akier900/Capstone_Rohde-Schwarz_Team13/Progress Reports/Feb_14_Progress.pdf

# Team 13 Progress Report (Rohde and Schwarz)

Feb 7th to Feb 14th, 2020

# Collective Team Progress

We met w ith you, our advisor about possible routes for protoyping the NLTL technology and started getting materials and components.

We arrived on Wednesday for our meeting w ith Rohde and Schw arz but unfortunately they forgot to make a standing appointment for

the proposal and w e failed to properly confirm the appointment before going dow n. We learned to alw ays put things in w riting and to

send reminders in order to avoid this in the future. We have rescheduled our proposal for Wednesday, Feb 26th at 2:00pm. If you

are able to make this meeting, that w ould be great, but understand if this doesn't w ork w ith your schedule. We have also supplied

them w ith digital copies of both the presentation w e approved on monday as w ell as the slides for our presentation for them to markup

and supply w ith feedback during our next meeting.

# Individual Member Tasks (To complete before next meeting with Industry Sponsors)

## Eric Aki

Search for Varactor SPICE models (In Progress)

Help Juan w ith modeling of varactor CV curves (In Progress)

Applied for and Recieved Free-Sample of recommended Inductors to be used for 144MHz Protoype. (Qty 10.)

## Juan Rivera

Begin Modeling of varactors CV curves as specified by industry sponsors (Matlab or ADS) (In progress)

Complete informal project proposal presentation for industry sponsors

Inquire w ith Dr. Branomir about TeraHertz Lab access

Found resources w hich present a straightforw ard w ay to go about characterizing/measuring our chosen varactor.

## Jianyu Hao

Begin Bill of Materials for project including modeling/simulation softw are and prototyping materials

Help Eric Research Varactors on Digikey

Complete informal project proposal presentation for industry sponsors

Help Eric w ith Gantt Chart.

Compile BOM and add finishing touches to Slideshow presentation

Help w ith ADS/Matlab Simulation (In Progress)

# Blocked

-[] Inquire about signing Intellectual Property forms at next Industry Sponsor Meeting
