akier900/Capstone_Rohde-Schwarz_Team13/Team Schedule/ProjectSchedule.pdf

ID | Assignment Owner | Task Mode | Task Name | Duration | Start | Finish | Predecessors | Resource Names | S
1 | | | Start | 0 days | Wed 1/8/20Wed 1/8/20 | | | Eric,Juan,Oscar
2 | | | Introductory meeting with faculty advisor | 0 days | Sun 1/12/20Sun 1/12/201 | | | Eric,Juan,Oscar
3 | | | Research | 20 days | Wed 1/15/20Tue 2/11/202
4 | | | Read and take notes on article 1 | 2 days | Wed 1/15/20Thu 1/16/202 | | | Eric
5 | | | Read and take notes on article 2 | 2 days | Wed 1/15/20Thu 1/16/202 | | | Juan
6 | | | Read and take notes on article 3 | 2 days | Wed 1/15/20Thu 1/16/202 | | | Oscar
7 | | | Hold team meeting(s) to discuss | 3 days | Mon 1/20/20Wed 1/22/204,5,6 | | | Eric,Juan,Oscar
8 | | | Compile Research Documentation | 6 days | Wed 1/22/20Wed 1/29/207 | | | Eric,Juan,Oscar
9 | | | Introductory Meeting with industry sponsors | 0 days | Wed 1/29/20Wed 1/29/208
10 | | | Refine PDS/Requirements Documentation | 3 days | Wed 2/5/20Fri 2/7/20 | | 7 | Juan
11 | | | Revise Schedule | 3 days | Thu 1/23/20Mon 1/27/207 | | | Eric
12 | | | Prepare Faculty Advisors Progress Update | 1 day | Thu 1/23/20Thu 1/23/207 | | | Oscar
13 Prepare proposal presentation for industry | | | sponsors | 10 days | Wed 1/29/20 | Tue 2/11/20 | 9 Eric,Juan,Oscar
14 | | | End of Prelim Research phase | 0 days | Tue 2/11/20Tue 2/11/2013
15 | | | Model/Simulate | 14 days | Wed 2/12/20Mon 3/2/2014
16 | | | Find Varactor options in digikey | 3 days | Wed 2/12/20Fri 2/14/20 | | 14 | Eric
17 | | | Find/create Varactor spice model or ADS model | 2 days | Wed 2/12/20Thu 2/13/2014 | | | Juan,Eric
18 | | | Simulate using ADS | 7 days | Fri 2/14/20 | Mon 2/24/2017 | | Juan
19 | | | Simulate using MATLAB | 7 days | Fri 2/14/20 | Mon 2/24/2017 | | Eric
20 | | | Compile Simulation documentation | 5 days | Tue 2/25/20Mon 3/2/2016,17,18,19 | | | Eric,Juan,Oscar
21 | | | Create/Update BOM rough draft | 3 days | Tue 2/25/20Thu 2/27/2018 | | | Eric
22 | | | Refine PDS/Requirements Documentation | 3 days | Tue 2/25/20Thu 2/27/2018 | | | Juan
23 | | | Revise Schedule | 3 days | Tue 2/25/20Thu 2/27/2018 | | | Eric
24 | | | Prepare Faculty Advisors Progress Update | 3 days | Wed 2/12/20Fri 2/14/20 | | | Eric
Project: msproj11 Date: Wed 4/22/20 | External Tasks | Manual Summary Rollup

Mar 1, '20

Task

Split

Milestone

Summary

Project Summary

External Milestone

Inactive Task

Inactive Milestone

Inactive Summary

Manual Task

Duration-only

Manual Summary

Start-only

Finish-only

Deadline

Progress

Manual Progress

Page 1

ID | Assignment Owner | Task Mode | Task Name | Duration | Start | Finish | Predecessors | Resource Names | S
25 Prepare Progress Update Presentation for | | | Industry Sponsors | 10 days | Wed 2/12/20 | Tue 2/25/20 | | Eric,Juan,Oscar
26 | | | End of Prelim Model and Simulation phase | 0 days | Thu 2/27/20Thu 2/27/2023
27 Research Board design for other Varactor loaded | | | TX Lines | 12 days | Fri 2/28/20 | Mon 3/16/20 | 26
28 Read and take notes on article (S-parameter | | | De-embedding) | 2 days | Fri 2/28/20 | Mon 3/2/20 | 26 Oscar
29 Read and take notes on article (Measuring Board | | | Characteristics) | 2 days | Fri 2/28/20 | Mon 3/2/20 | 26 Juan
30 Read and take notes on article (High Frequency | | | PCB Design) | 2 days | Fri 2/28/20 | Mon 3/2/20 | 26 Eric
31 | | | Hold team meeting to discuss | 7 days | Tue 3/3/20 | Wed 3/11/2028,29,30 | | Oscar,Juan,Eric
32 | | | Refine PDS/Requirements Documentation | 3 days | Thu 3/12/20Mon 3/16/2031 | | | Eric
33 | | | Revise Schedule | 3 days | Thu 3/12/20Mon 3/16/2031 | | | Juan
34 Prepare Progress Update Presentation for | | | Industry Sponsors | 10 days | Fri 2/28/20 | Thu 3/12/20 | | Eric,Juan,Oscar
35 | | | Prepare Faculty Advisors Progress Update | 3 days | Fri 2/28/20 | Tue 3/3/20 | | Eric
36 | | | End of Low Frequency Research | 0 days | Mon 3/16/20Mon 3/16/2033
37 | | | Initial Prototype (144Mhz) | 57 days? | Tue 3/17/20Tue 6/2/20 | | 36
38 | | | Design 144MHZ PCB in Altium | 5 days | Tue 3/17/20Mon 3/23/20 | | | Eric
39 Final board check before submission to Board | | | House | 1 day | Tue 3/24/20 | Tue 3/24/20 | | Eric,Oscar,Juan
40 | | | Place OSHPark Order | 0 days | Wed 3/25/20Wed 3/25/20 | | | Eric
41 | | | Receive boards from OSHPark | 0 days | Sat 4/4/20 | Sat 4/4/20
42 | | | Assemble Board | 1 day | Mon 4/6/20Mon 4/6/2040 | | | Eric

Mar 1, '20

Task

Split

Milestone

Summary

Project Summary

External Tasks

External Milestone

Inactive Task

Inactive Milestone

Inactive Summary

Manual Task

Duration-only

Manual Summary Rollup

Manual Summary

Start-only

Finish-only

Deadline

Progress

Manual Progress

Page 2

Project: msproj11
Date: Wed 4/22/20

ID | Assignment Owner | Task Mode | Task Name | Duration | Start | Finish | Predecessors | Resource Names | S
43 | | | Refine PDS/Requirements Documentation | 2 days | Thu 4/9/20 | Fri 4/10/20 | | Eric
44 | | | Board Continuity/Assembly Check | 0 days | Sat 4/11/20 Sat 4/11/20 | | | Eric
45 | | | Transient Simulations | 26.75 days Tue 3/17/20Tue 4/21/20
46 | | | Find values for modeling component parasitics | 5 days | Tue 3/17/20Mon 3/30/2040 | | | Eric
47 | | | Simulate Rise Time Vs. Tx Line Length | 17 days | Tue 3/17/20Tue 4/21/2046 | | | Eric
48 | | | Simulate Rise Time Vs. DC Bias | 17 days | Tue 3/17/20Tue 4/21/2046 | | | Eric
49 | | | Frequency Domain Simulations | 7 days | Tue 4/21/20Thu 4/30/2048 | | | Eric
50 | | | Measurements | 34 days | Tue 3/17/20Thu 4/30/20
51 Time Domain Rise time Measurements vs DC | | | Bias | 7 days | Tue 3/17/20 | Wed 3/25/20 | | Eric
52 | | | Frequency Domain Measurements (NanoVNA) | 11 days | Tue 4/7/20 | Tue 4/21/2042 | | Eric
53 | | | Compile/Analyze 144Mhz Measurement Results7 days | | Wed 4/22/20Thu 4/30/2052
54 | | | End of Initial Prototype phase | 0 days | Sat 4/11/20 Sat 4/11/20 44
55 | | | 6Ghz Model Research/Design | 42 days? | Mon 4/6/20Tue 6/2/20
56 | | | Transient Simulations | 12 days | Mon 4/6/20Fri 5/15/20 | | 53
57 | | | S-Param Simulations | 12 days | Fri 5/1/20 | Mon 5/18/2053
58 | | | EM Simulations | 12 days | Fri 5/1/20 | Mon 5/18/2053
59 | | | Drafting of White Paper | 11 days? | Tue 5/19/20Tue 6/2/20
60 | | | First Draft Creation | 1 day? | Tue 5/19/20Tue 5/19/2058
61 | | | First Draft Submitted to Sponsors | 0 days | Tue 5/19/20Tue 5/19/20
62 | | | Review Revisions | 5 days | Wed 5/20/20Tue 5/26/2061
63 | | | Second Draft Creation | 5 days | Wed 5/27/20Tue 6/2/20 | | 62
64 | | | Second Draft Submittal | 0 days | Tue 6/2/20 | Tue 6/2/20 | 63
65 | | | Presentation/Project Wrap up | 33 days? | Wed 4/22/20Sun 6/7/20 | | 52
66 | | | Compile all documentation | 14 days | Wed 4/22/20Mon 5/11/2026
Project: msproj11 Date: Wed 4/22/20 | External Tasks | Manual Summary Rollup

Mar 1, '20

Task

Split

Milestone

Summary

Project Summary

External Milestone

Inactive Task

Inactive Milestone

Inactive Summary

Manual Task

Duration-only

Manual Summary

Start-only

Finish-only

Deadline

Progress

Manual Progress

Page 3

ID | Assignment Owner | Task Mode | Task Name | Duration | Start | Finish | Predecessors | Resource Names | S
67 | | | Present Results to Industry Sponsors | 7 days | Tue 5/12/20Wed 5/20/2066
68 | | | Technical Work Stops (Official) | 0 days | Mon 6/1/20Mon 6/1/20
69 | | | Prepare for presentation speaking roles | 2 days? | Mon 6/1/20Tue 6/2/20
70 | | | Poster Board Creation | 5 days | Mon 6/1/20Fri 6/5/20
71 | | | Poster due for Poster Session | 0 days | Sun 6/7/20 | Sun 6/7/20

Mar 1, '20

Task

Split

Milestone

Summary

Project Summary

External Tasks

External Milestone

Inactive Task

Inactive Milestone

Inactive Summary

Manual Task

Duration-only

Manual Summary Rollup

Manual Summary

Start-only

Finish-only

Deadline

Progress

Manual Progress

Page 4

Project: msproj11
Date: Wed 4/22/20

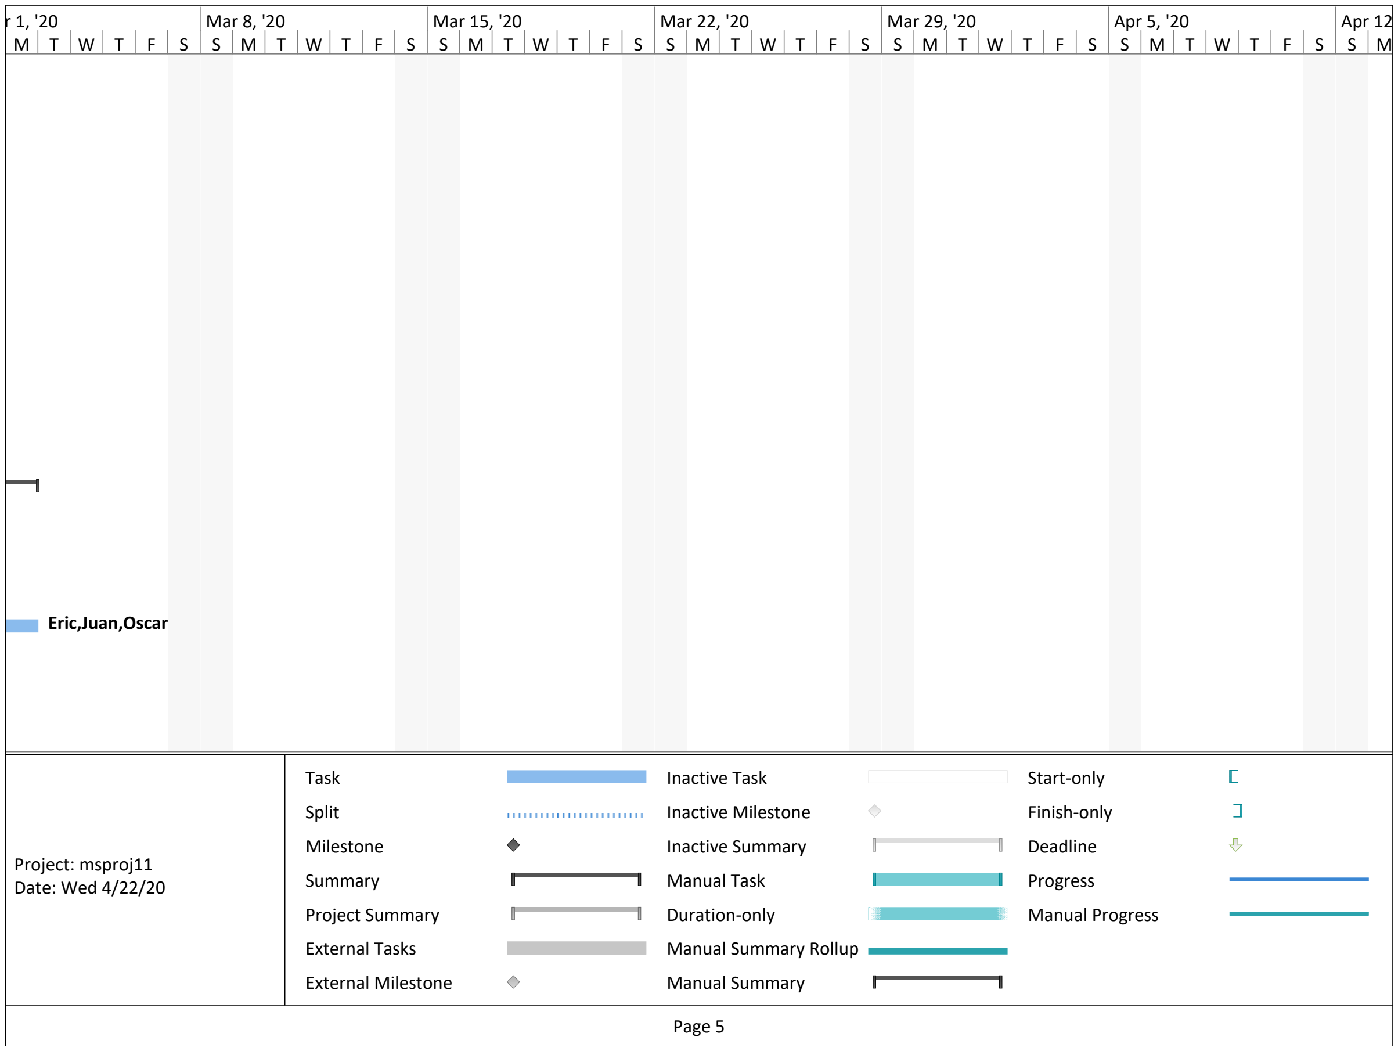
[picture p36: figure]
Eric,Juan,Oscar; Mar 8, '20; Mar 15, '20; Mar 22, '20; Mar 29, '20; Apr 5, '20; Apr 12, '20; Task; Split; Milestone; Summary; Project Summary; External Tasks; External Milestone; Inactive Task; Inactive Milestone; Inactive Summary; Manual Task; Duration-only; Manual Summary Rollup; Manual Summary; Start-only; Finish-only; Deadline; Progress; Manual Progress; Page 5; Project: msproj11 Date: Wed 4/22/20
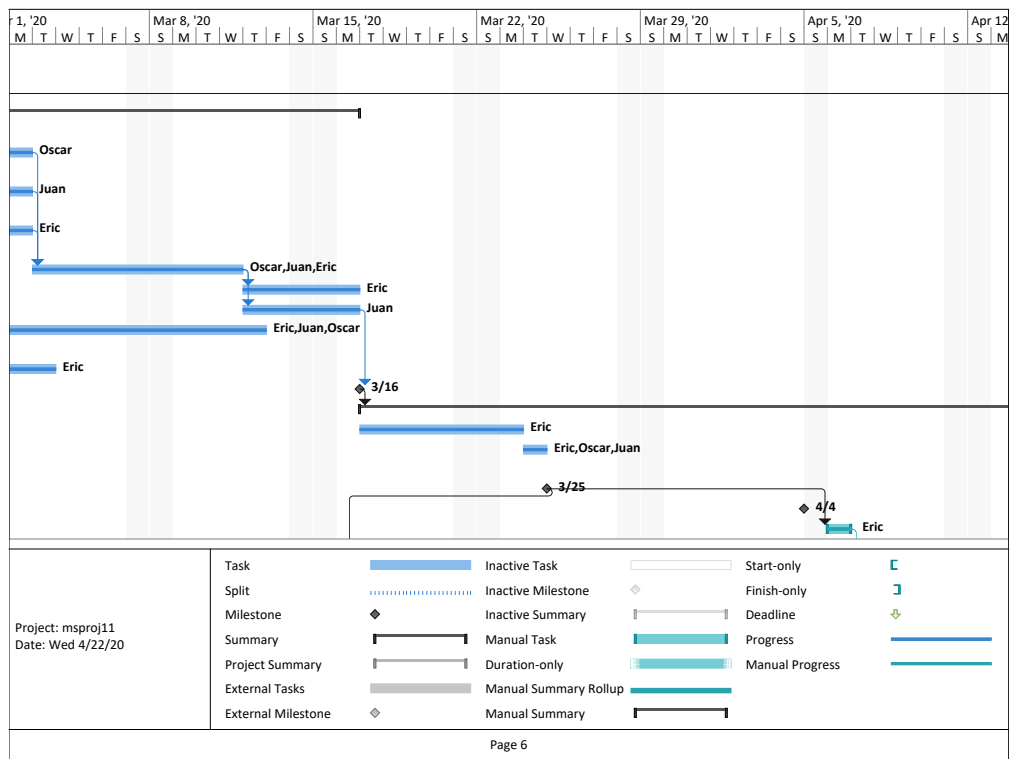
[picture p37: page 6]
Oscar; Juan; Eric; Mar 8, '20; Mar 15, '20; Mar 22, '20; Mar 29, '20; Apr 5, '20; Apr 12, '20; Task; Split; Milestone; Summary; Project Summary; External Tasks; External Milestone; Inactive Task; Inactive Milestone; Inactive Summary; Manual Task; Duration-only; Manual Summary; Start-only; Finish-only; Deadline; Progress; Manual Progress; Page 6; Project: msproj11 Date: Wed 4/22/20

Oscar,Juan,Eric

Eric,Juan,Oscar

Eric
Eric,Oscar,Juan

Manual Summary Rollup

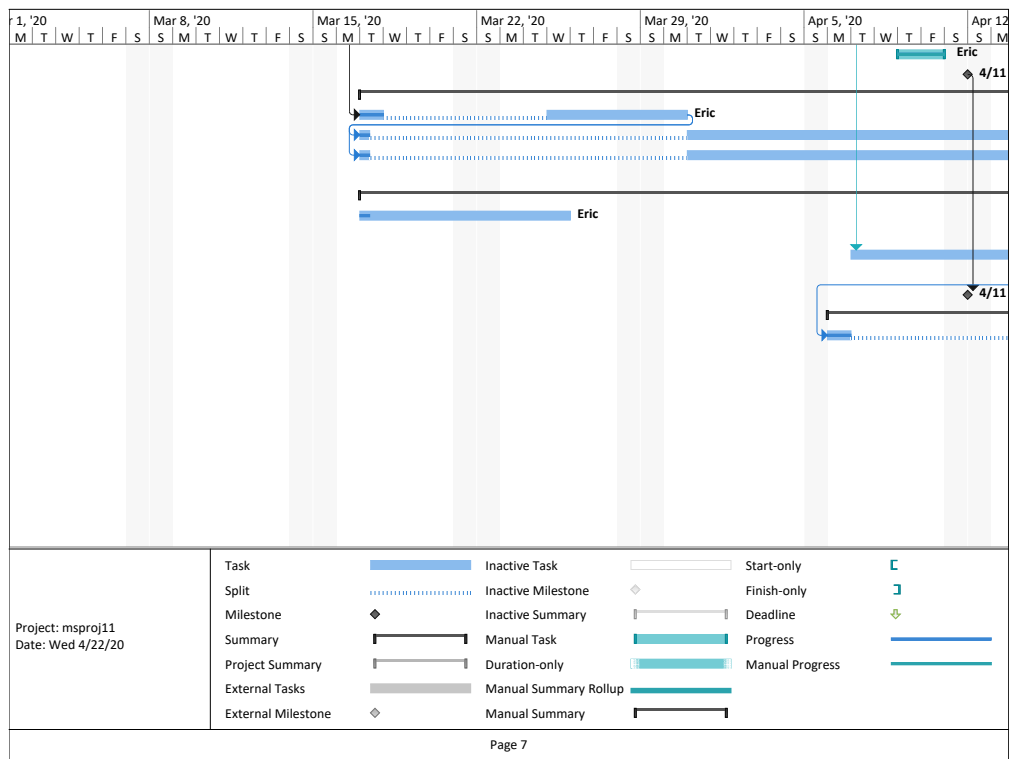
[picture p38: page 7]
Eric; Mar 8, '20; Mar 15, '20; Mar 22, '20; Mar 29, '20; Apr 5, '20; Apr 12, '20; Task; Split; Milestone; Summary; Project Summary; External Tasks; External Milestone; Inactive Task; Inactive Milestone; Inactive Summary; Manual Task; Duration-only; Manual Summary; Start-only; Finish-only; Deadline; Progress; Manual Progress; Page 7; Project: msproj11 Date: Wed 4/22/20

Manual Summary Rollup

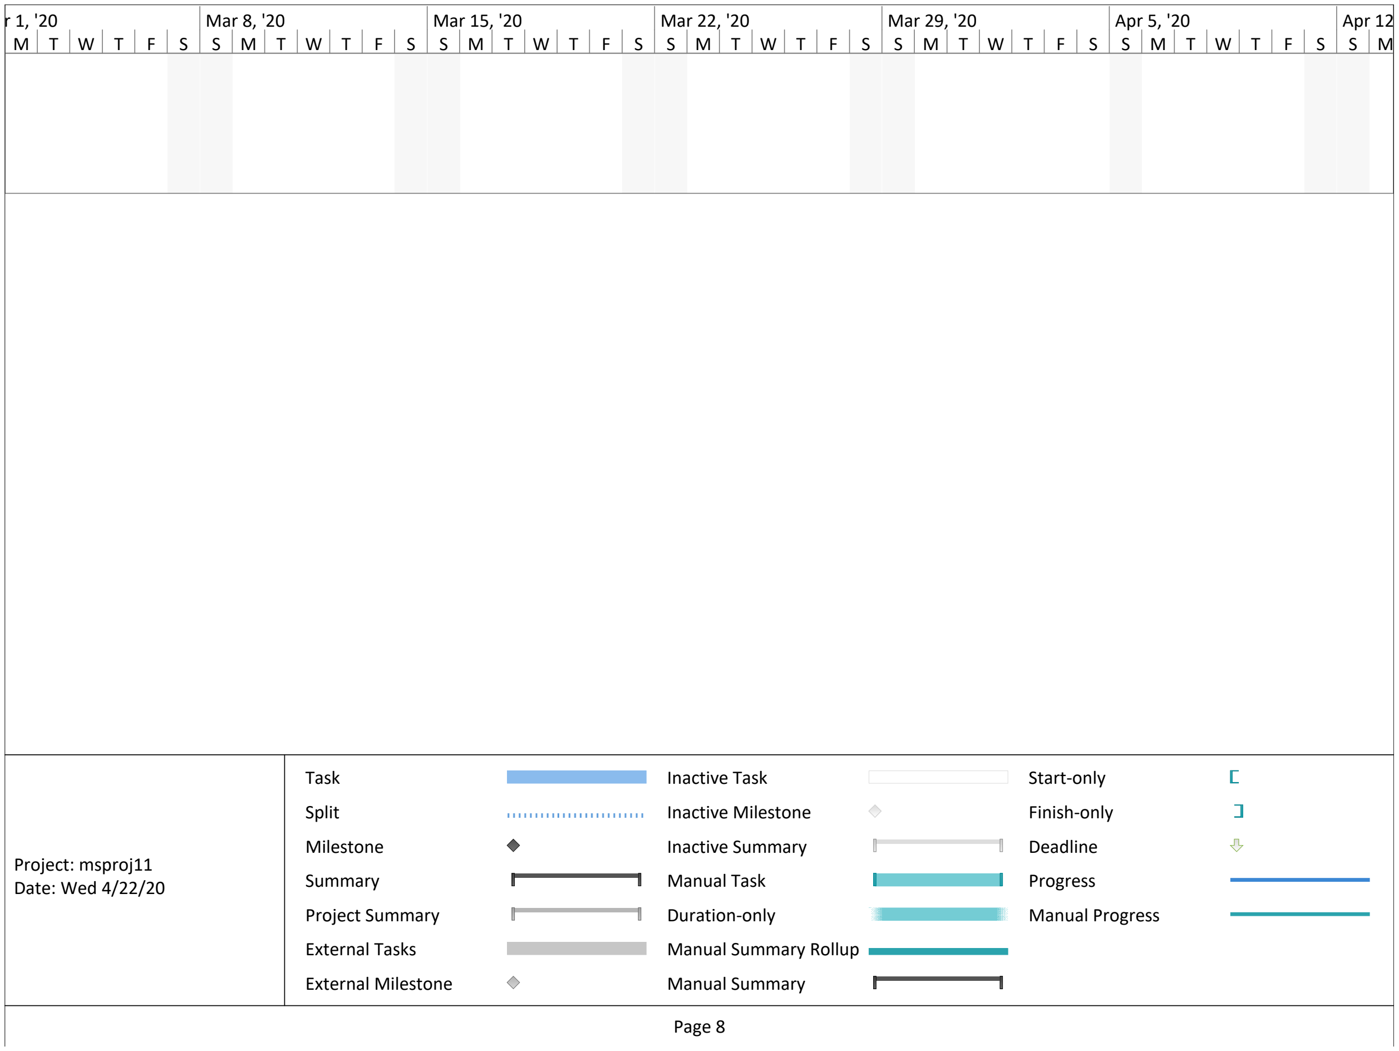
[picture p39: figure]
Mar 8, '20; Mar 15, '20; Mar 22, '20; Mar 29, '20; Apr 5, '20; Apr 12, '20; Task; Split; Milestone; Summary; Project Summary; External Tasks; External Milestone; Inactive Task; Inactive Milestone; Inactive Summary; Manual Task; Duration-only; Manual Summary Rollup; Manual Summary; Start-only; Finish-only; Deadline; Progress; Manual Progress; Page 8; Project: msproj11 Date: Wed 4/22/20

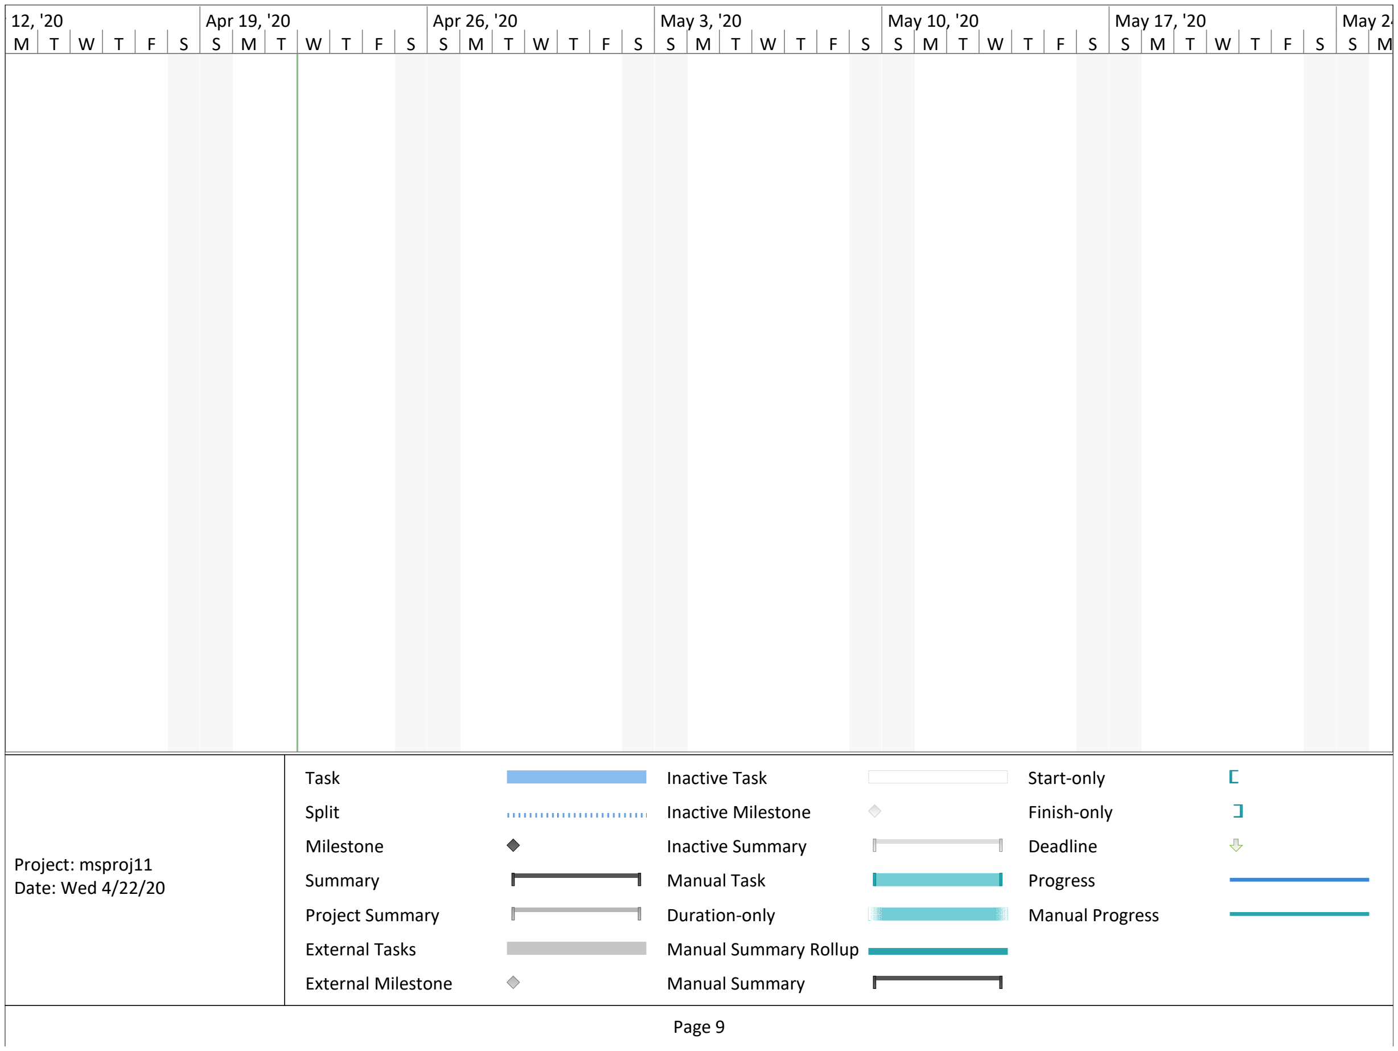
[picture p40: figure]
Apr 12, '20; Apr 19, '20; Apr 26, '20; May 3, '20; May 10, '20; May 17, '20; May 24, '20; Task; Split; Milestone; Summary; Project Summary; External Tasks; External Milestone; Inactive Task; Inactive Milestone; Inactive Summary; Manual Task; Duration-only; Manual Summary Rollup; Manual Summary; Start-only; Finish-only; Deadline; Progress; Manual Progress; Page 9; Project: msproj11 Date: Wed 4/22/20

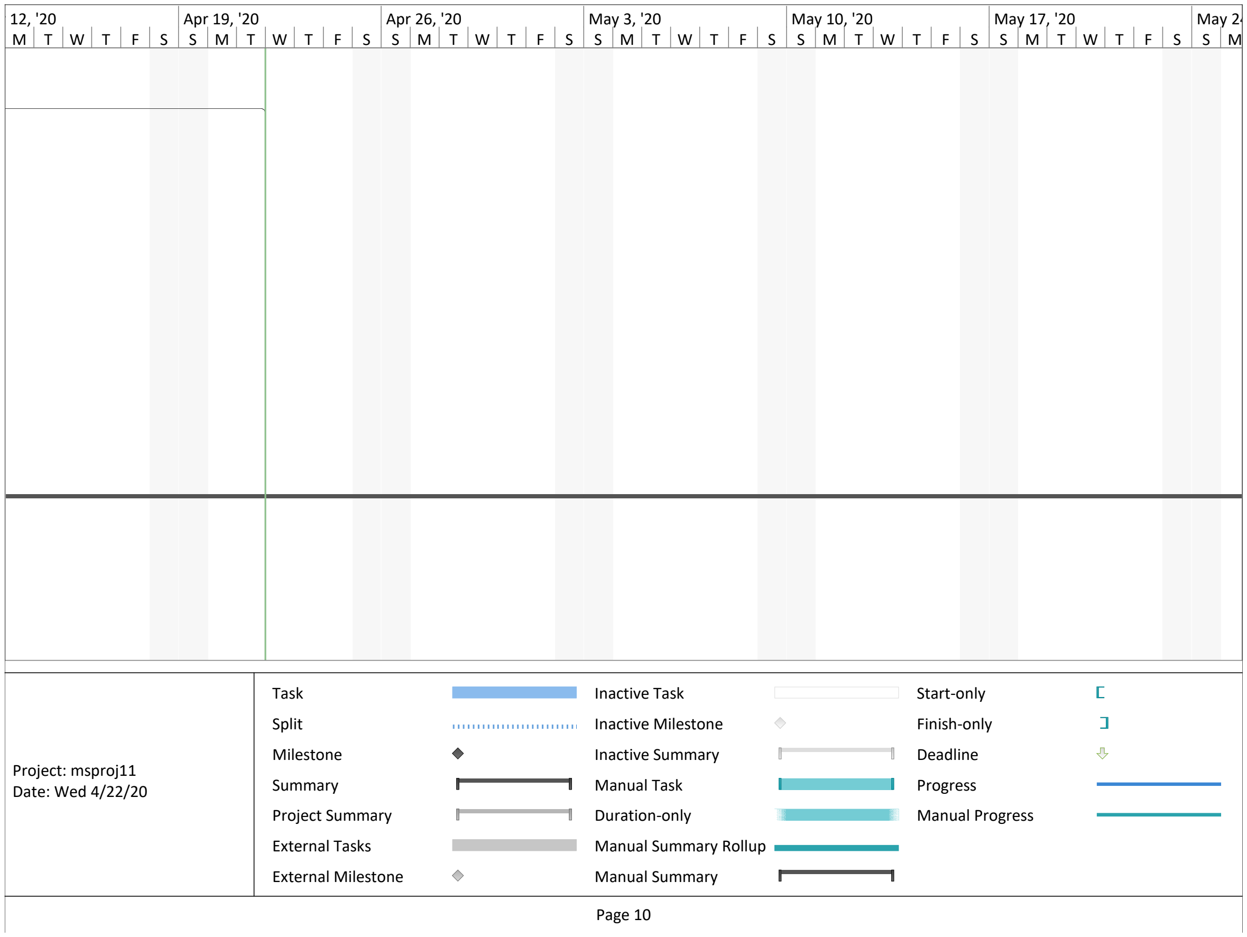
[picture p41: figure]
Apr 12, '20; Apr 19, '20; Apr 26, '20; May 3, '20; May 10, '20; May 17, '20; May 24, '20; Task; Split; Milestone; Summary; Project Summary; External Tasks; External Milestone; Inactive Task; Inactive Milestone; Inactive Summary; Manual Task; Duration-only; Manual Summary Rollup; Manual Summary; Start-only; Finish-only; Deadline; Progress; Manual Progress; Page 10; Project: msproj11 Date: Wed 4/22/20
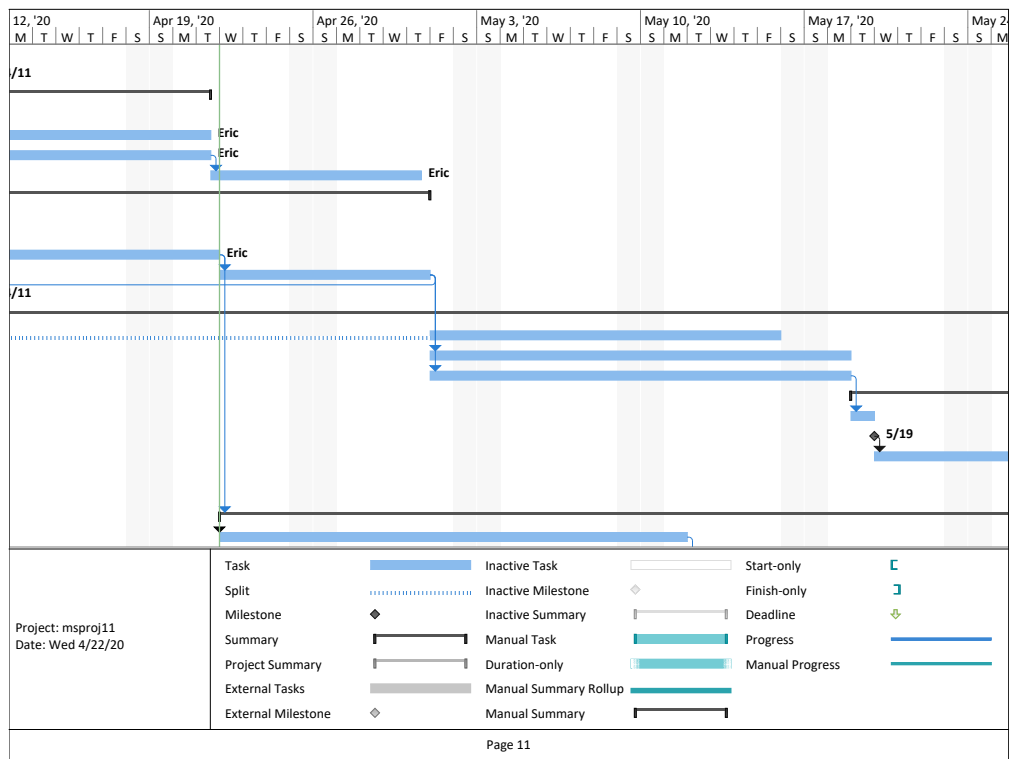
[picture p42: page 11]
Eric; Apr 12, '20; Apr 19, '20; Apr 26, '20; May 3, '20; May 10, '20; May 17, '20; May 24, '20; Task; Split; Milestone; Summary; Project Summary; External Tasks; External Milestone; Inactive Task; Inactive Milestone; Inactive Summary; Manual Task; Duration-only; Manual Summary; Start-only; Finish-only; Deadline; Progress; Manual Progress; Page 11; Project: msproj11 Date: Wed 4/22/20

Manual Summary Rollup

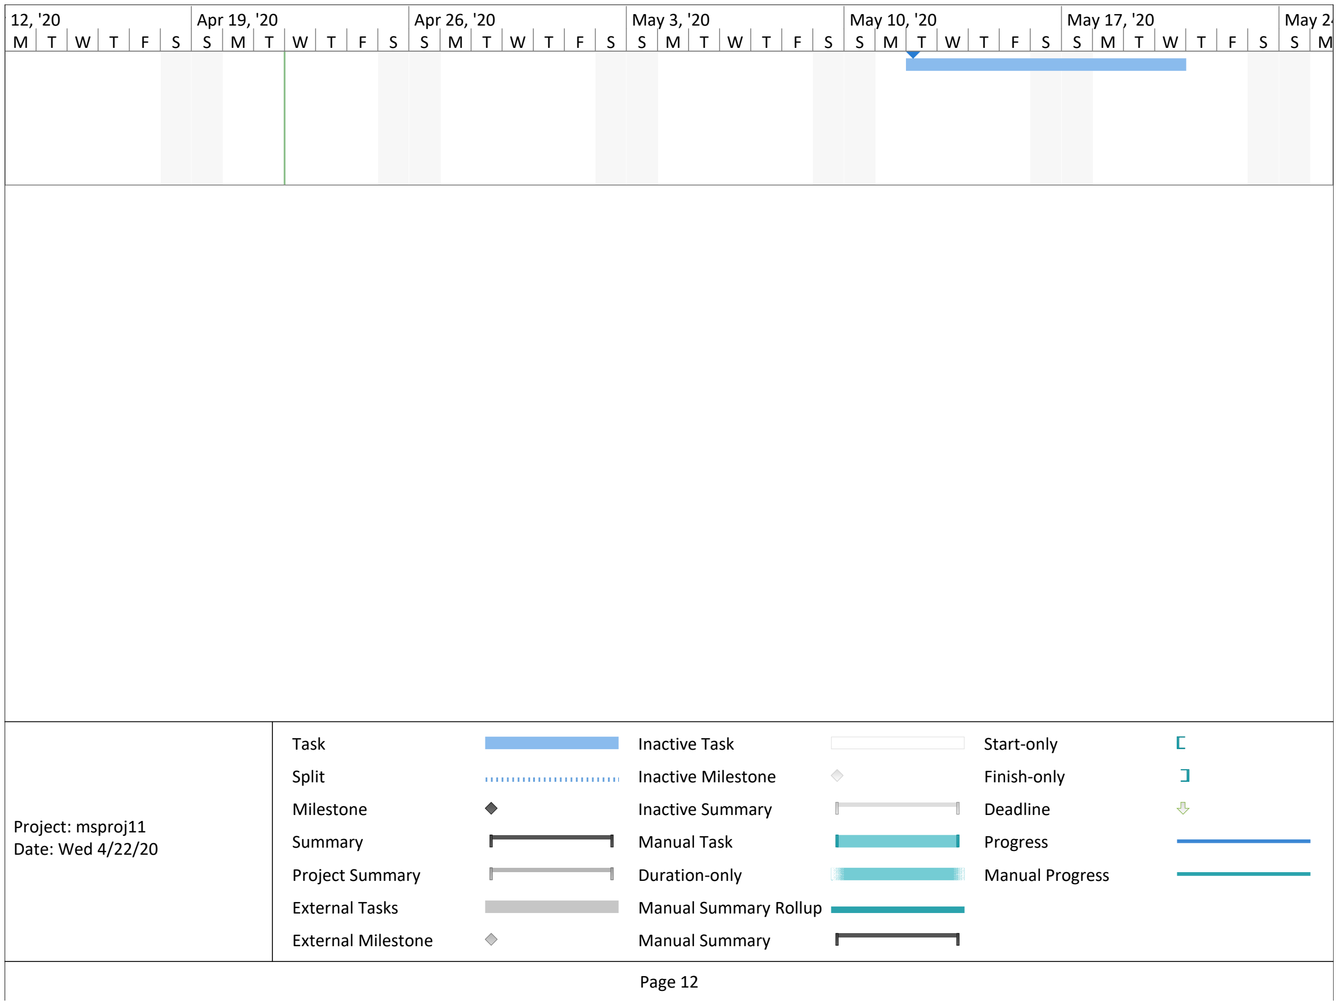
[picture p43: figure]
Apr 12, '20; Apr 19, '20; Apr 26, '20; May 3, '20; May 10, '20; May 17, '20; May 24, '20; Task; Split; Milestone; Summary; Project Summary; External Tasks; External Milestone; Inactive Task; Inactive Milestone; Inactive Summary; Manual Task; Duration-only; Manual Summary Rollup; Manual Summary; Start-only; Finish-only; Deadline; Progress; Manual Progress; Page 12; Project: msproj11 Date: Wed 4/22/20
