akier900/Capstone_Rohde-Schwarz_Team13/Simulations/S-param/greekletterpractice.pdf

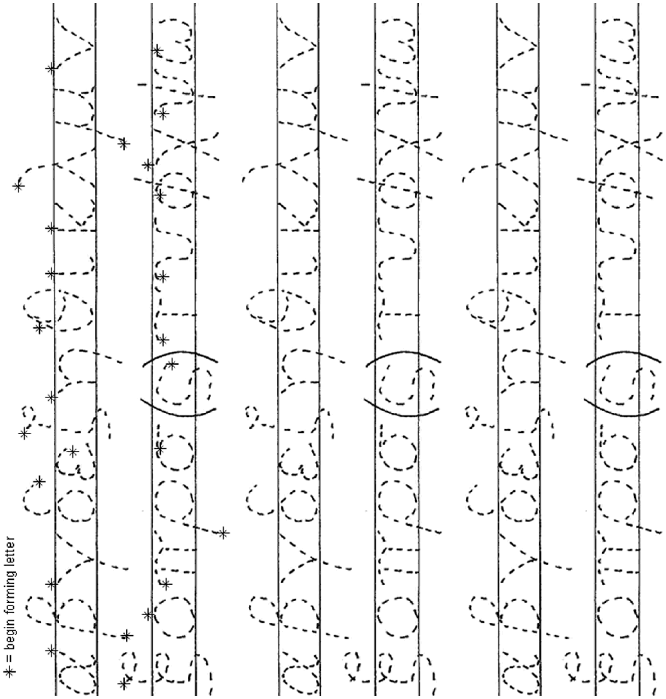
[picture p44: page 1]
