akier900/Capstone_Rohde-Schwarz_Team13/MeetingFiles/FilesForMeeting_5_13_2020/risetimeGuess.pdf

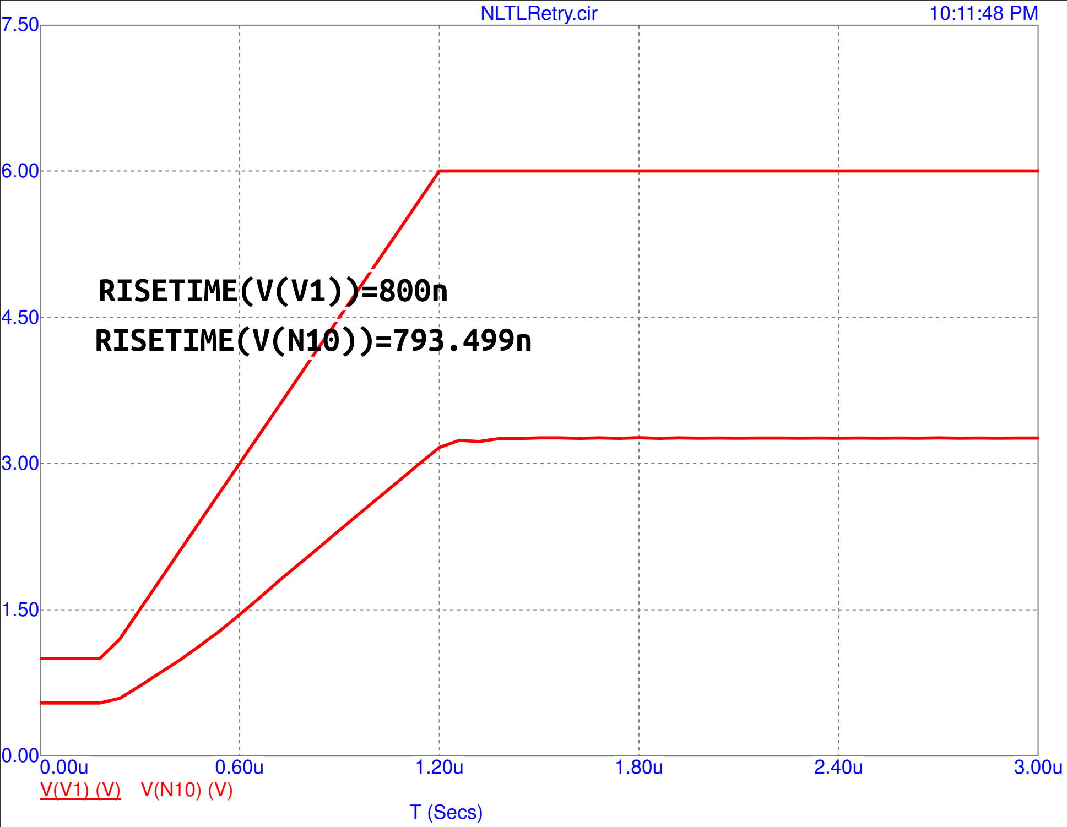
[picture p45: figure]
T (Secs); NLTLRetry.cir; RISETIME(V(N10))=793.499n; RISETIME(V(V1))=800n
