akier900/Capstone_Rohde-Schwarz_Team13/RohdeAndSchwarzWhitePaper/images/risetimeGuessNOLoss.pdf

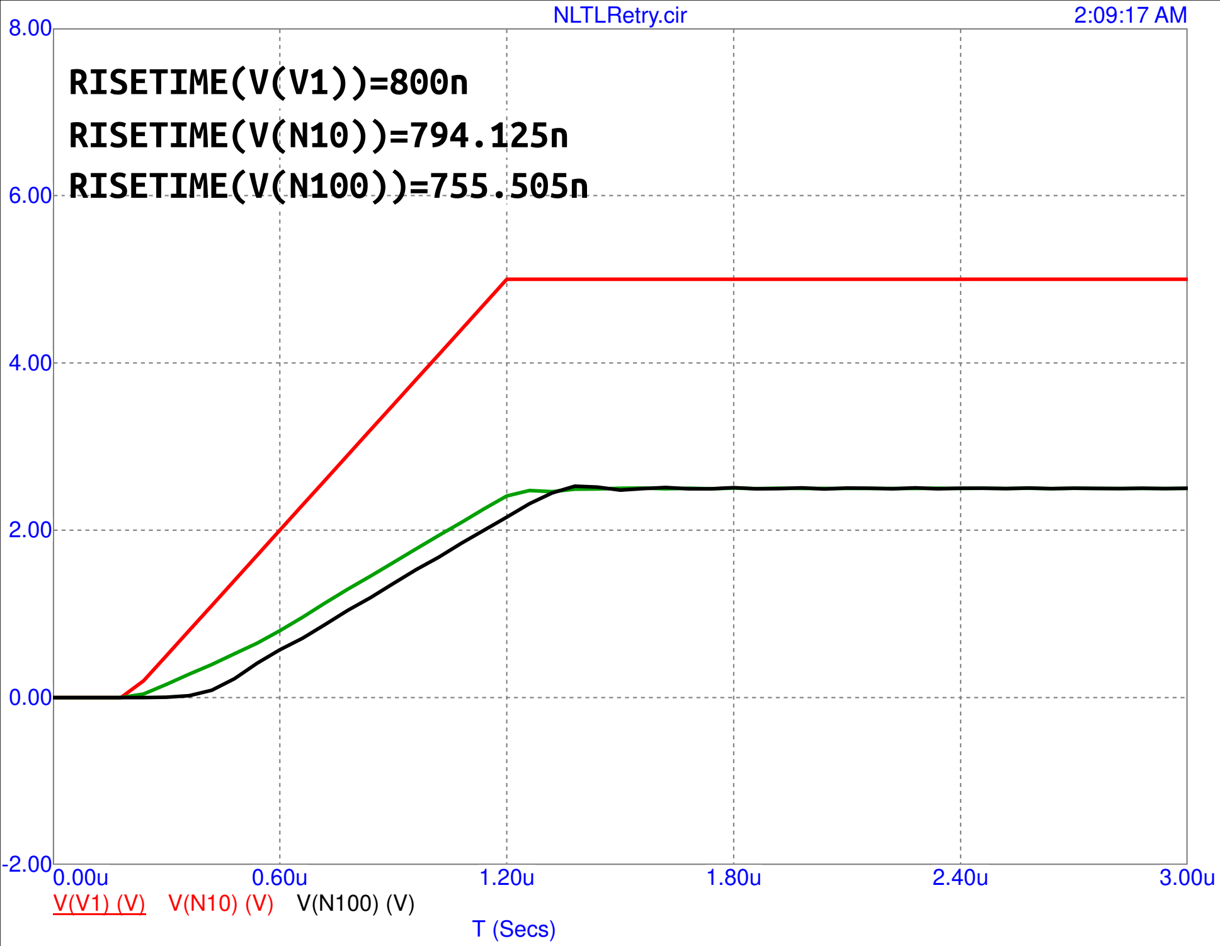
[picture p46: figure]
T (Secs); NLTLRetry.cir; RISETIME(V(N100))=755.505n; RISETIME(V(N10))=794.125n; RISETIME(V(V1))=800n
