akier900/Capstone_Rohde-Schwarz_Team13/RohdeAndSchwarzWhitePaper/images/risetimeGuessWLoss.pdf

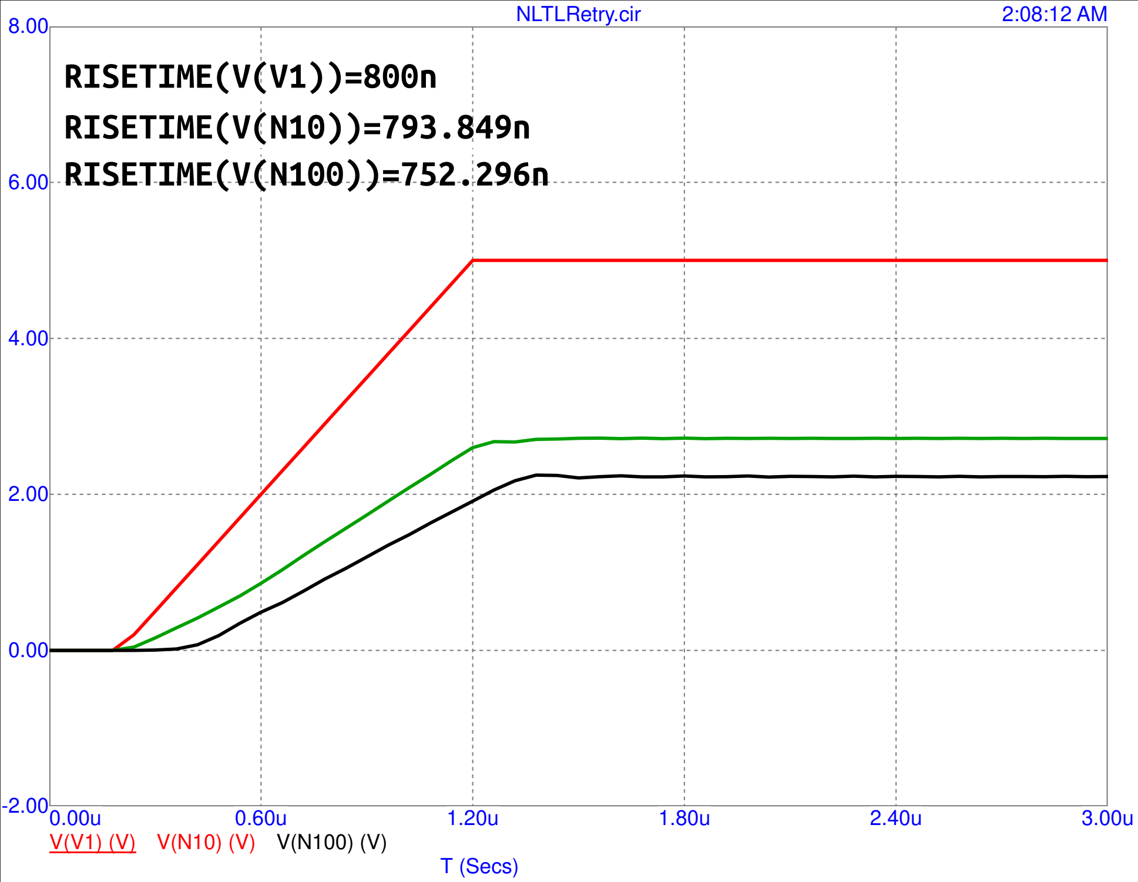
[picture p47: figure]
T (Secs); NLTLRetry.cir; RISETIME(V(N100))=752.296n; RISETIME(V(N10))=793.849n; RISETIME(V(V1))=800n
