akier900/Capstone_Rohde-Schwarz_Team13/RohdeAndSchwarzWhitePaper/images/RiseTimeVsDCBIASVsLength.pdf

Rs

50

D1
BBY40
V1

DC 400m AC 1 0 Pulse 1 6 200n 400n 0 10

L1
56n

R7
0.122

D2
BBY40

L2
56n

R8
0.122

D3
BBY40

L3
56n

R9
0.122

D4
BBY40

L4
56n

R10
0.122

D5
BBY40

L5
56n

R11
0.122

R12
10Meg

R40
0.122

D6
BBY40

L6
56n

R41
0.122

D7
BBY40

L7
56n

R42
0.122

D8
BBY40

L8
56n

R43
0.122

D9
BBY40

L9
56n

R44
0.122

D10
BBY40

L10
56n

D11
BBY40

L11
56n

R45
0.122

D12
BBY40

L12
56n

R46
0.122

D13
BBY40

L13
56n

R47
0.122

D14
BBY40

L14
56n

R48
0.122

D15
BBY40

L15
56n

R49
0.122

R50
10Meg

R51
0.122

D16
BBY40

L16
56n

R52
0.122

D17
BBY40

L17
56n

R53
0.122

D18
BBY40

L18
56n

R54
0.122

D19
BBY40

L19
56n

R55
0.122

D20
BBY40

L20
56n

D21
BBY40

L21
56n

R56
0.122

D22
BBY40

L22
56n

R57
0.122

D23
BBY40

L23
56n

R58
0.122

D24
BBY40

L24
56n

R59
0.122

D25
BBY40

L25
56n

R60
0.122

R61
10Meg

R62
0.122

D26
BBY40

L26
56n

R63
0.122

D27
BBY40

L27
56n

R64
0.122

D28
BBY40

L28
56n

R65
0.122

D29
BBY40

L29
56n

R66
0.122

D30
BBY40

L30
56n

D31
BBY40

L31
56n

R67
0.122

D32
BBY40

L32
56n

R68
0.122

D33
BBY40

L33
56n

R69
0.122

D34
BBY40

L34
56n

R70
0.122

D35
BBY40

L35
56n

R71
0.122

R72
10Meg

R73
0.122

D36
BBY40

L36
56n

R74
0.122

D37
BBY40

L37
56n

R75
0.122

D38
BBY40

L38
56n

R76
0.122

D39
BBY40

L39
56n

R77
0.122

D40
BBY40

L40
56n

D41
BBY40

L41
56n

R78
0.122

D42
BBY40

L42
56n

R79
0.122

D43
BBY40

L43
56n

R80
0.122

D44
BBY40

L44
56n

R81
0.122

D45
BBY40

L45
56n

R82
0.122

Rload_prev
10Meg

R84
0.122

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
4.829 | 4.816 | 4.803 | 4.79 | 4.778 | 4.765 | 4.752 | 4.741 | 4.732 | 4.723
4.713 | 4.704 | 4.694 | 4.684 | 4.674 | 4.664 | 4.654 | 4.644 | 4.634 | 4.623

5.069

4.963

4.841

4.723

4.623 | 4.613 | 4.602 | 4.592 | 4.581 | 4.571 | 4.56 | 4.549 | 4.539 | 4.528 | 4.517

12.00

16.00

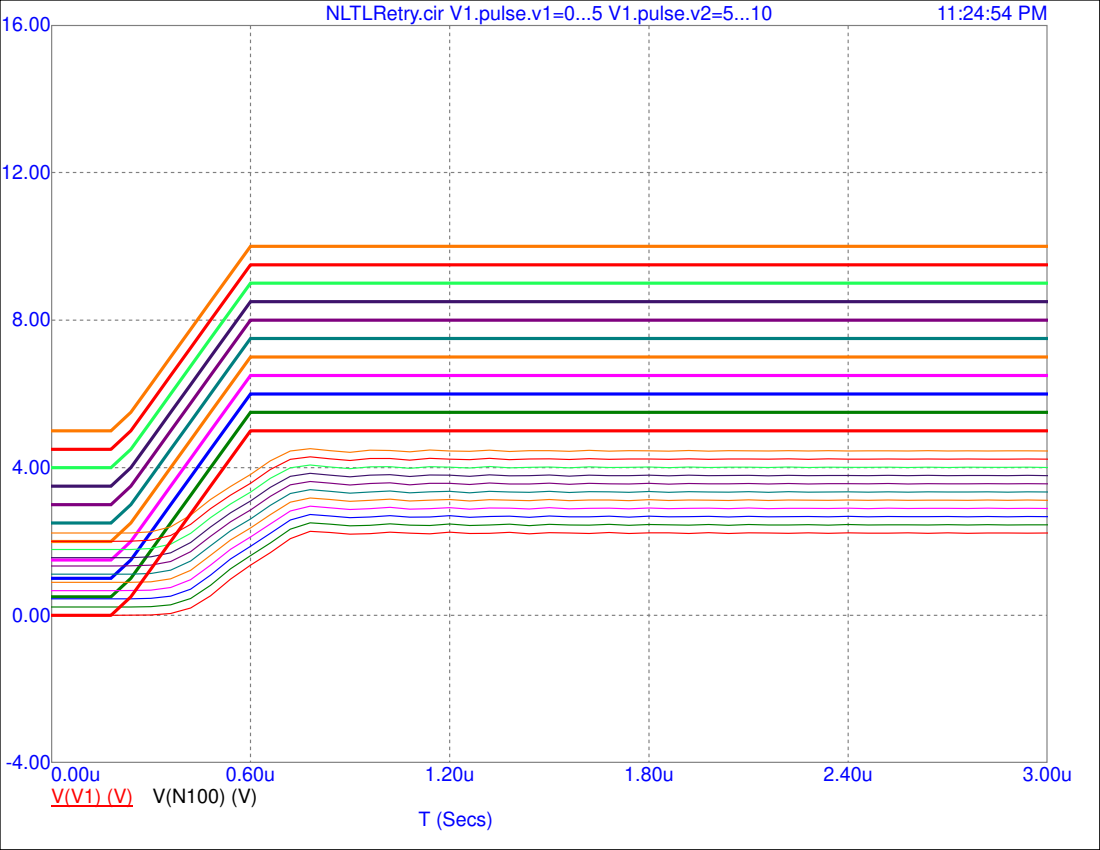
[picture p48: page 2]
T (Secs); NLTLRetry.cir V1.pulse.v1=0...5 V1.pulse.v2=5...10

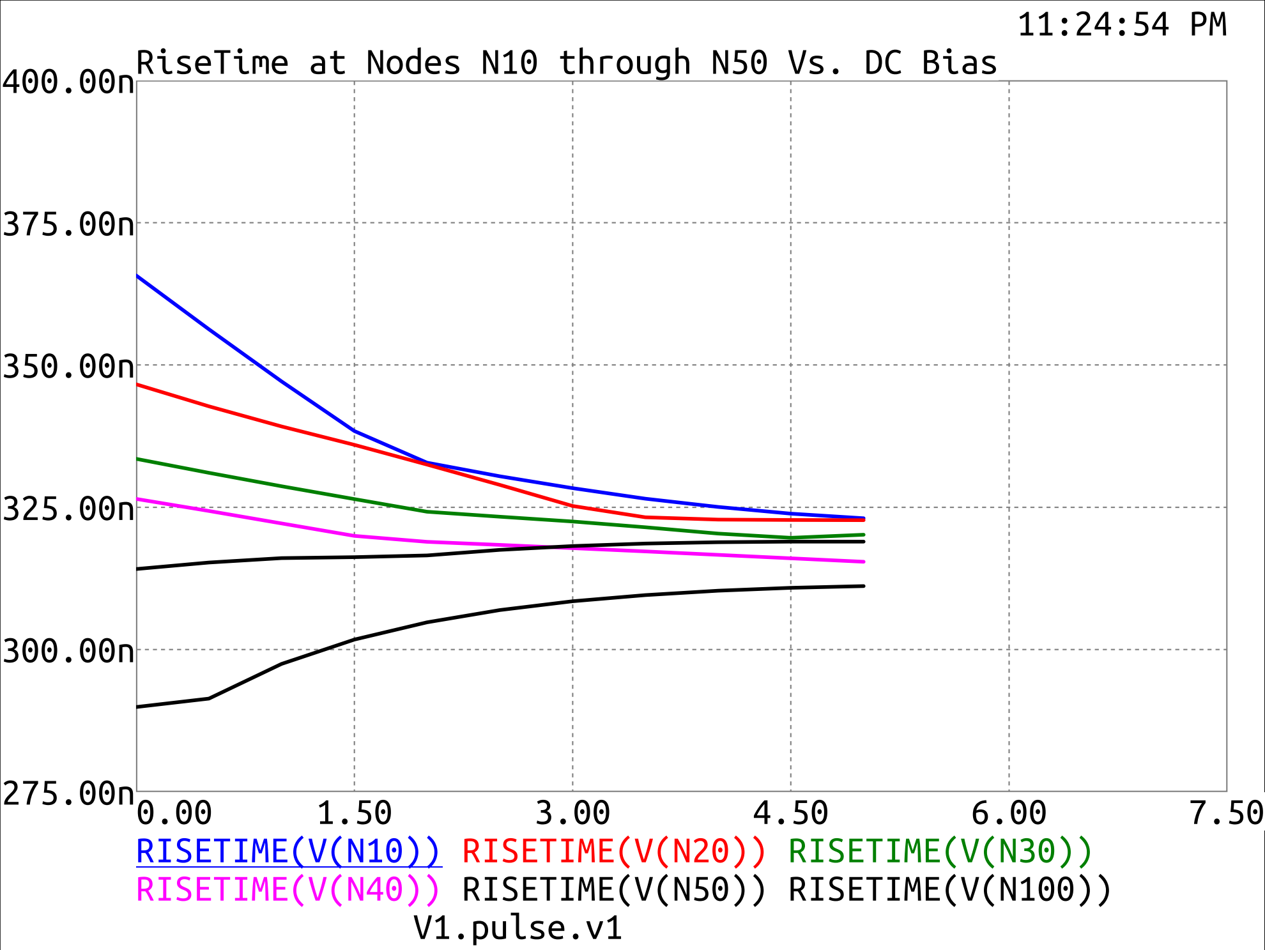
[picture p49: figure]
RISETIME(V(N10)); V1.pulse.v1; RISETIME(V(N20)); RISETIME(V(N30))

RISETIME(V(N40)) | RISETIME(V(N50)) | RISETIME(V(N100))

# RiseTime at Nodes N10 through N50 Vs. DC Bias
