akier900/Capstone_Rohde-Schwarz_Team13/RohdeAndSchwarzWhitePaper/images/B1_Page_08.png

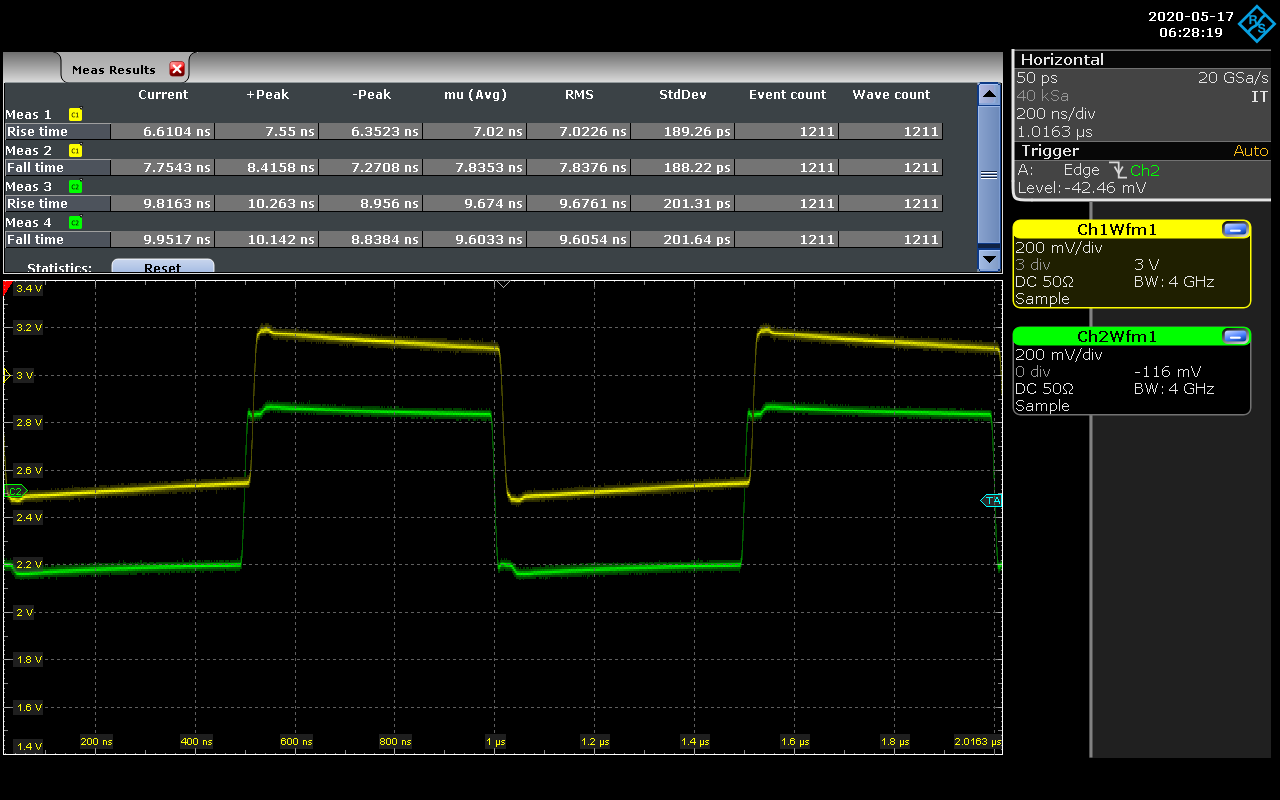
RohdeAndSchwarzWhitePaper/images/B1_Page_08.png
