akier900/Capstone_Rohde-Schwarz_Team13/RohdeAndSchwarzWhitePaper/images/B1_Page_11.png

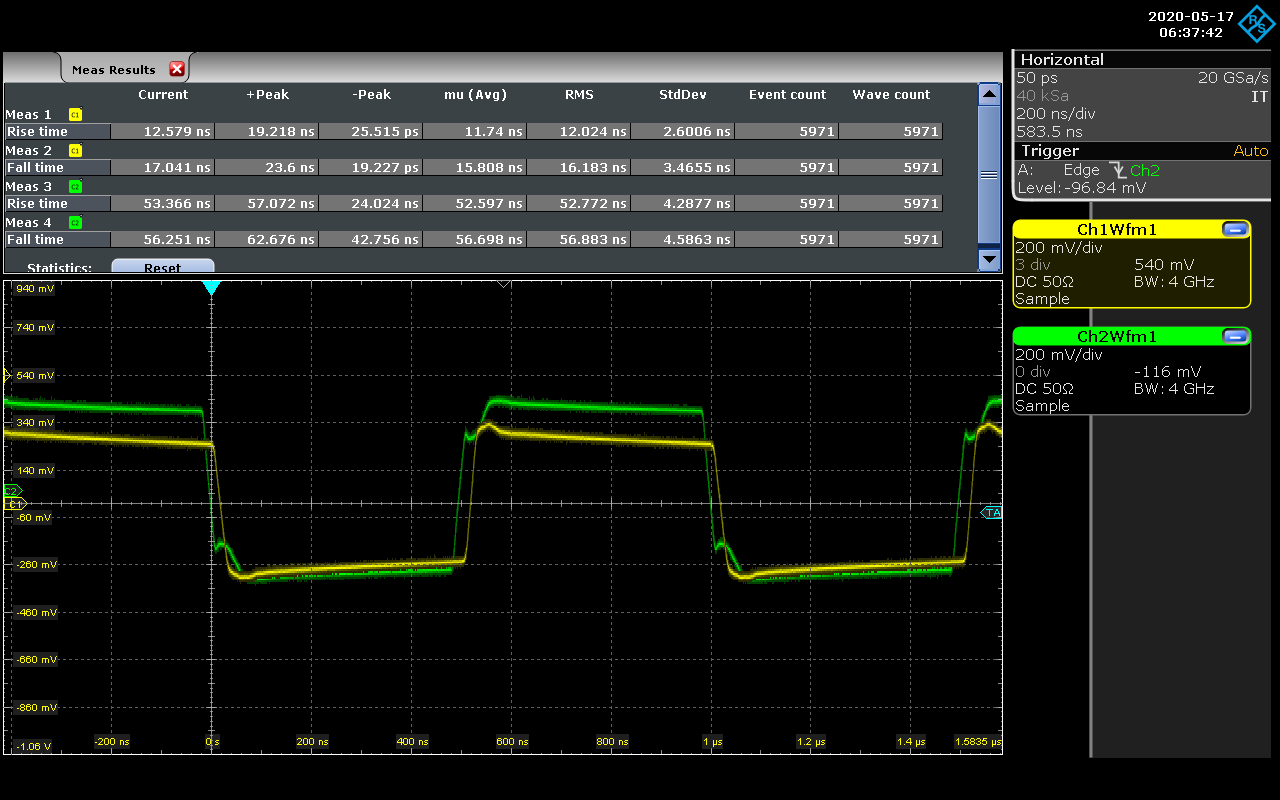
RohdeAndSchwarzWhitePaper/images/B1_Page_11.png
