akier900/Capstone_Rohde-Schwarz_Team13/RohdeAndSchwarzWhitePaper/images/Fixed_ZeroBias_Sparam_Sims_Page_2.png

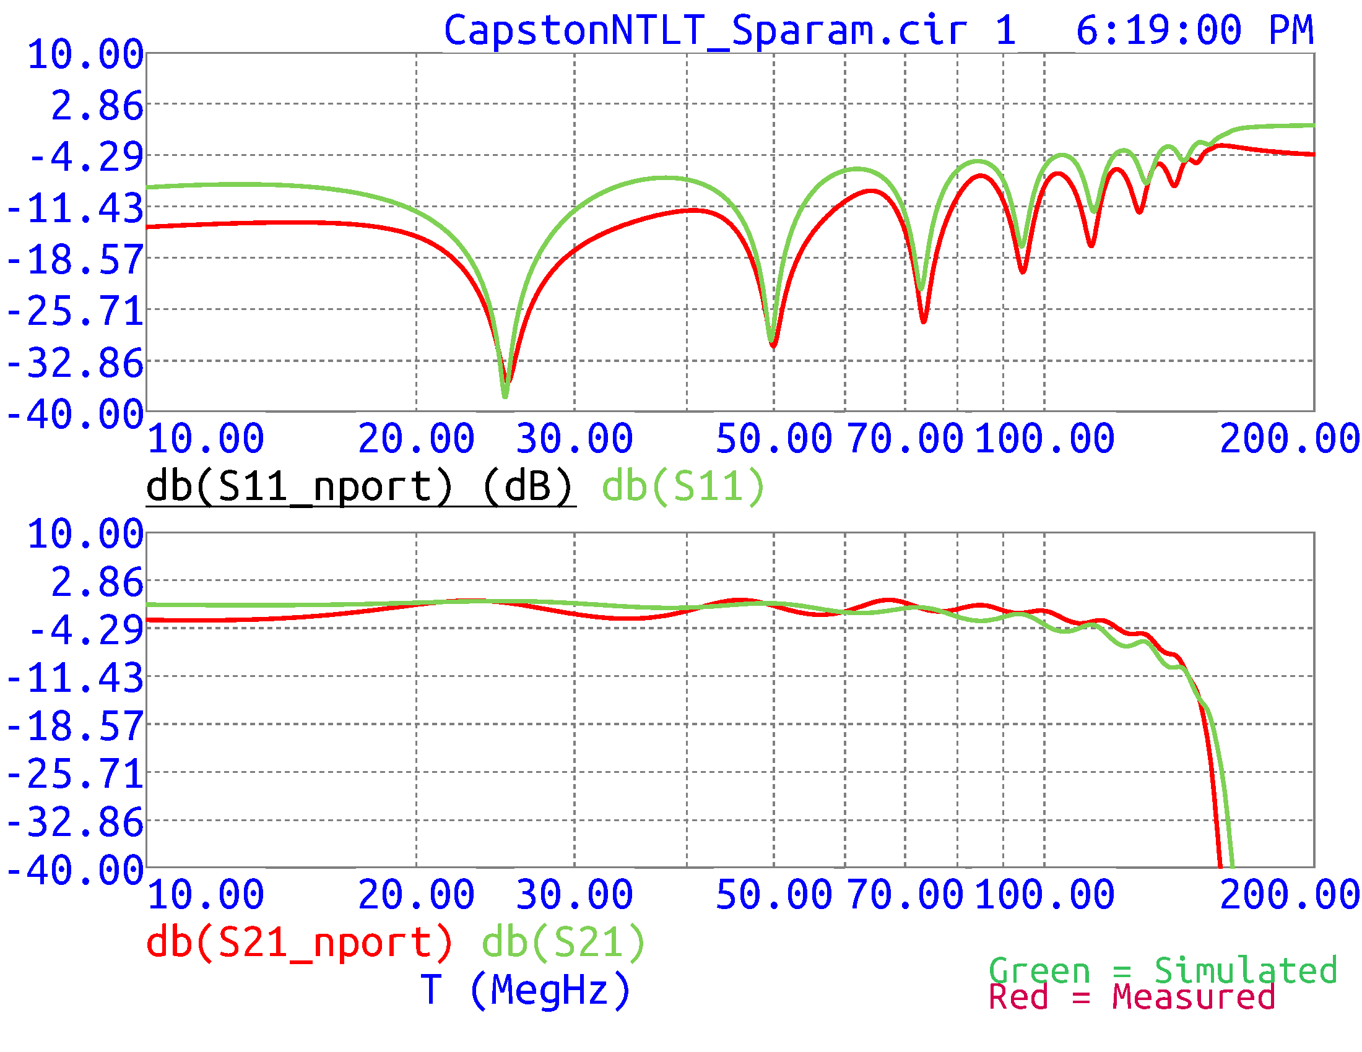
RohdeAndSchwarzWhitePaper/images/Fixed_ZeroBias_Sparam_Sims_Page_2.png
