akier900/Capstone_Rohde-Schwarz_Team13/RohdeAndSchwarzWhitePaper/images/IMG_0136.JPG

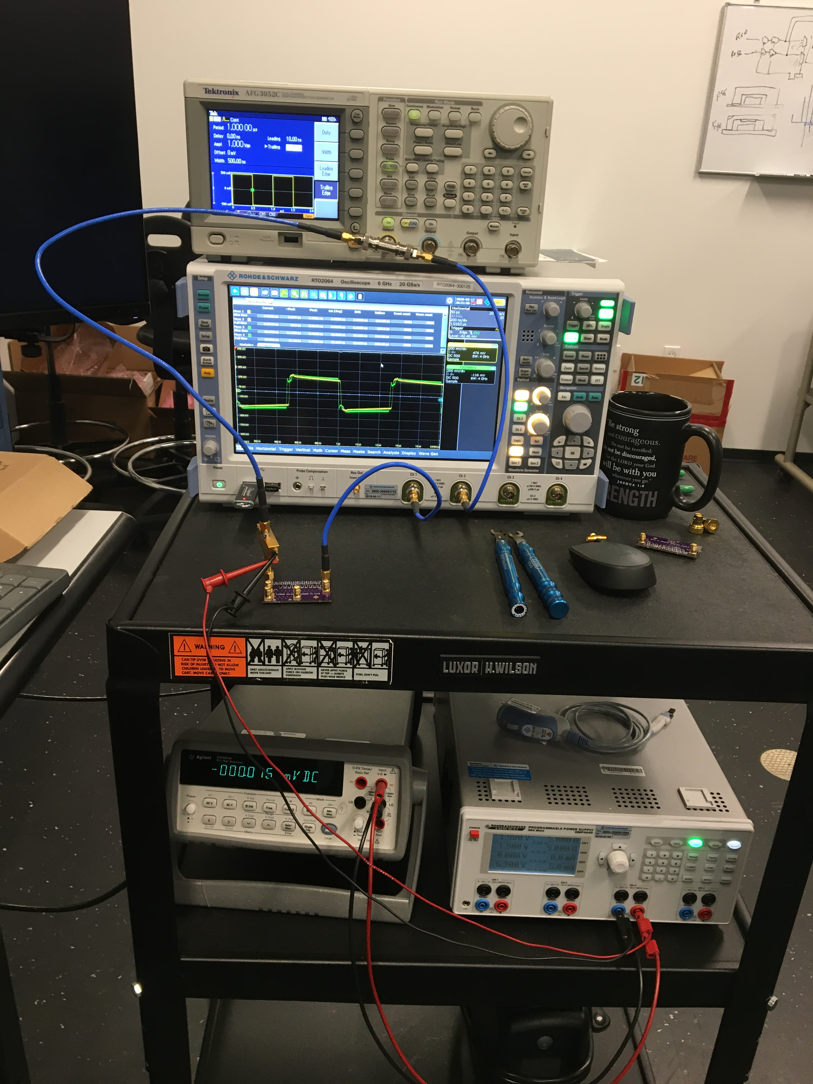
RohdeAndSchwarzWhitePaper/images/IMG_0136.JPG
