akier900/Capstone_Rohde-Schwarz_Team13/RohdeAndSchwarzWhitePaper/images/InitialZeroBias_Sparam_Sims.png

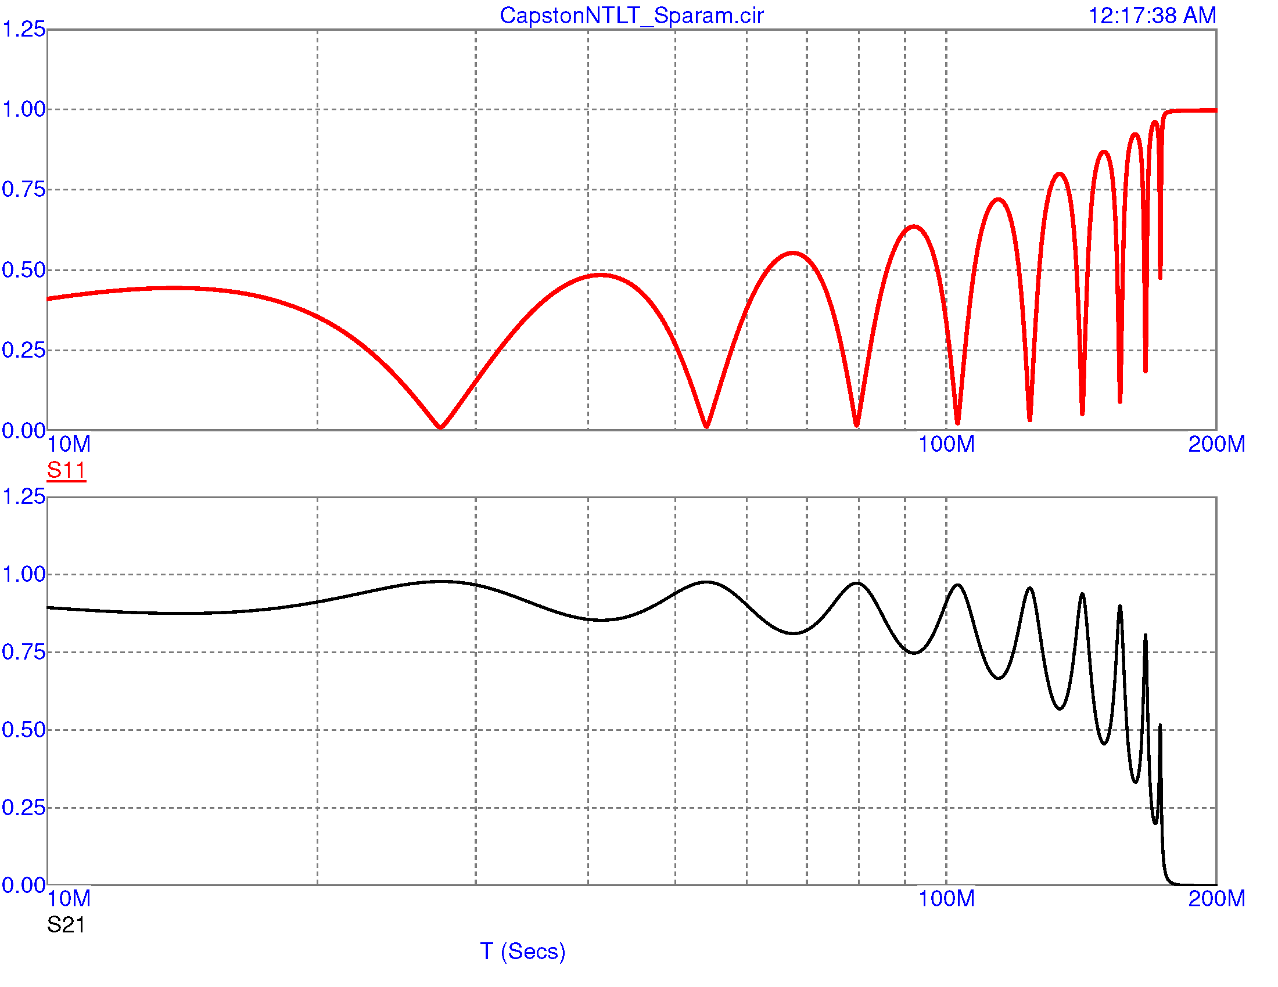
RohdeAndSchwarzWhitePaper/images/InitialZeroBias_Sparam_Sims.png
