akier900/Capstone_Rohde-Schwarz_Team13/RohdeAndSchwarzWhitePaper/images/MicroSchemPicMacro.png

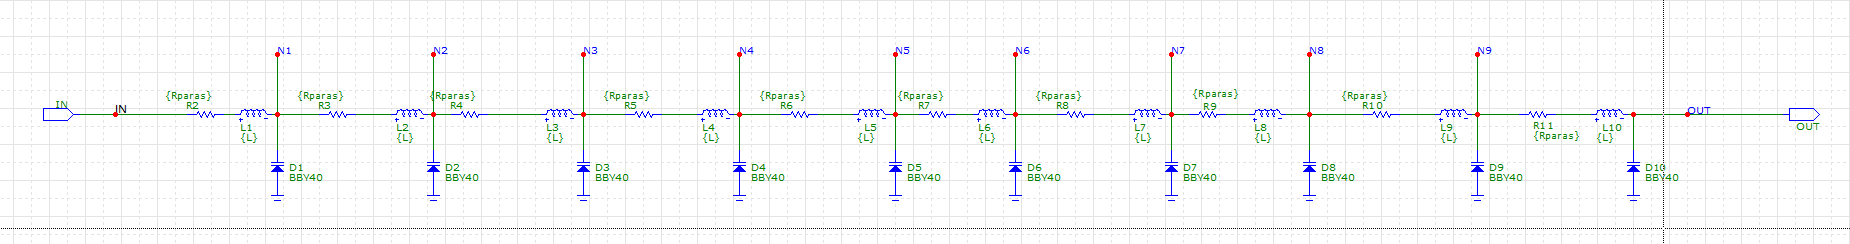
RohdeAndSchwarzWhitePaper/images/MicroSchemPicMacro.png
