akier900/Capstone_Rohde-Schwarz_Team13/RohdeAndSchwarzWhitePaper/images/Optimization_example.png

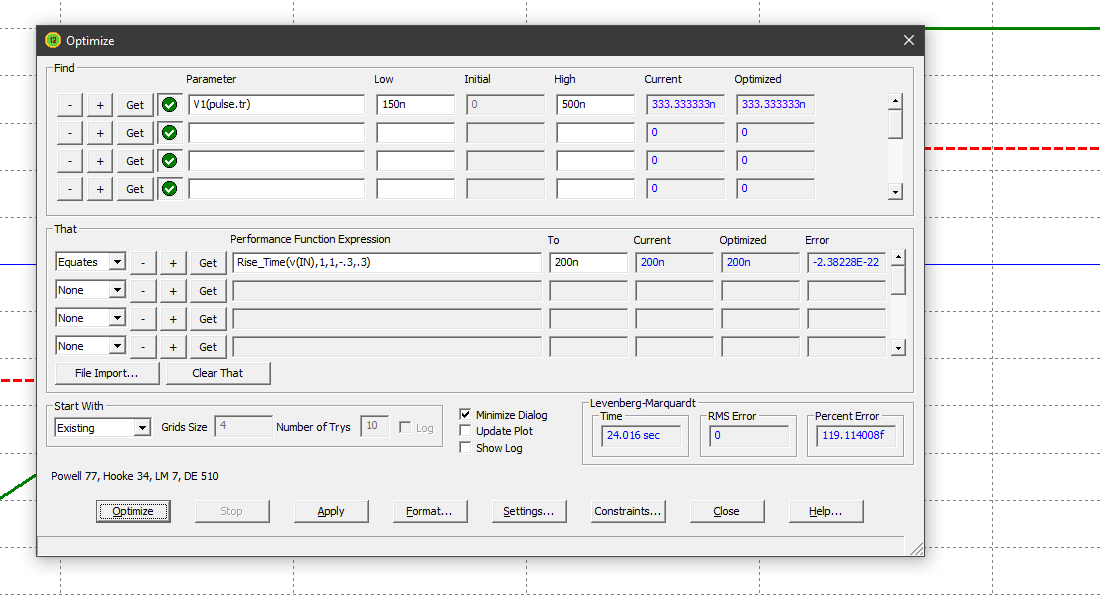
RohdeAndSchwarzWhitePaper/images/Optimization_example.png
