akier900/Capstone_Rohde-Schwarz_Team13/RohdeAndSchwarzWhitePaper/images/Probed_Input_N10_N120.png

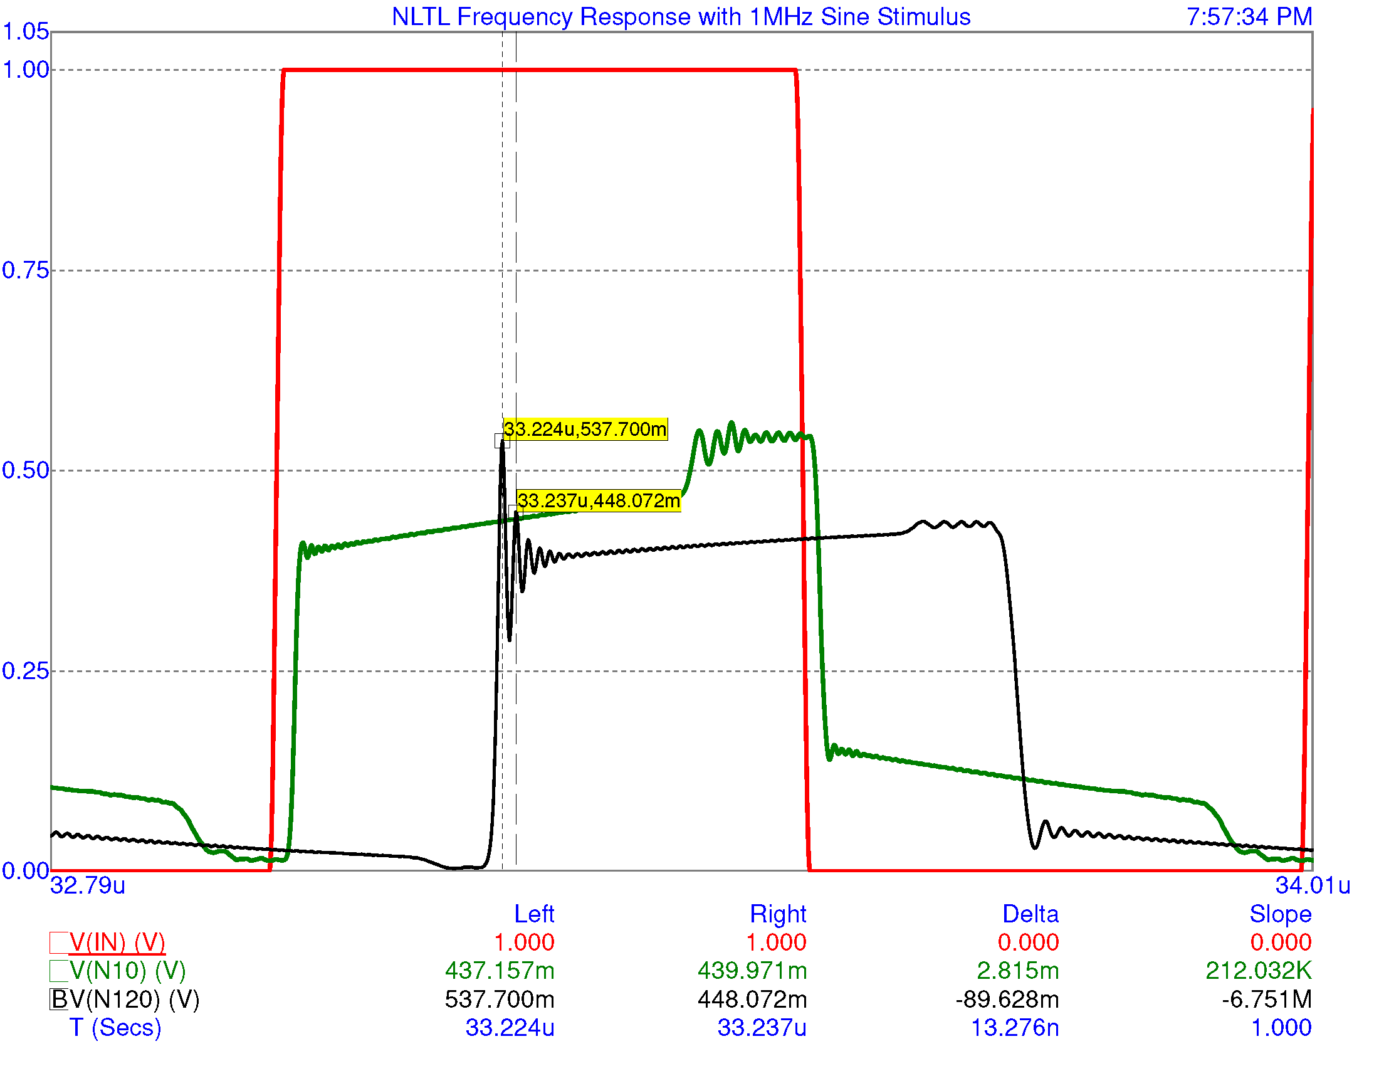
RohdeAndSchwarzWhitePaper/images/Probed_Input_N10_N120.png
