akier900/Capstone_Rohde-Schwarz_Team13/RohdeAndSchwarzWhitePaper/images/Risetime_N10.png

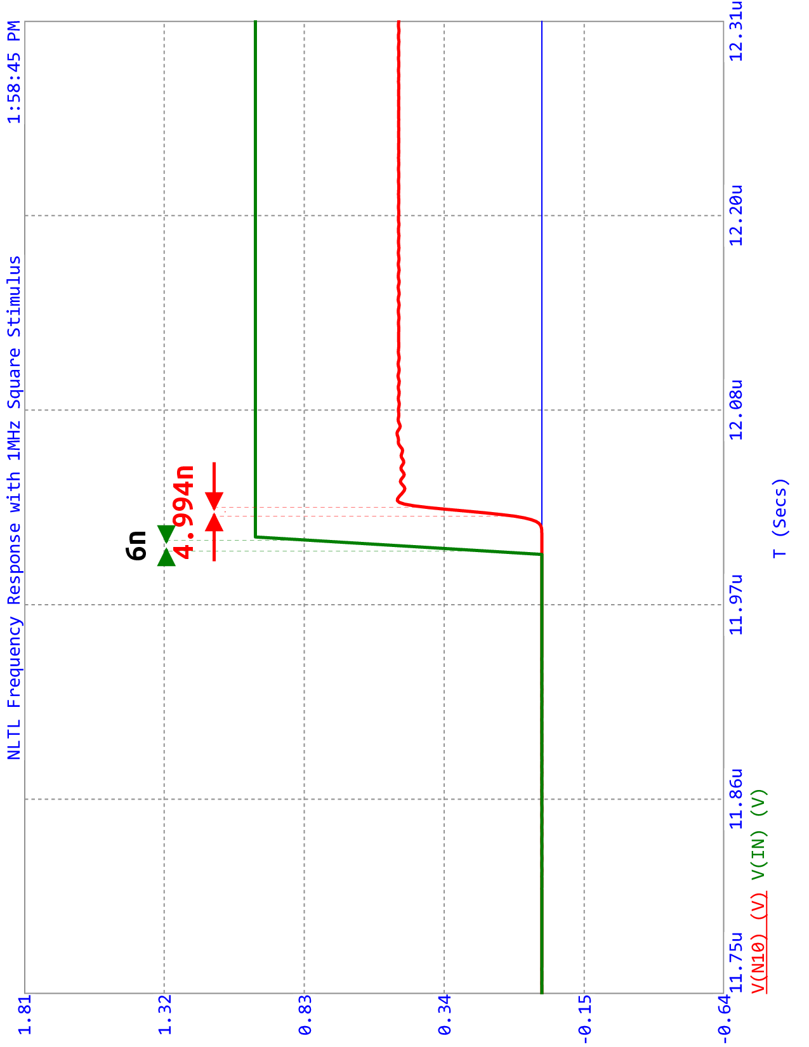
RohdeAndSchwarzWhitePaper/images/Risetime_N10.png
