akier900/Capstone_Rohde-Schwarz_Team13/RohdeAndSchwarzWhitePaper/images/Risetime_RandS.jpeg

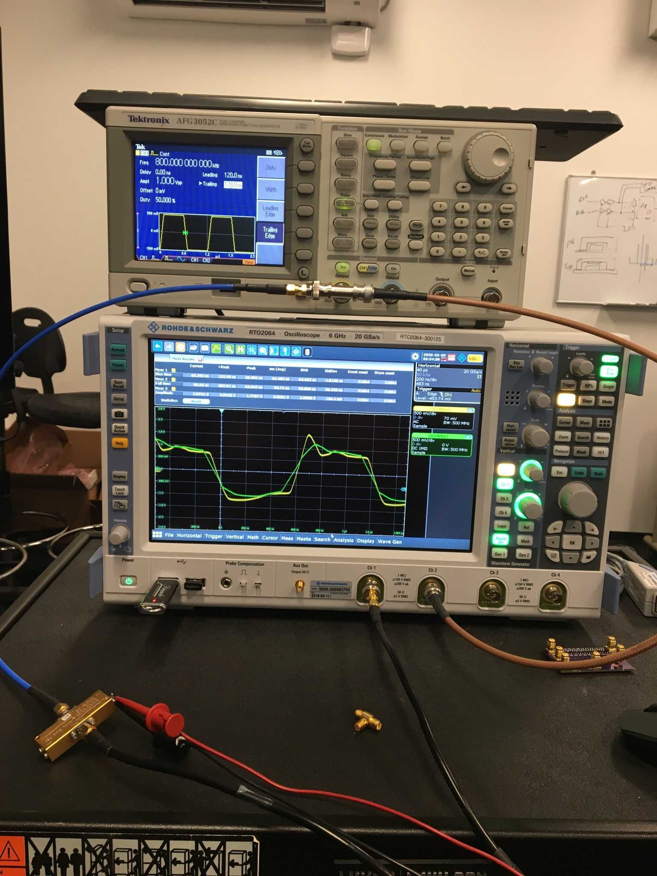
RohdeAndSchwarzWhitePaper/images/Risetime_RandS.jpeg
