akier900/Capstone_Rohde-Schwarz_Team13/RohdeAndSchwarzWhitePaper/images/RisetimeCapture_example.png

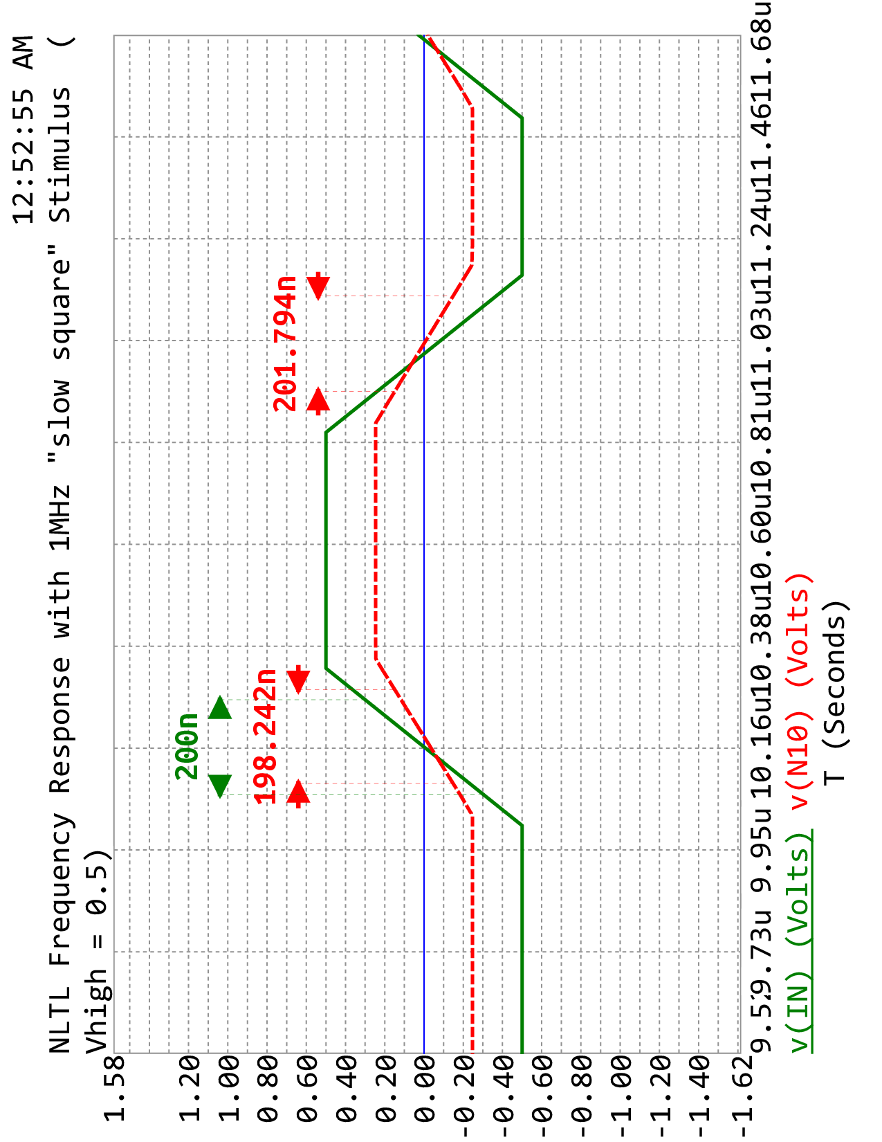
RohdeAndSchwarzWhitePaper/images/RisetimeCapture_example.png
