akier900/Capstone_Rohde-Schwarz_Team13/RohdeAndSchwarzWhitePaper/images/samplingPicture.png

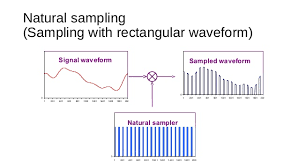
RohdeAndSchwarzWhitePaper/images/samplingPicture.png
