akier900/Capstone_Rohde-Schwarz_Team13/RohdeAndSchwarzWhitePaper/images/Screenshot_2020-05-17_23_054003.png

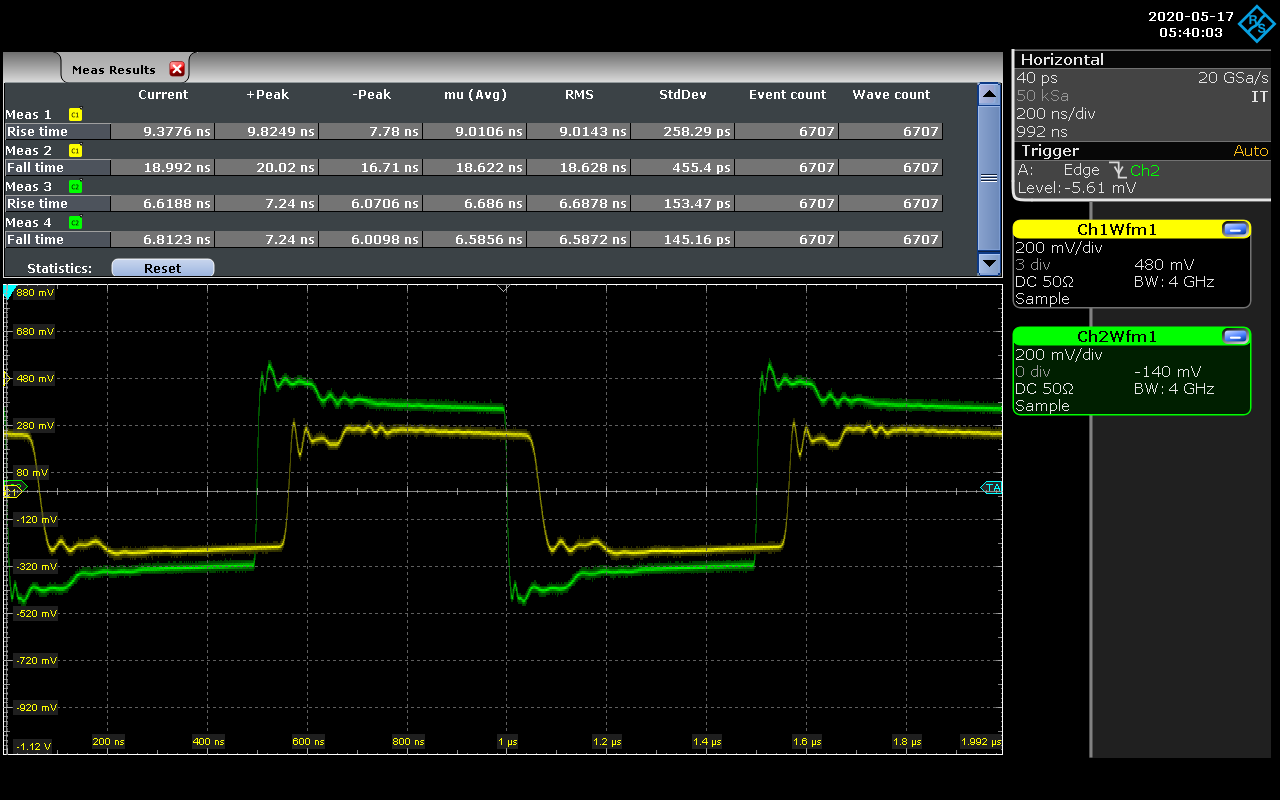
RohdeAndSchwarzWhitePaper/images/Screenshot_2020-05-17_23_054003.png
