akier900/Capstone_Rohde-Schwarz_Team13/RohdeAndSchwarzWhitePaper/images/SpectrumHanning.png

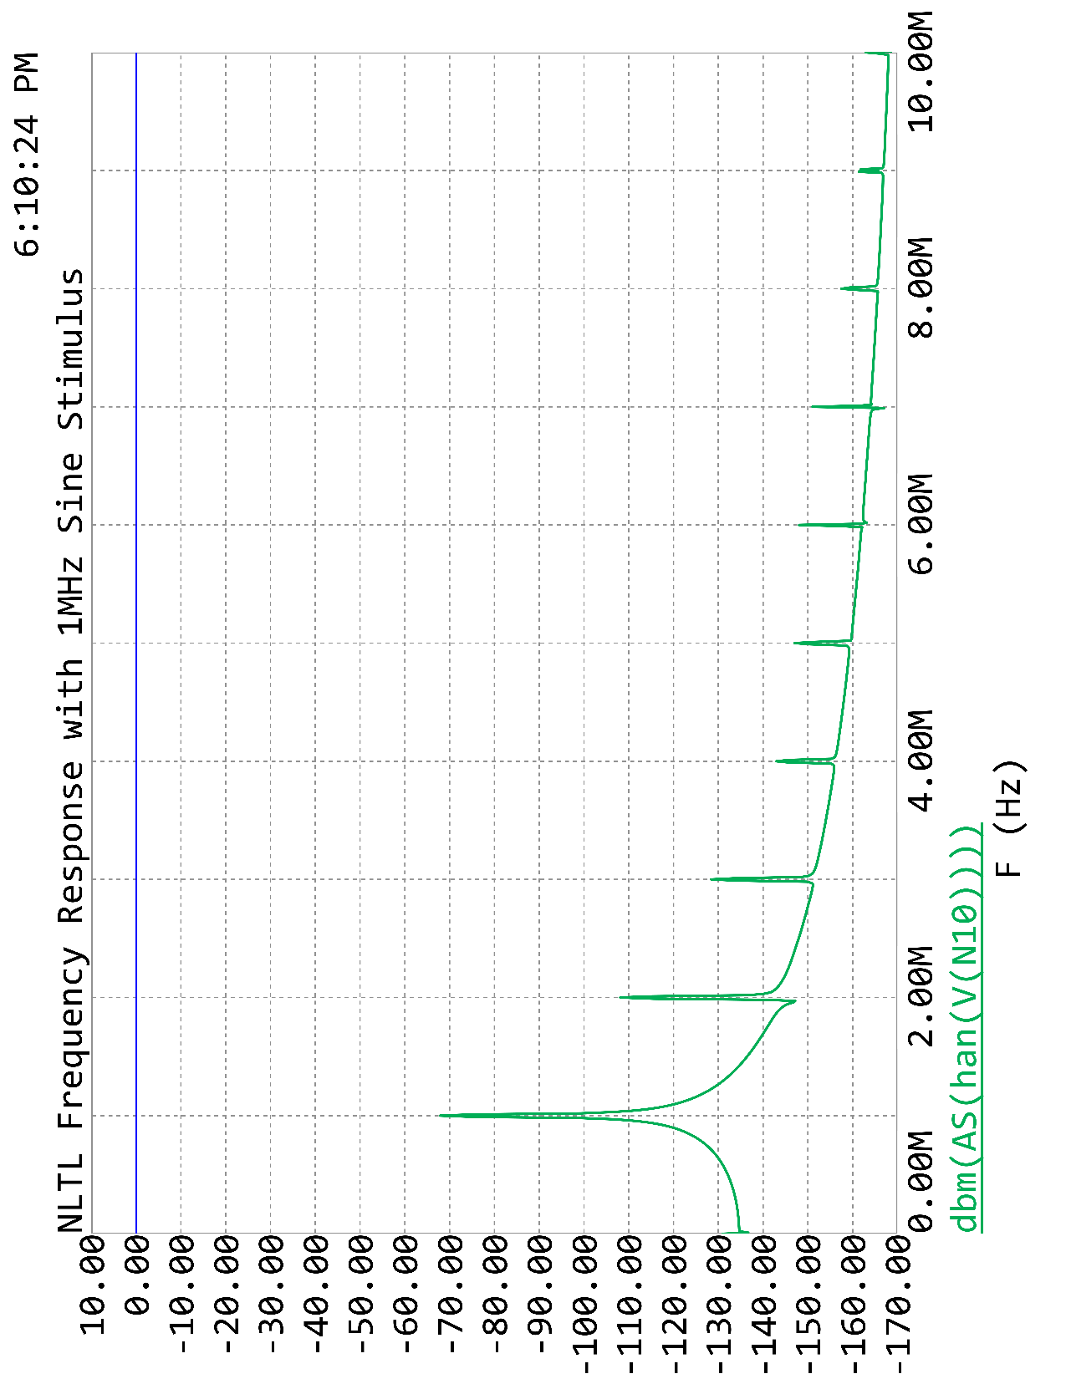
RohdeAndSchwarzWhitePaper/images/SpectrumHanning.png
