akier900/Capstone_Rohde-Schwarz_Team13/RohdeAndSchwarzWhitePaper/PowerpointImages/VaractorTline144Mhz_Page_04.png

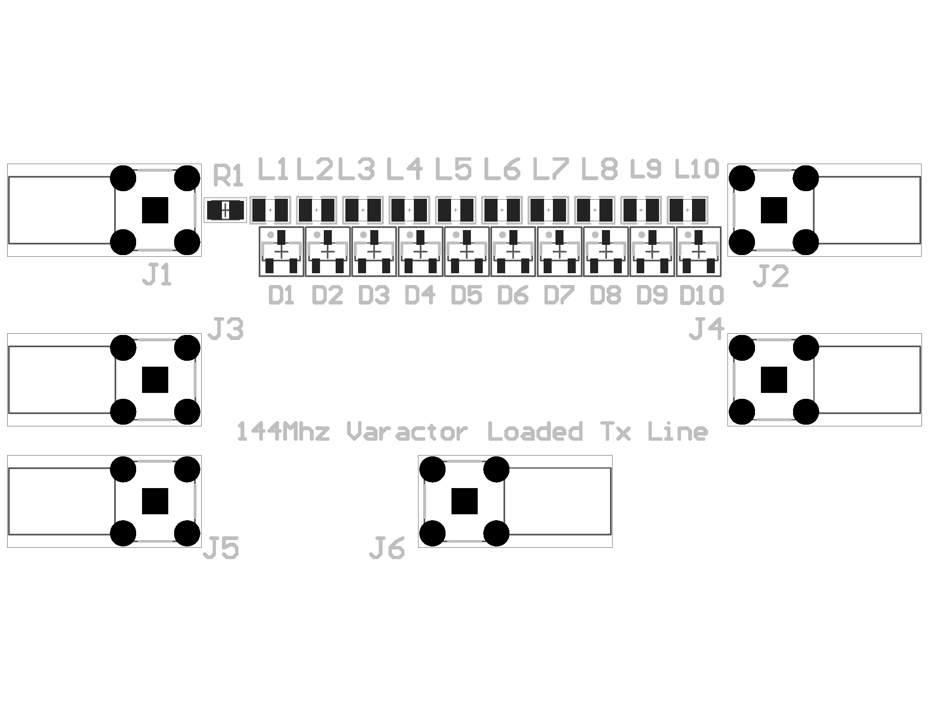
RohdeAndSchwarzWhitePaper/PowerpointImages/VaractorTline144Mhz_Page_04.png
