akier900/Capstone_Rohde-Schwarz_Team13/RohdeAndSchwarzWhitePaper/PowerpointImages/VaractorTline144Mhz_Page_05.png

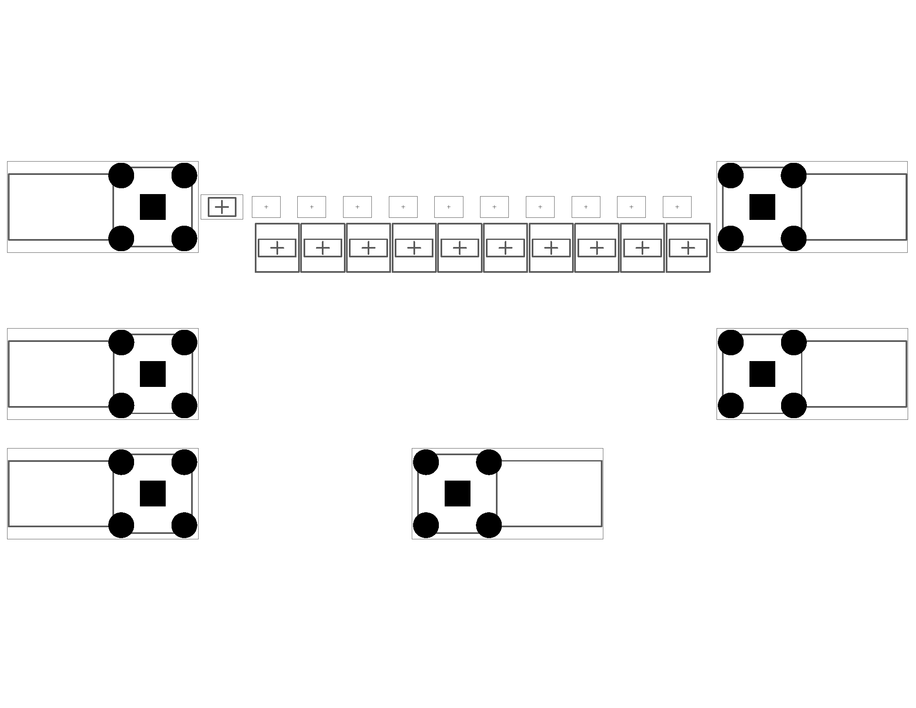
RohdeAndSchwarzWhitePaper/PowerpointImages/VaractorTline144Mhz_Page_05.png
