akier900/Capstone_Rohde-Schwarz_Team13/RohdeAndSchwarzWhitePaper/images/CapstoneBOM.pdf

Name | Description | Manufacturer | Manufacturer Part Number | Column3 | Supplier 1 | Supplier Part Number | Supplier Unit Price | Quantity | Supplier Subtotal
PCB FAB | Board FAB costs | OSHPARK | B1 | $ | 5.32 | 1 $ | 5.32
Diode BBY40 | SOT23 Silicon Planar Variable Capacitance Diode | NXP | BBY40,235 | Digi-Key, [NoParam], Mouser | 568-13615-1-ND, [NoParam] | $ | 0.42 | 10 $ | 4.20
731000114 | SMA Right-Angle PCB Jack Receptacle, Brass Body, Gold Plated, 50 Ohm, 5-Pin Molex | 73100-0114 | Digi-Key | WM5525-ND | $ | 4.27 | 5 $ | 21.35
0805HP-56NXJRC | 0805HP-56NXJRC Coilcraft Variable Inductor | Coilcraft | 0805HP-56NX_R_ | [NoParam], Mouser | [NoParam], 994-0805HP-56NXJRB | $ | 0.82 | 10 $ | 8.20
ERJ-6GEY0R00V | Chip Resistor, 0 Ohm, +/- 1%, 0.125 W, -55 to 155 degC, 0805 (2012 Metric), Ro Panasonic | ERJ-6GEY0R00V | Allied Electronics | 70266106 $ | 0.02 | 1 $ | 0.02
TOTAL COST PER BOARD | $ | 39.09
TOTAL COST | $ | 117.26

Board Quantity:
3
