akier900/Capstone_Rohde-Schwarz_Team13/RohdeAndSchwarzWhitePaper/images/CapstoneBOM.png

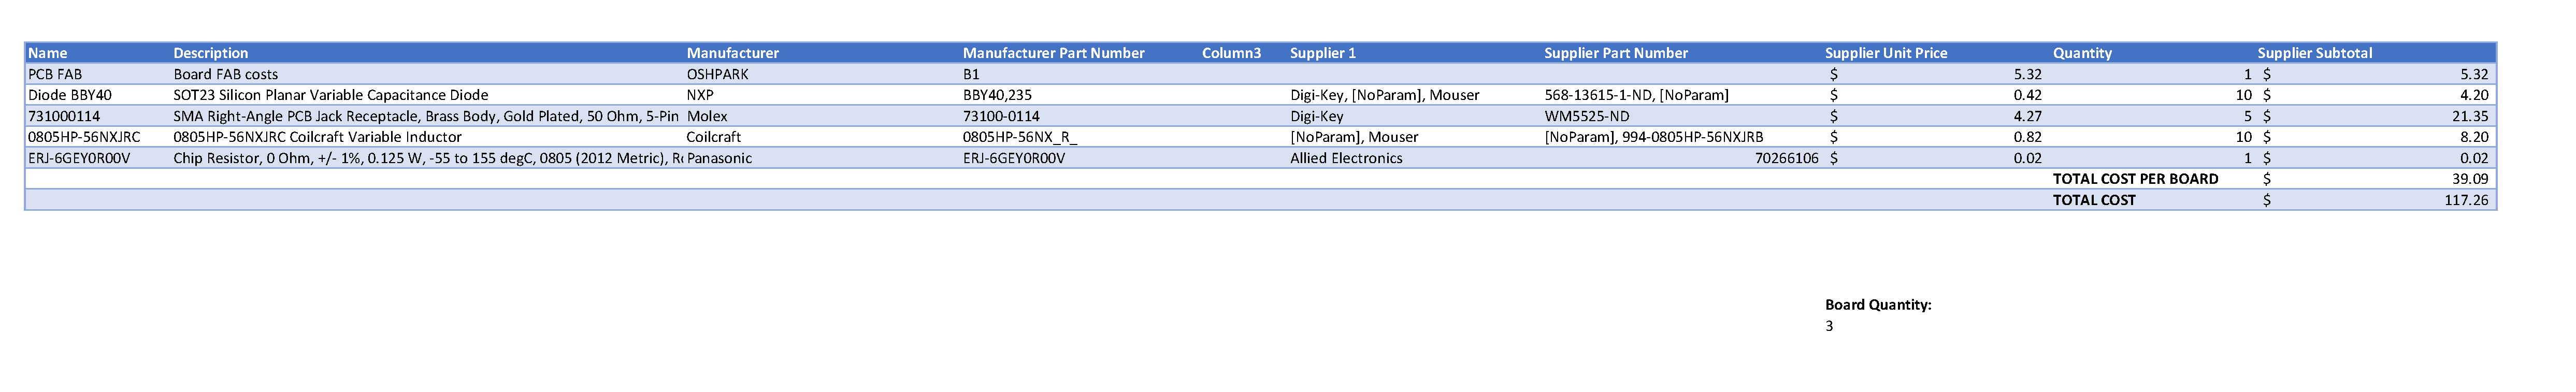
RohdeAndSchwarzWhitePaper/images/CapstoneBOM.png
