akier900/Capstone_Rohde-Schwarz_Team13/MeetingFiles/FilesForMeeting_5_6_2020/Measurement/Construction photos/UnpopulatedBoard.jpg

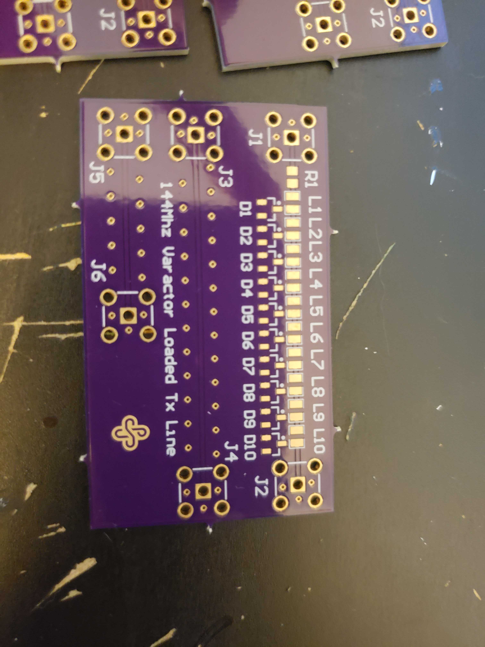
MeetingFiles/FilesForMeeting_5_6_2020/Measurement/Construction photos/UnpopulatedBoard.jpg
