akier900/Capstone_Rohde-Schwarz_Team13/RohdeAndSchwarzWhitePaper/images/TrapInputSetup.JPG

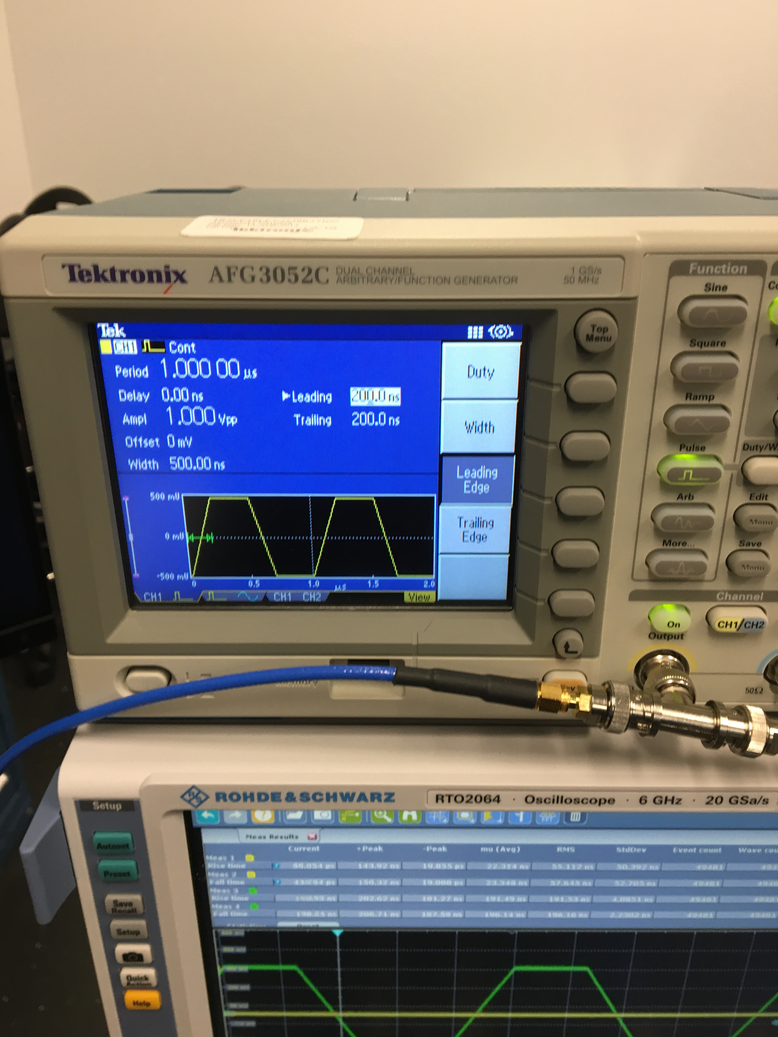
RohdeAndSchwarzWhitePaper/images/TrapInputSetup.JPG
