akier900/Capstone_Rohde-Schwarz_Team13/Measurements/Capacitance/bby40Measurement.xlsx

Vr | Capacitance | BBY40 Capacitance Vs. Reverse Voltage Measurements
0 | 6.738e-11
0.572 | 5.374e-11
1.131 | 4.41e-11
1.595 | 3.901e-11
2.05 | 3.51e-11
2.59 | 3.156e-11
3.04 | 2.924e-11
3.58 | 2.674e-11
4.08 | 2.473e-11
4.59 | 2.289e-11
5.01 | 2.156e-11
