akier900/Capstone_Rohde-Schwarz_Team13/MeetingFiles/FilesForMeeting_5_6_2020/Measurement/CV- curves/bby40Measurement.xlsx

Vr | Capacitance | BBY40 Capacitance Vs. Reverse Voltage Measurements
0 | 67.38
0.572 | 53.74
1.131 | 44.1
1.595 | 39.01
2.05 | 35.1
2.59 | 31.56
3.04 | 29.24
3.58 | 26.74
4.08 | 24.73
4.59 | 22.89
5.01 | 21.56
