akier900/Capstone_Rohde-Schwarz_Team13/MeetingFiles/FilesForMeeting_5_6_2020/Measurement/CV- curves/SMV1249_CapVsReverseVoltage.xlsx

Vr | Capacitance | SMV1249 Capacitance vs Reverse Voltage Measurements
0 | 32.26
0.508 | 26.26
1.01 | 17.57
1.508 | 11.27
2.03 | 6.71
2.5 | 4.03
3 | 2.47
3.52 | 1.66
4.04 | 1.38
4.5 | 1.19
5.03 | 0.95
