akier900/Capstone_Rohde-Schwarz_Team13/Measurements/Images/SparamPlot_NoDCBias.png

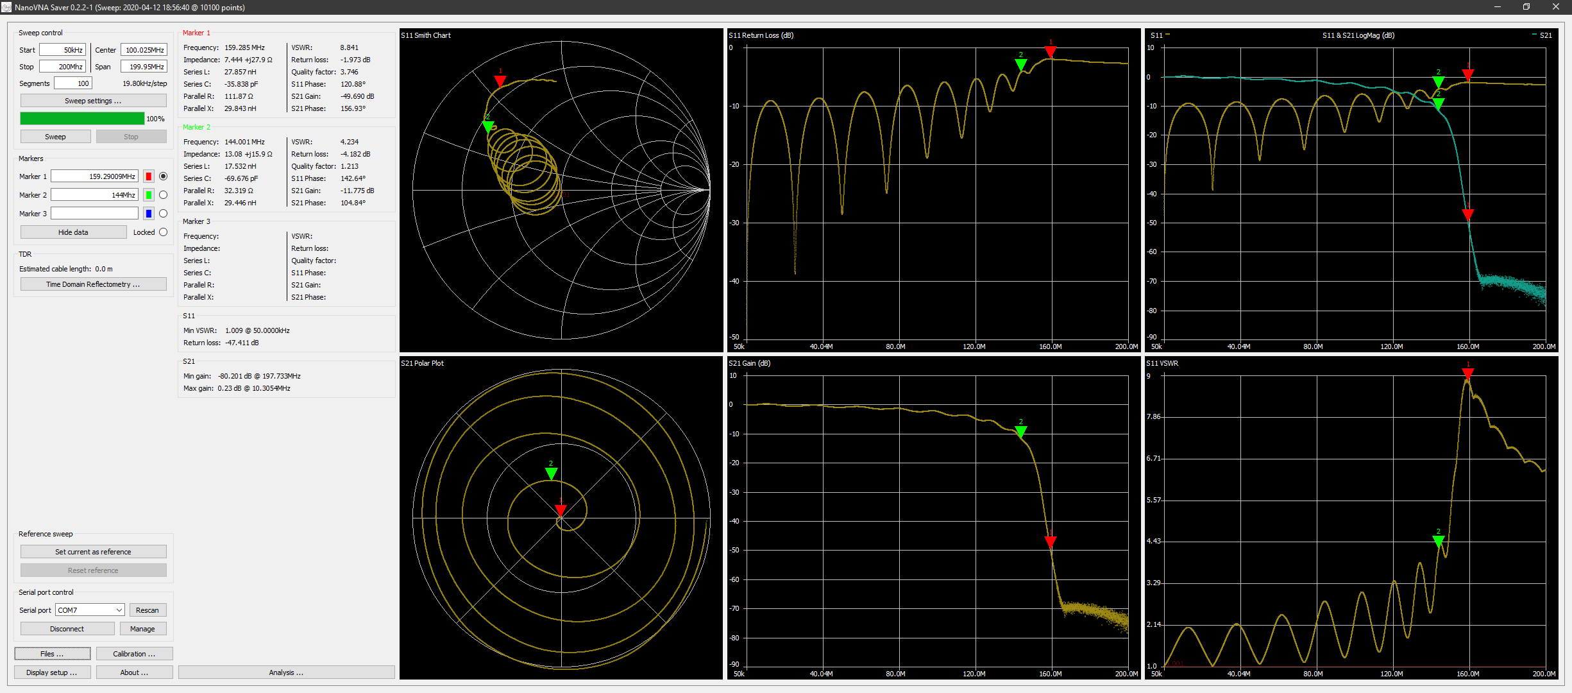
Measurements/Images/SparamPlot_NoDCBias.png
