akier900/Capstone_Rohde-Schwarz_Team13/Measurements/Oscope/RiseTimeVsBias_Rev2.0/SDS00005.png

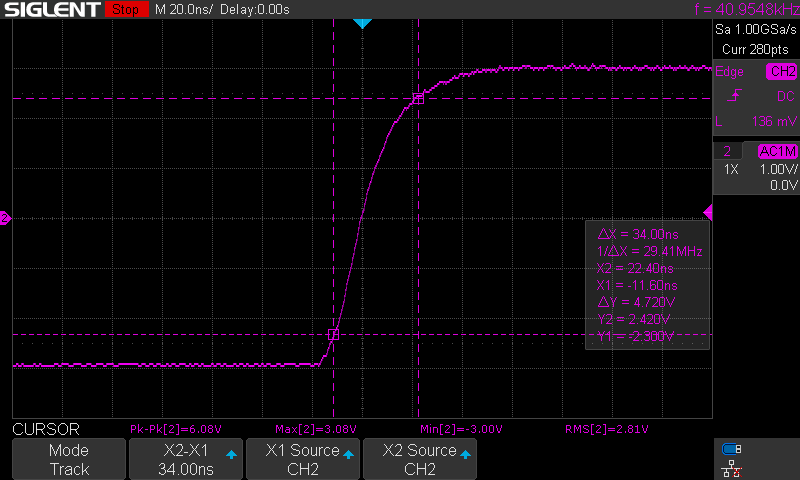
Measurements/Oscope/RiseTimeVsBias_Rev2.0/SDS00005.png
