akier900/Capstone_Rohde-Schwarz_Team13/RohdeAndSchwarzWhitePaper/images/InkscapeGraphics/w2aew_testfixture_schem.png

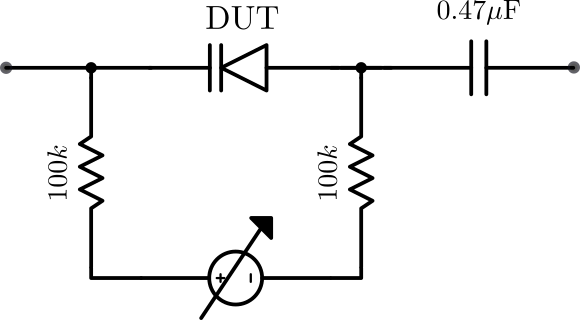
RohdeAndSchwarzWhitePaper/images/InkscapeGraphics/w2aew_testfixture_schem.png
