akier900/Capstone_Rohde-Schwarz_Team13/RohdeAndSchwarzWhitePaper/images/MeasuredACResponseB2.bmp

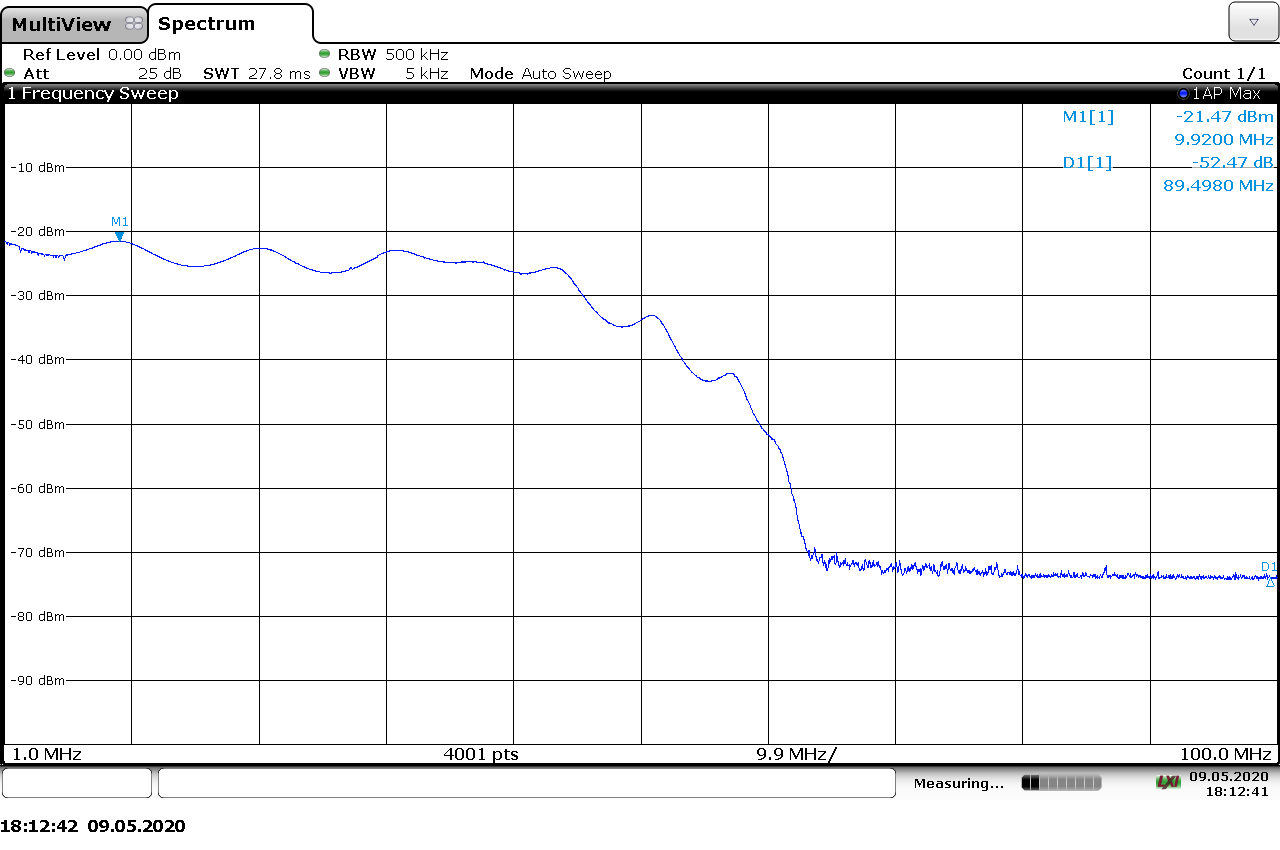
RohdeAndSchwarzWhitePaper/images/MeasuredACResponseB2.bmp
