akier900/Capstone_Rohde-Schwarz_Team13/AltiumFiles/Varactor_TxCap_new/VaractorTline144Mhz.pdf

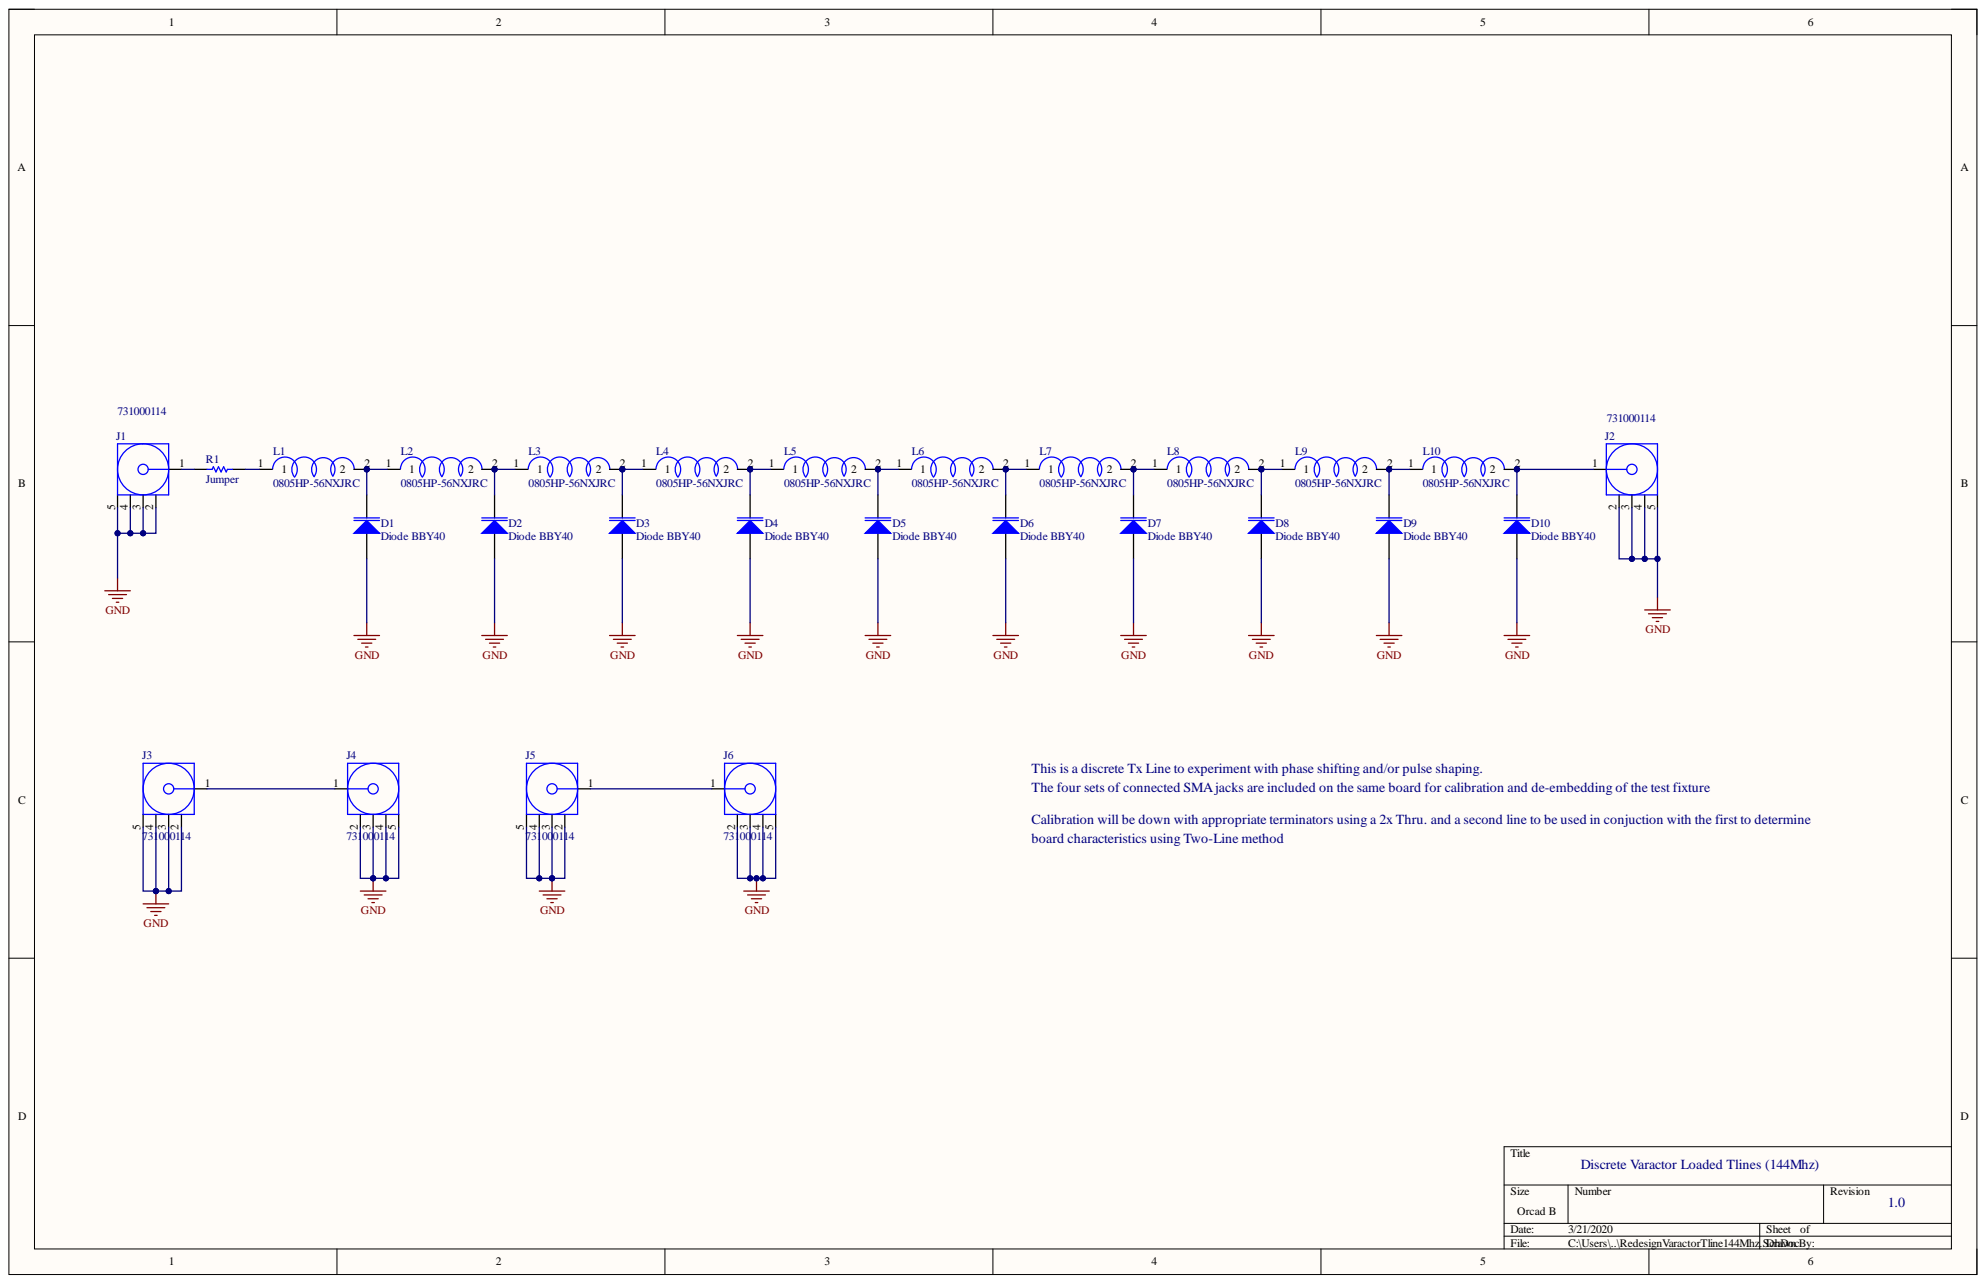
[picture p101: page 1]

This is a discrete Tx Line to experiment with phase shifting and/or pulse shaping.
The four sets of connected SMA jacks are included on the same board for calibration and de-embedding of the test fixture

Calibration will be down with appropriate terminators using a 2x Thru. and a second line to be used in conjuction with the first to determine
board characteristics using Two-Line method

Discrete Varactor Loaded Tlines (144Mhz)

Size Orcad B | Number | Revision 1.0

Date: 3/21/2020 | Sheet of
File: C:\Users\..\RedesignVaractorTline144Mhz.SDcrhaDwoncBy:

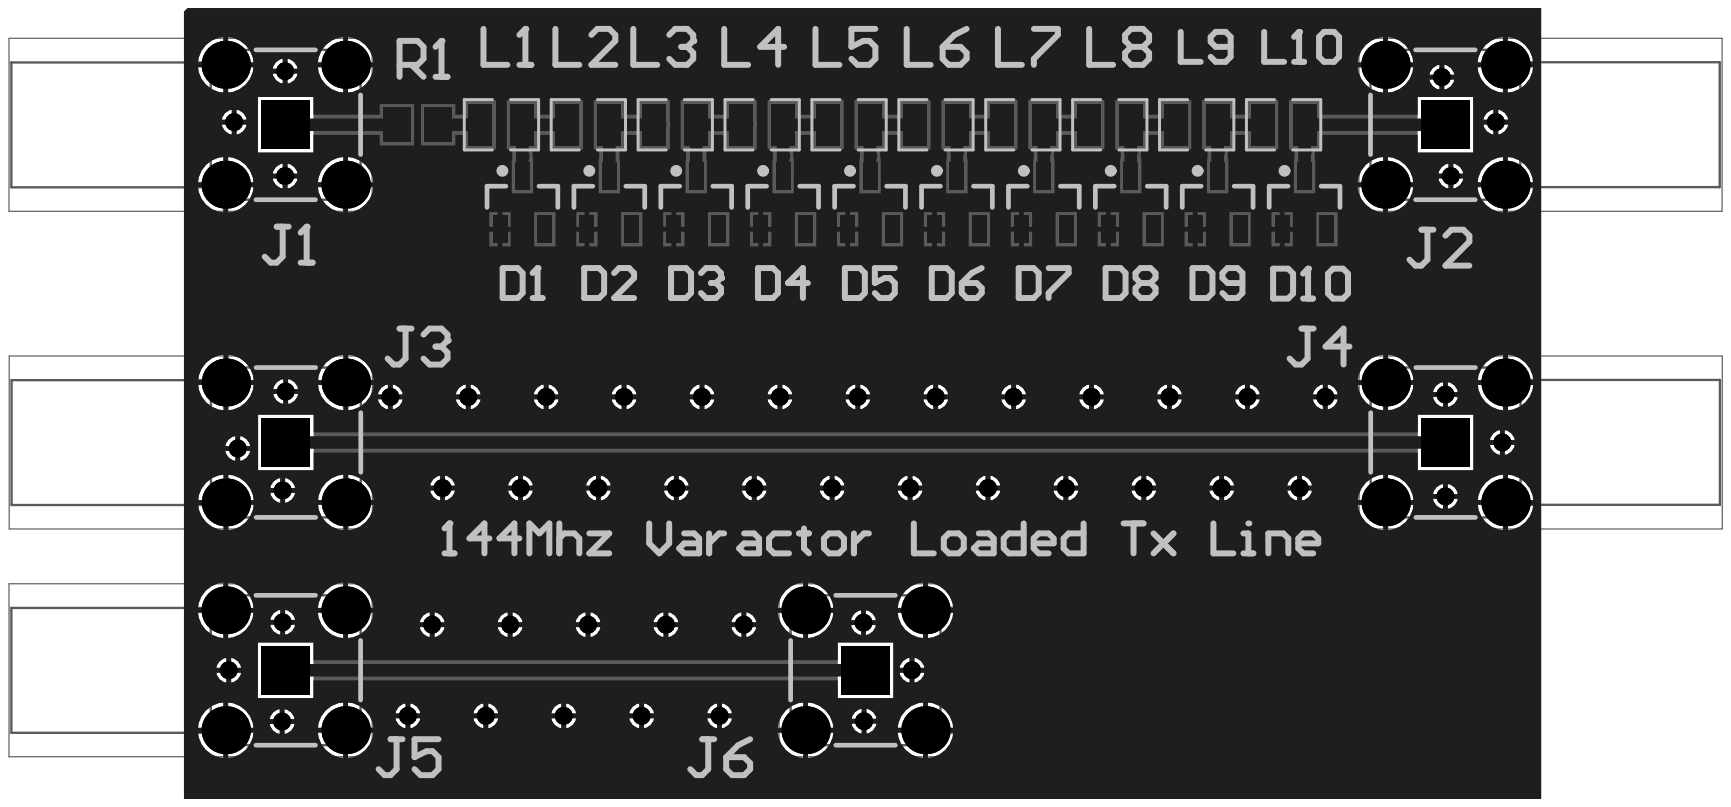
[picture p102: page 2]

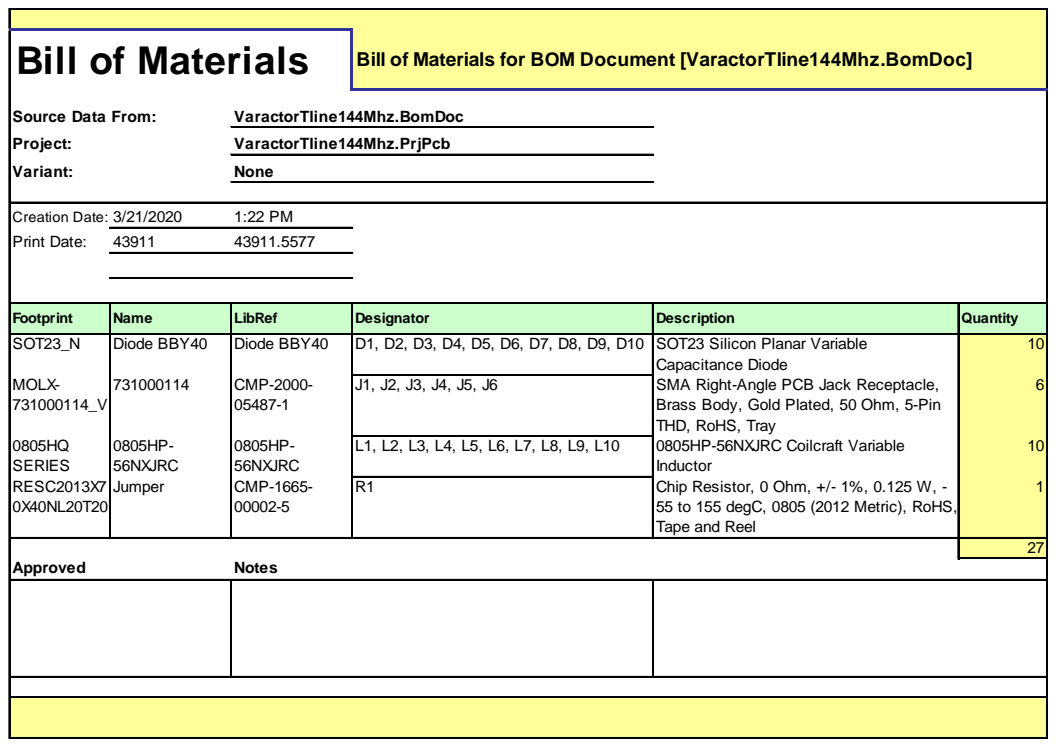
[picture p103: page 3]

Footprint | Name | LibRef | Designator | Description | Quantity
SOT23_N MOLX-731000114_V 0805HQ SERIES RESC2013X7 0X40NL20T20 | Diode BBY40 731000114 0805HP-56NXJRC Jumper | Diode BBY40 CMP-2000-05487-1 0805HP-56NXJRC CMP-1665-00002-5 | D1, D2, D3, D4, D5, D6, D7, D8, D9, D10 | SOT23 Silicon Planar Variable Capacitance Diode SMA Right-Angle PCB Jack Receptacle, Brass Body, Gold Plated, 50 Ohm, 5-Pin THD, RoHS, Tray 0805HP-56NXJRC Coilcraft Variable Inductor Chip Resistor, 0 Ohm, +/- 1%, 0.125 W, -55 to 155 degC, 0805 (2012 Metric), RoHS, Tape and Reel | 10

Approved Notes | | | | | 27

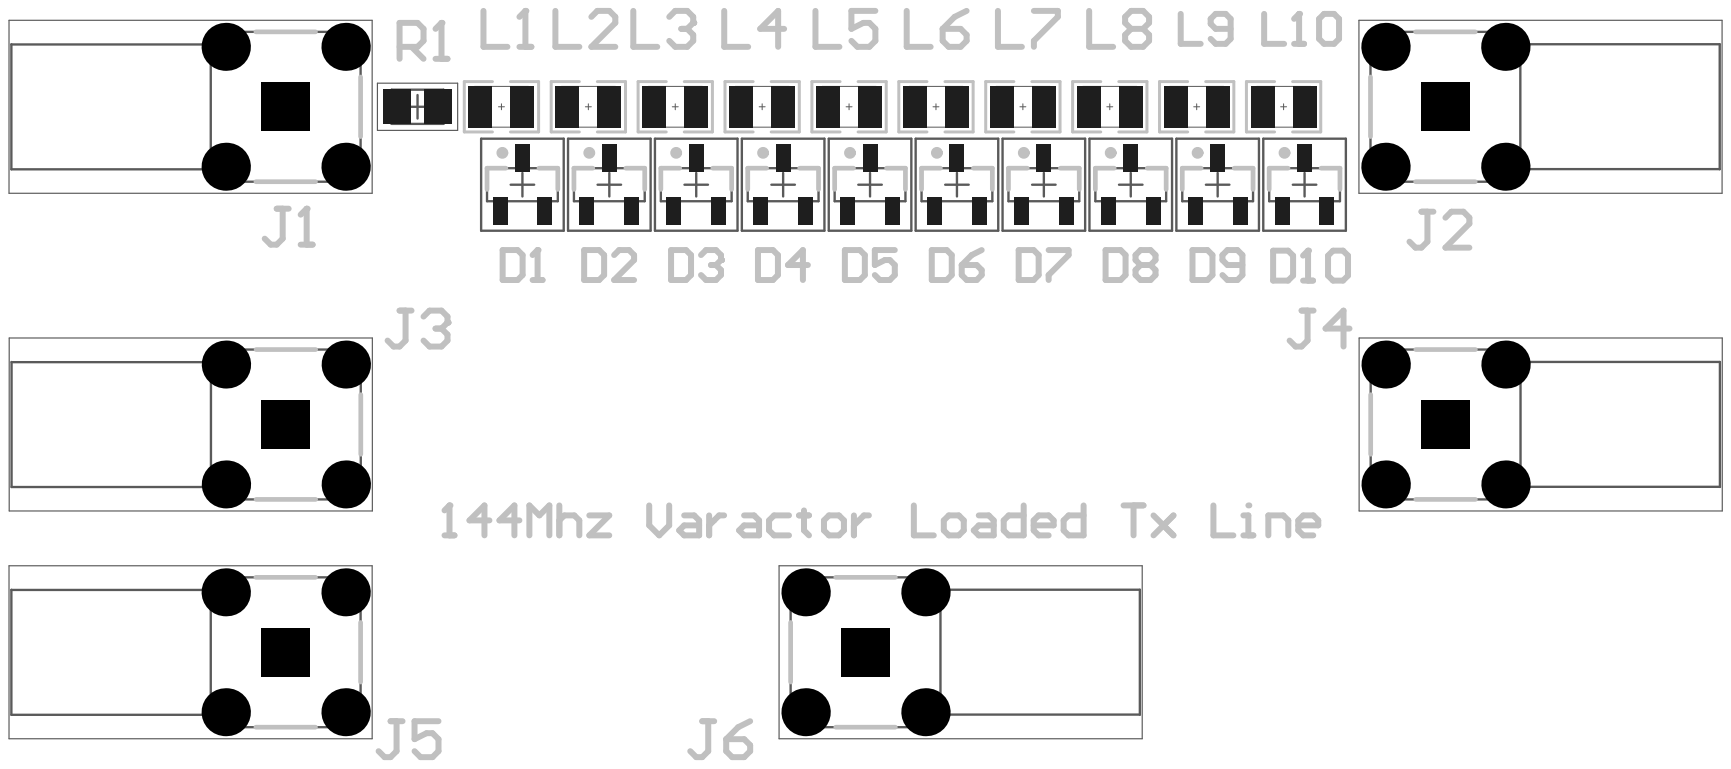
[picture p104: page 4]

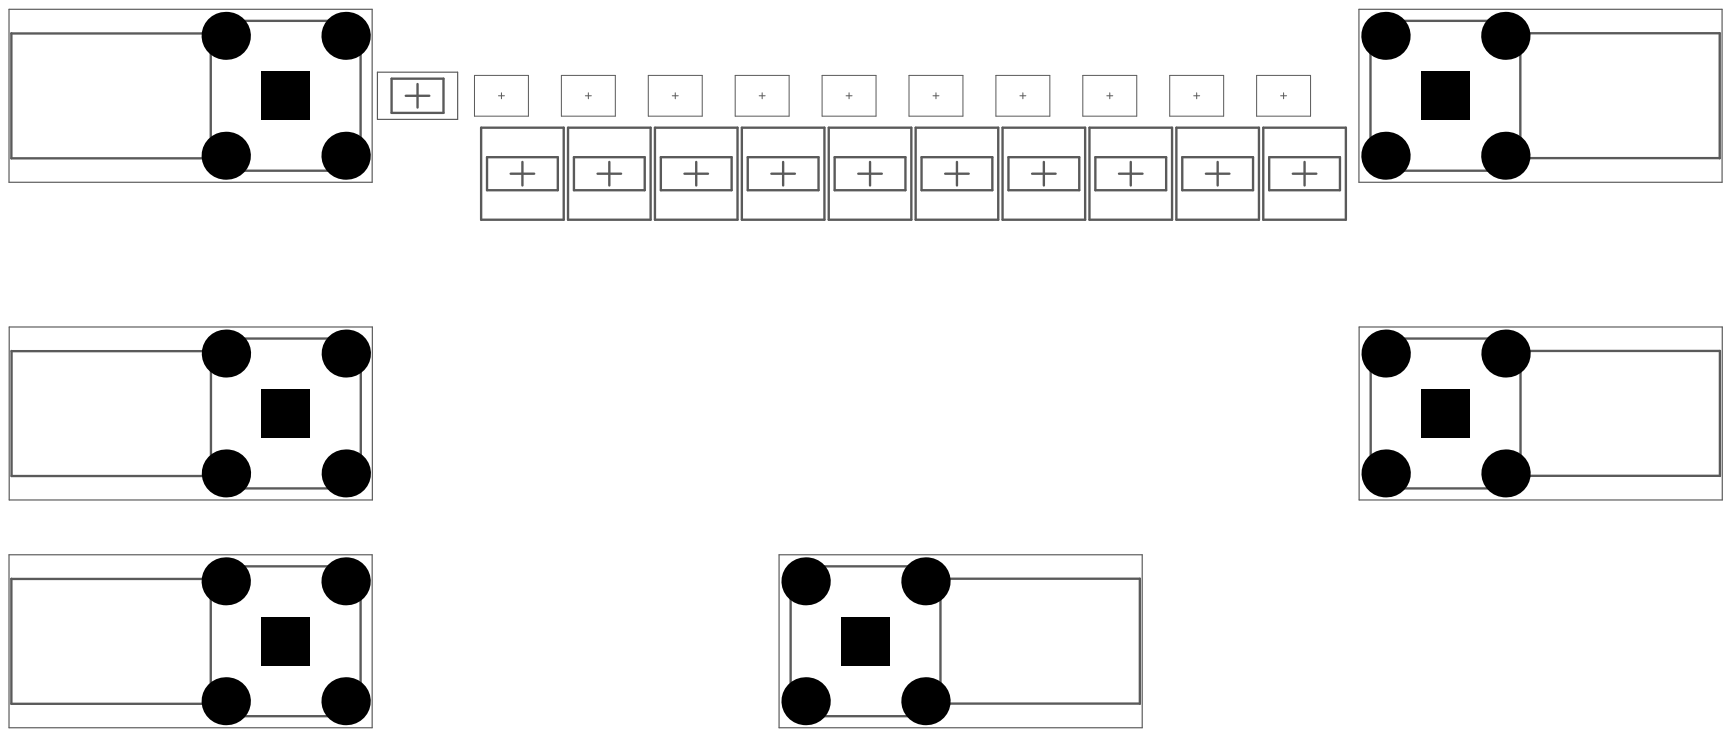
[picture p105: page 5]

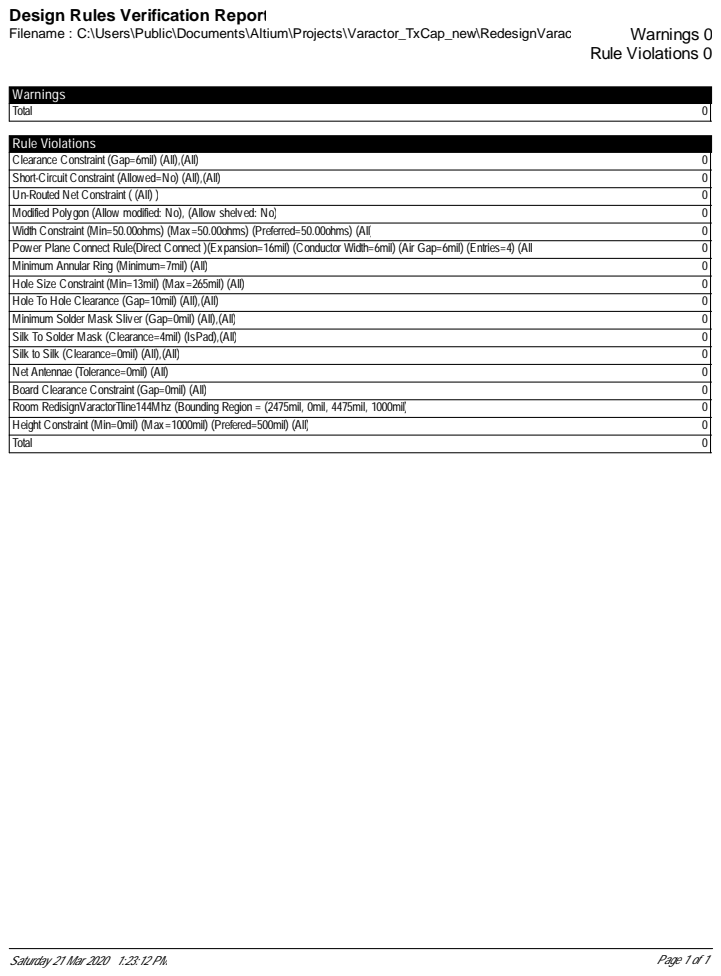
[picture p106: page 7]

Design Rules Verification Report

### Electrical Rules Check Report

Class | Document | Message Successful Compile for VaractorTline144Mhz.PrjPcb
Saturday 21 Mar 2020 1:23:13 PM | Page 1 of 1

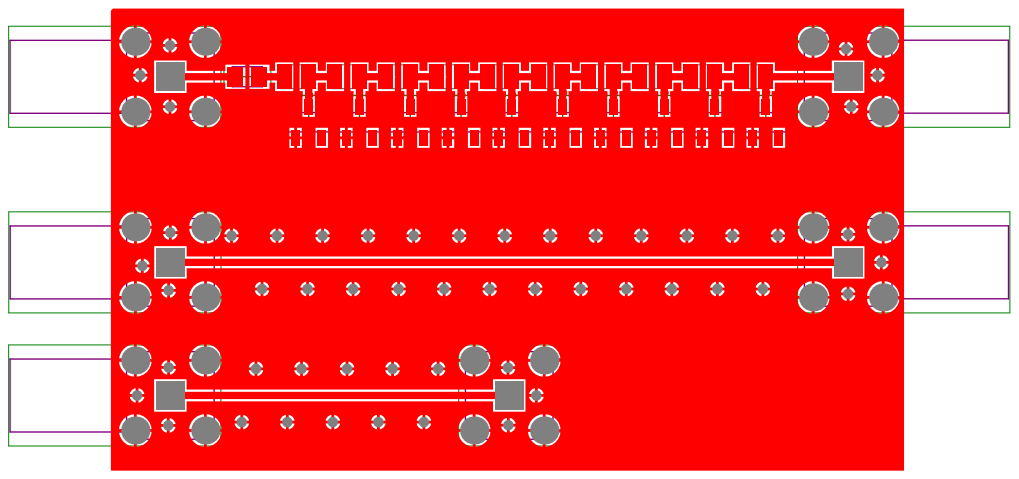
[picture p107: page 9]

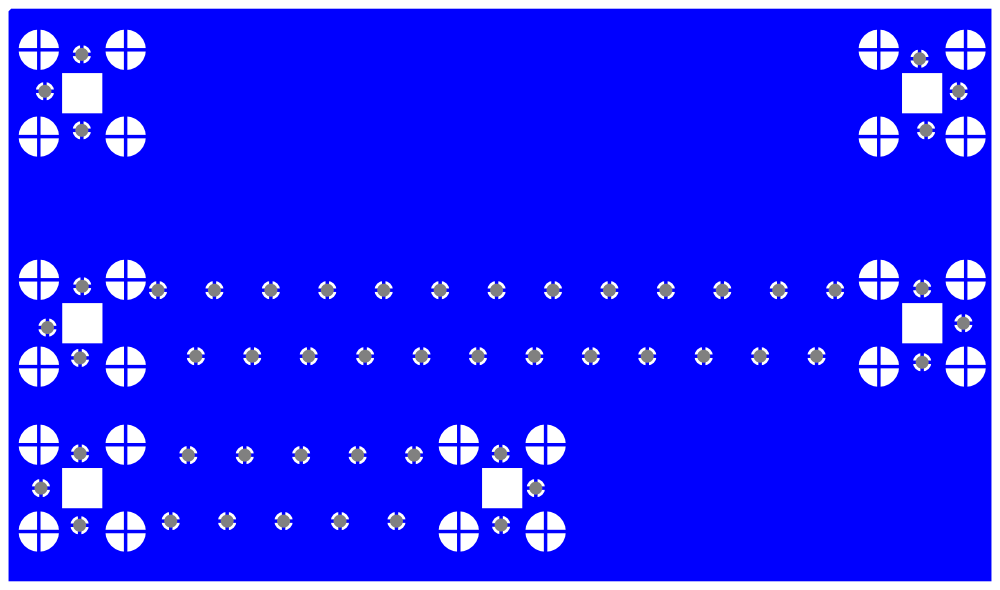
[picture p108: page 10]

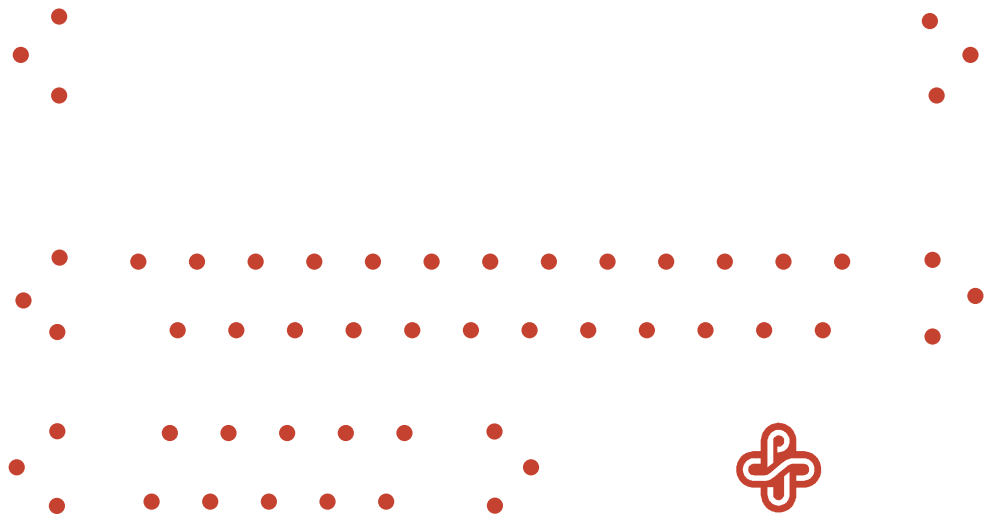
[picture p109: page 13]

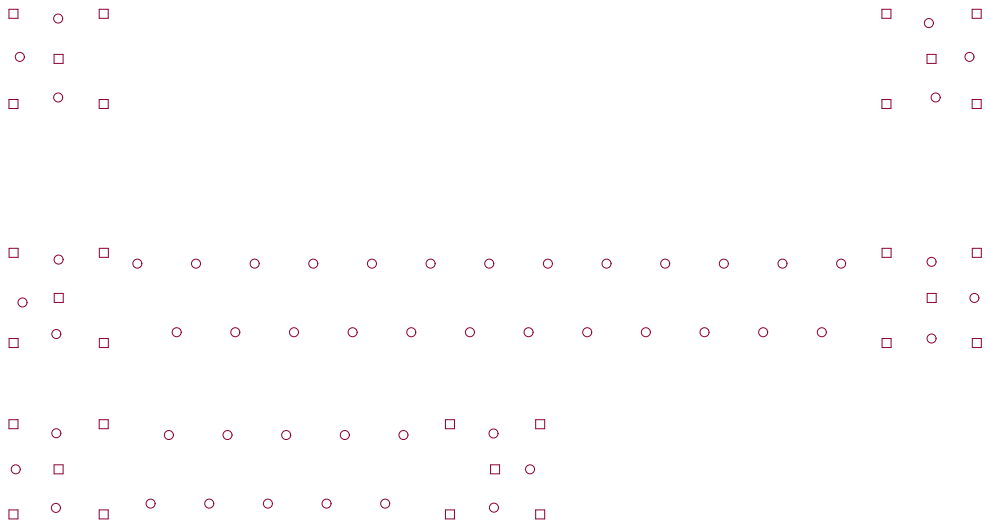
[picture p110: page 21]

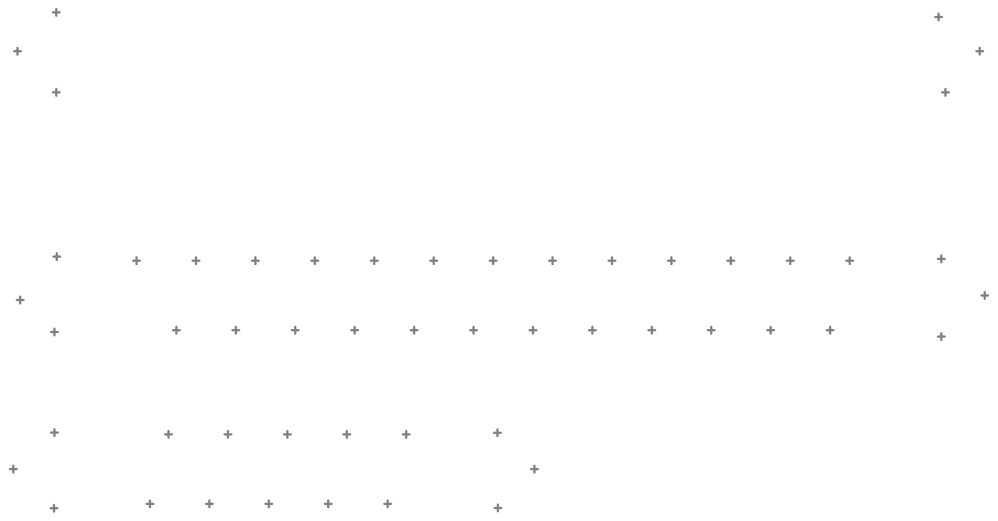
[picture p111: page 22]
