akier900/Capstone_Rohde-Schwarz_Team13/RohdeAndSchwarzWhitePaper/images/Fixed_ZeroBias_Sparam_Sims_v2_0.pdf

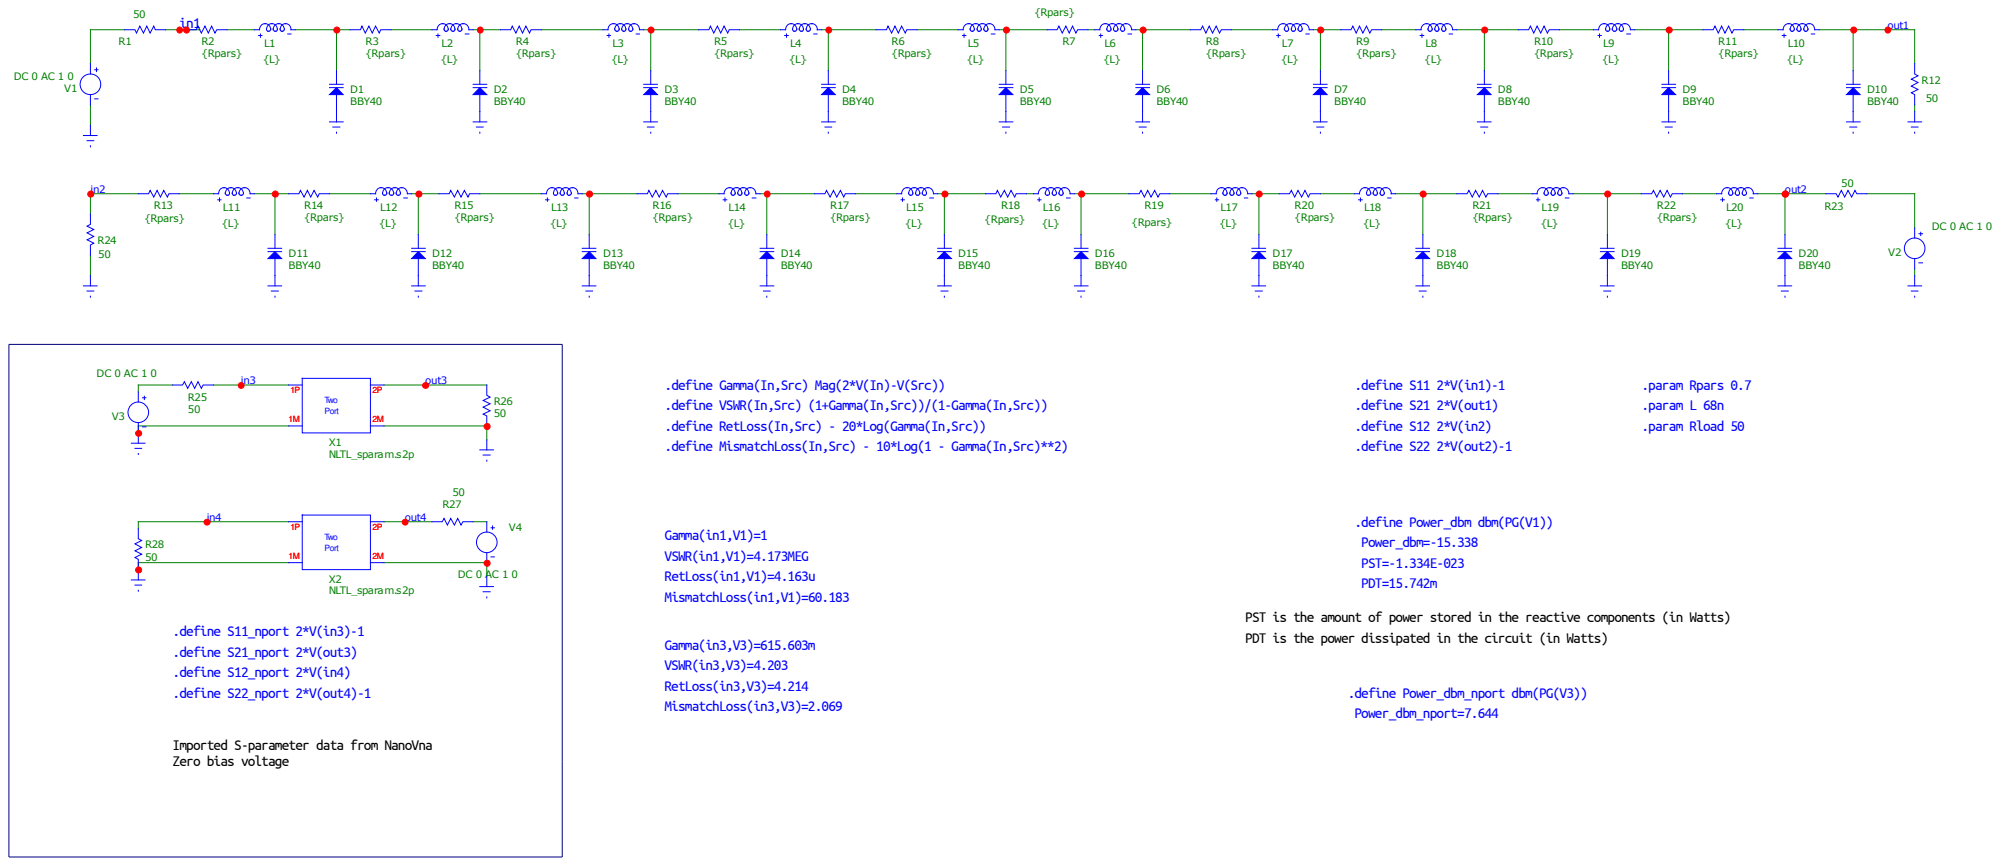
[picture p112: page 1]

.define Gamma(In,Src) Mag(2*V(In)-V(Src))
.define VSWR(In,Src) (1+Gamma(In,Src))/(1-Gamma(In,Src))
.define RetLoss(In,Src) - 20*Log(Gamma(In,Src))
.define MismatchLoss(In,Src) - 10*Log(1 - Gamma(In,Src)**2)

PST is the amount of power stored in the reactive components (in Watts)
PDT is the power dissipated in the circuit (in Watts)

Imported S-parameter data from NanoVna
Zero bias voltage

-20.00

-15.00

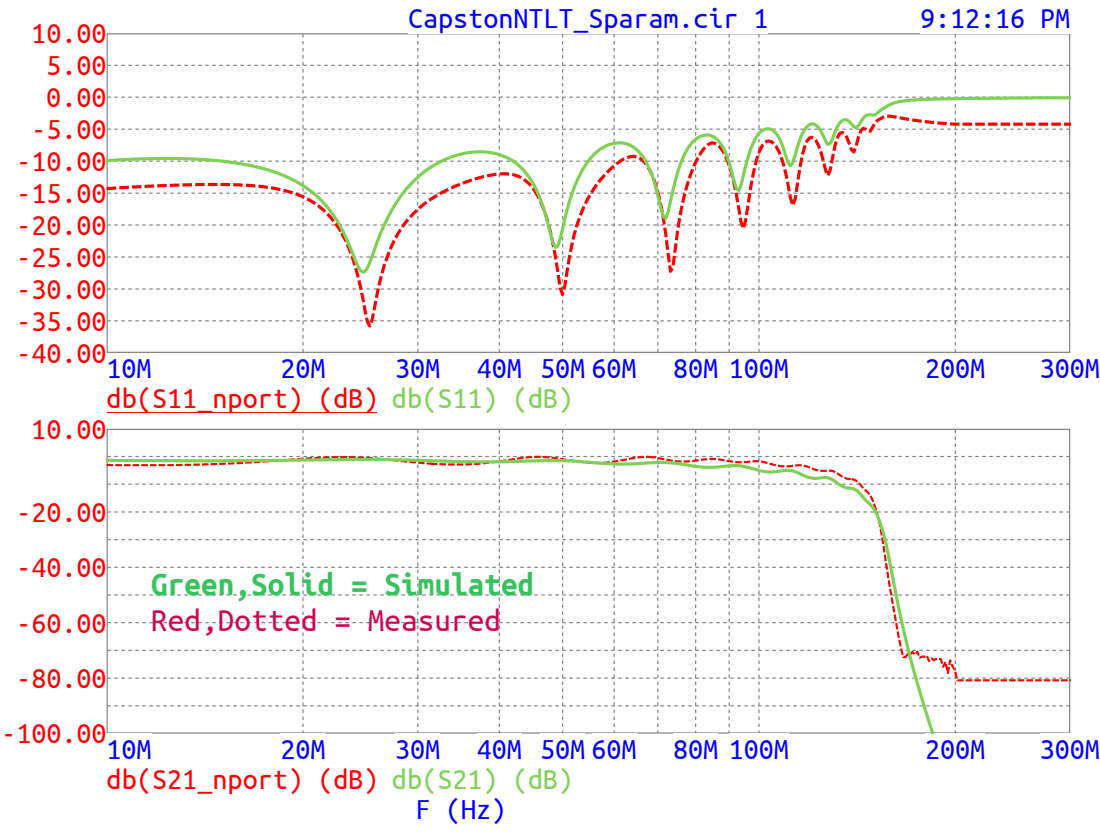
[picture p113: page 2]
db(S21_nport) (dB); CapstonNTLT_Sparam.cir 1

db(S11_nport) (dB) db(S11) (dB)

Green,Solid = Simulated
Red,Dotted = Measured

5.00

10.00

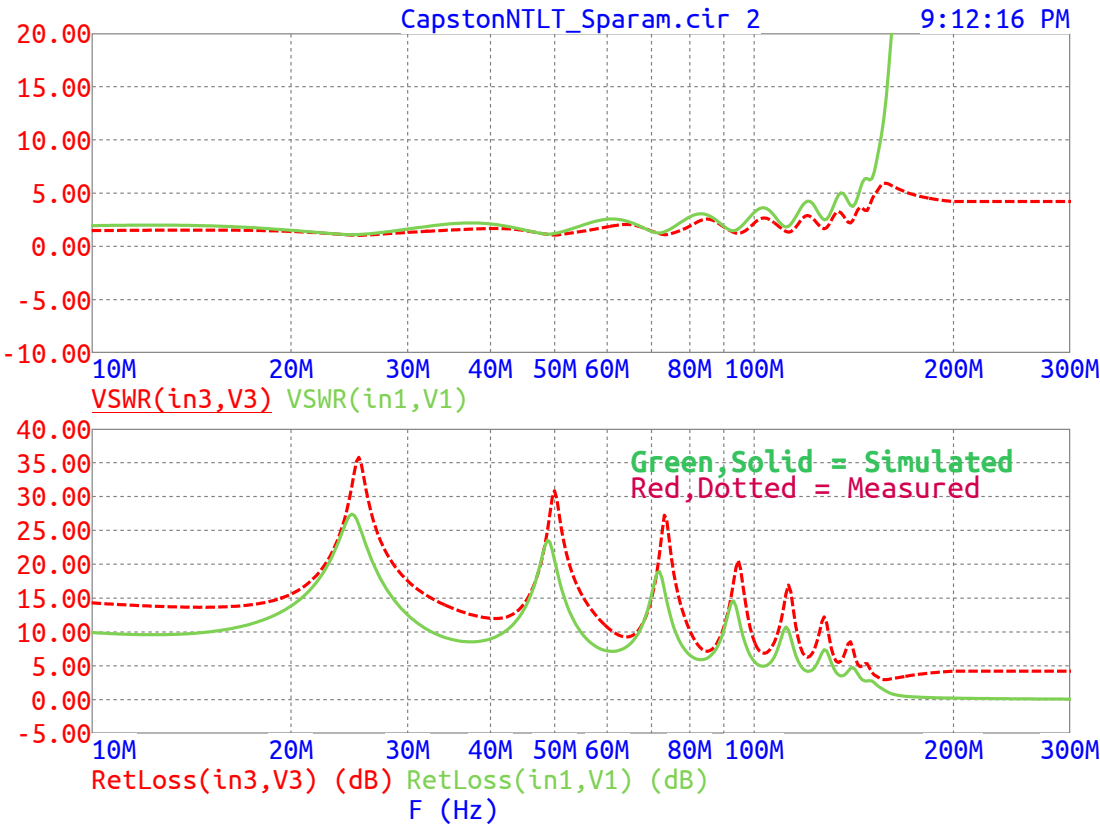
[picture p114: page 3]
VSWR(in3,V3) VSWR(in1,V1); RetLoss(in3,V3) (dB); RetLoss(in1,V1) (dB); CapstonNTLT_Sparam.cir 2

Red,Dotted = Measured Green,Solid = Simulated

0.20

0.50

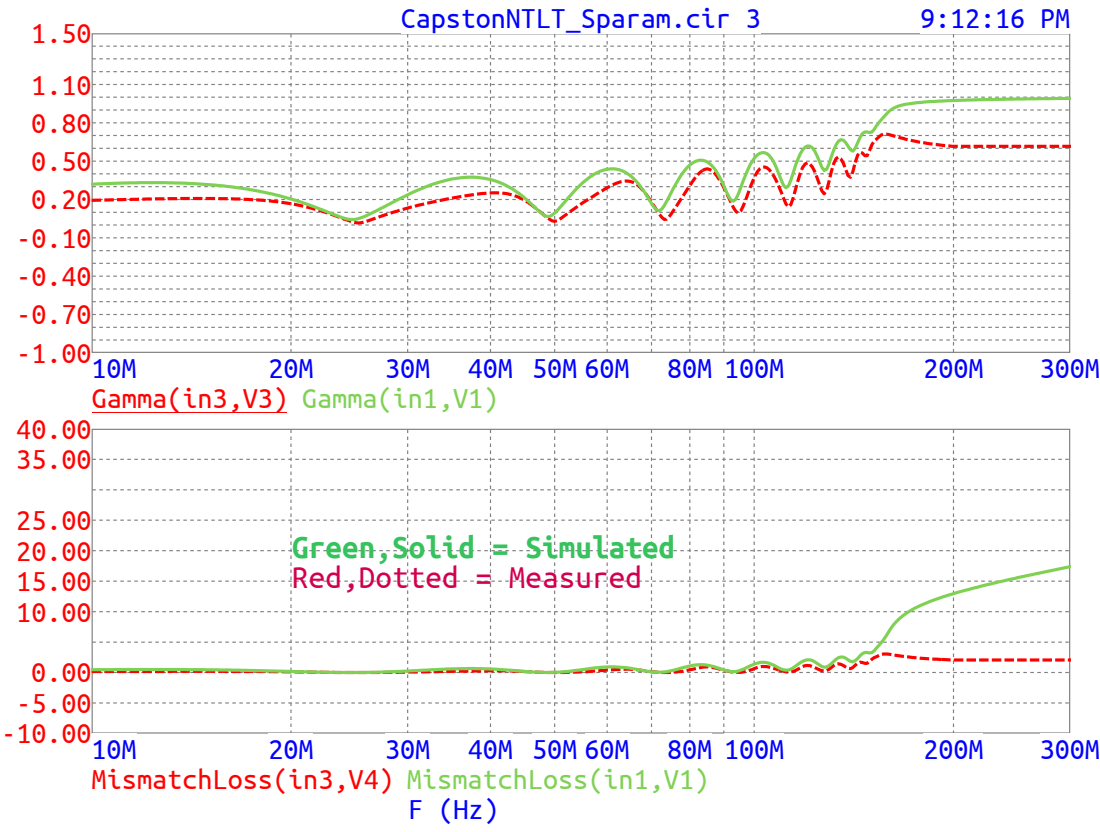
[picture p115: page 4]
Gamma(in3,V3) Gamma(in1,V1); MismatchLoss(in3,V4); MismatchLoss(in1,V1); CapstonNTLT_Sparam.cir 3; Green,Solid; = Simulated

Red,Dotted = Measured
