akier900/Capstone_Rohde-Schwarz_Team13/RohdeAndSchwarzWhitePaper/images/Slow_Square_example_capture.pdf

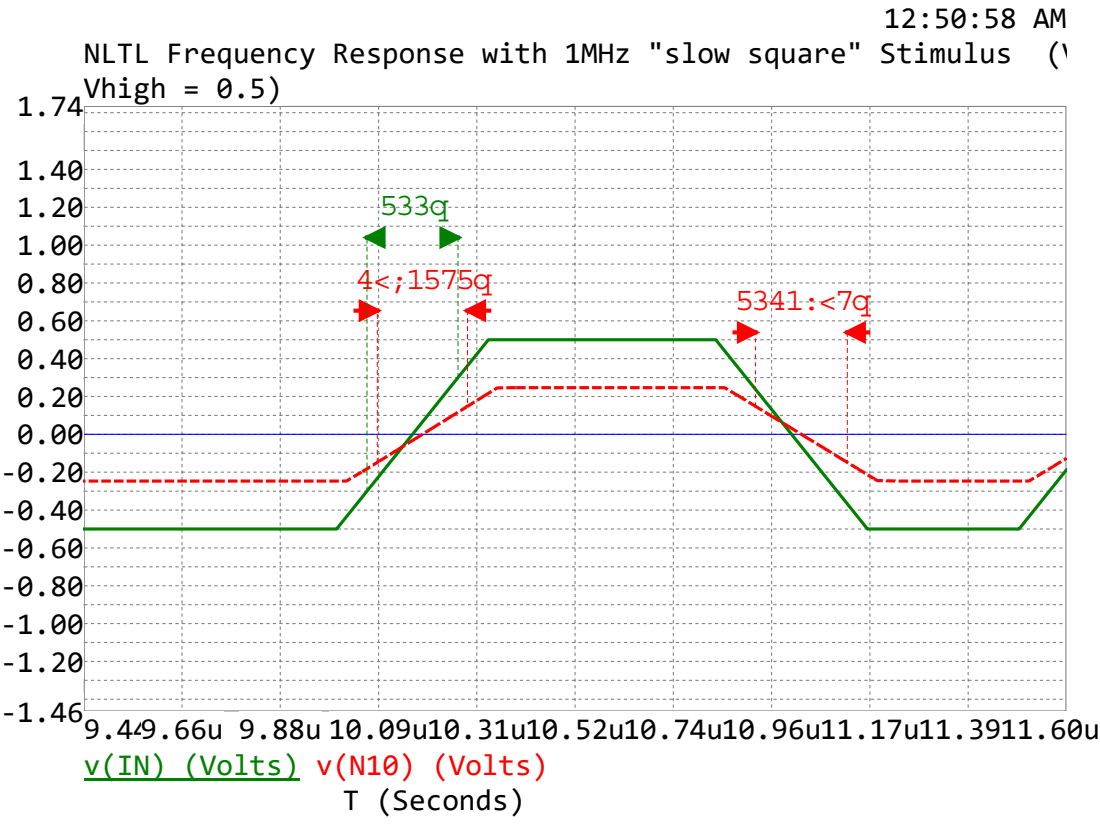
[picture p116: page 1]
v(IN) (Volts); T (Seconds); v(N10) (Volts)

NLTL Frequency Response with 1MHz "slow square" Stimulus (V
Vhigh = 0.5)
