akier900/Capstone_Rohde-Schwarz_Team13/RohdeAndSchwarzWhitePaper/images/Sparam_meas_vs_sims.pdf

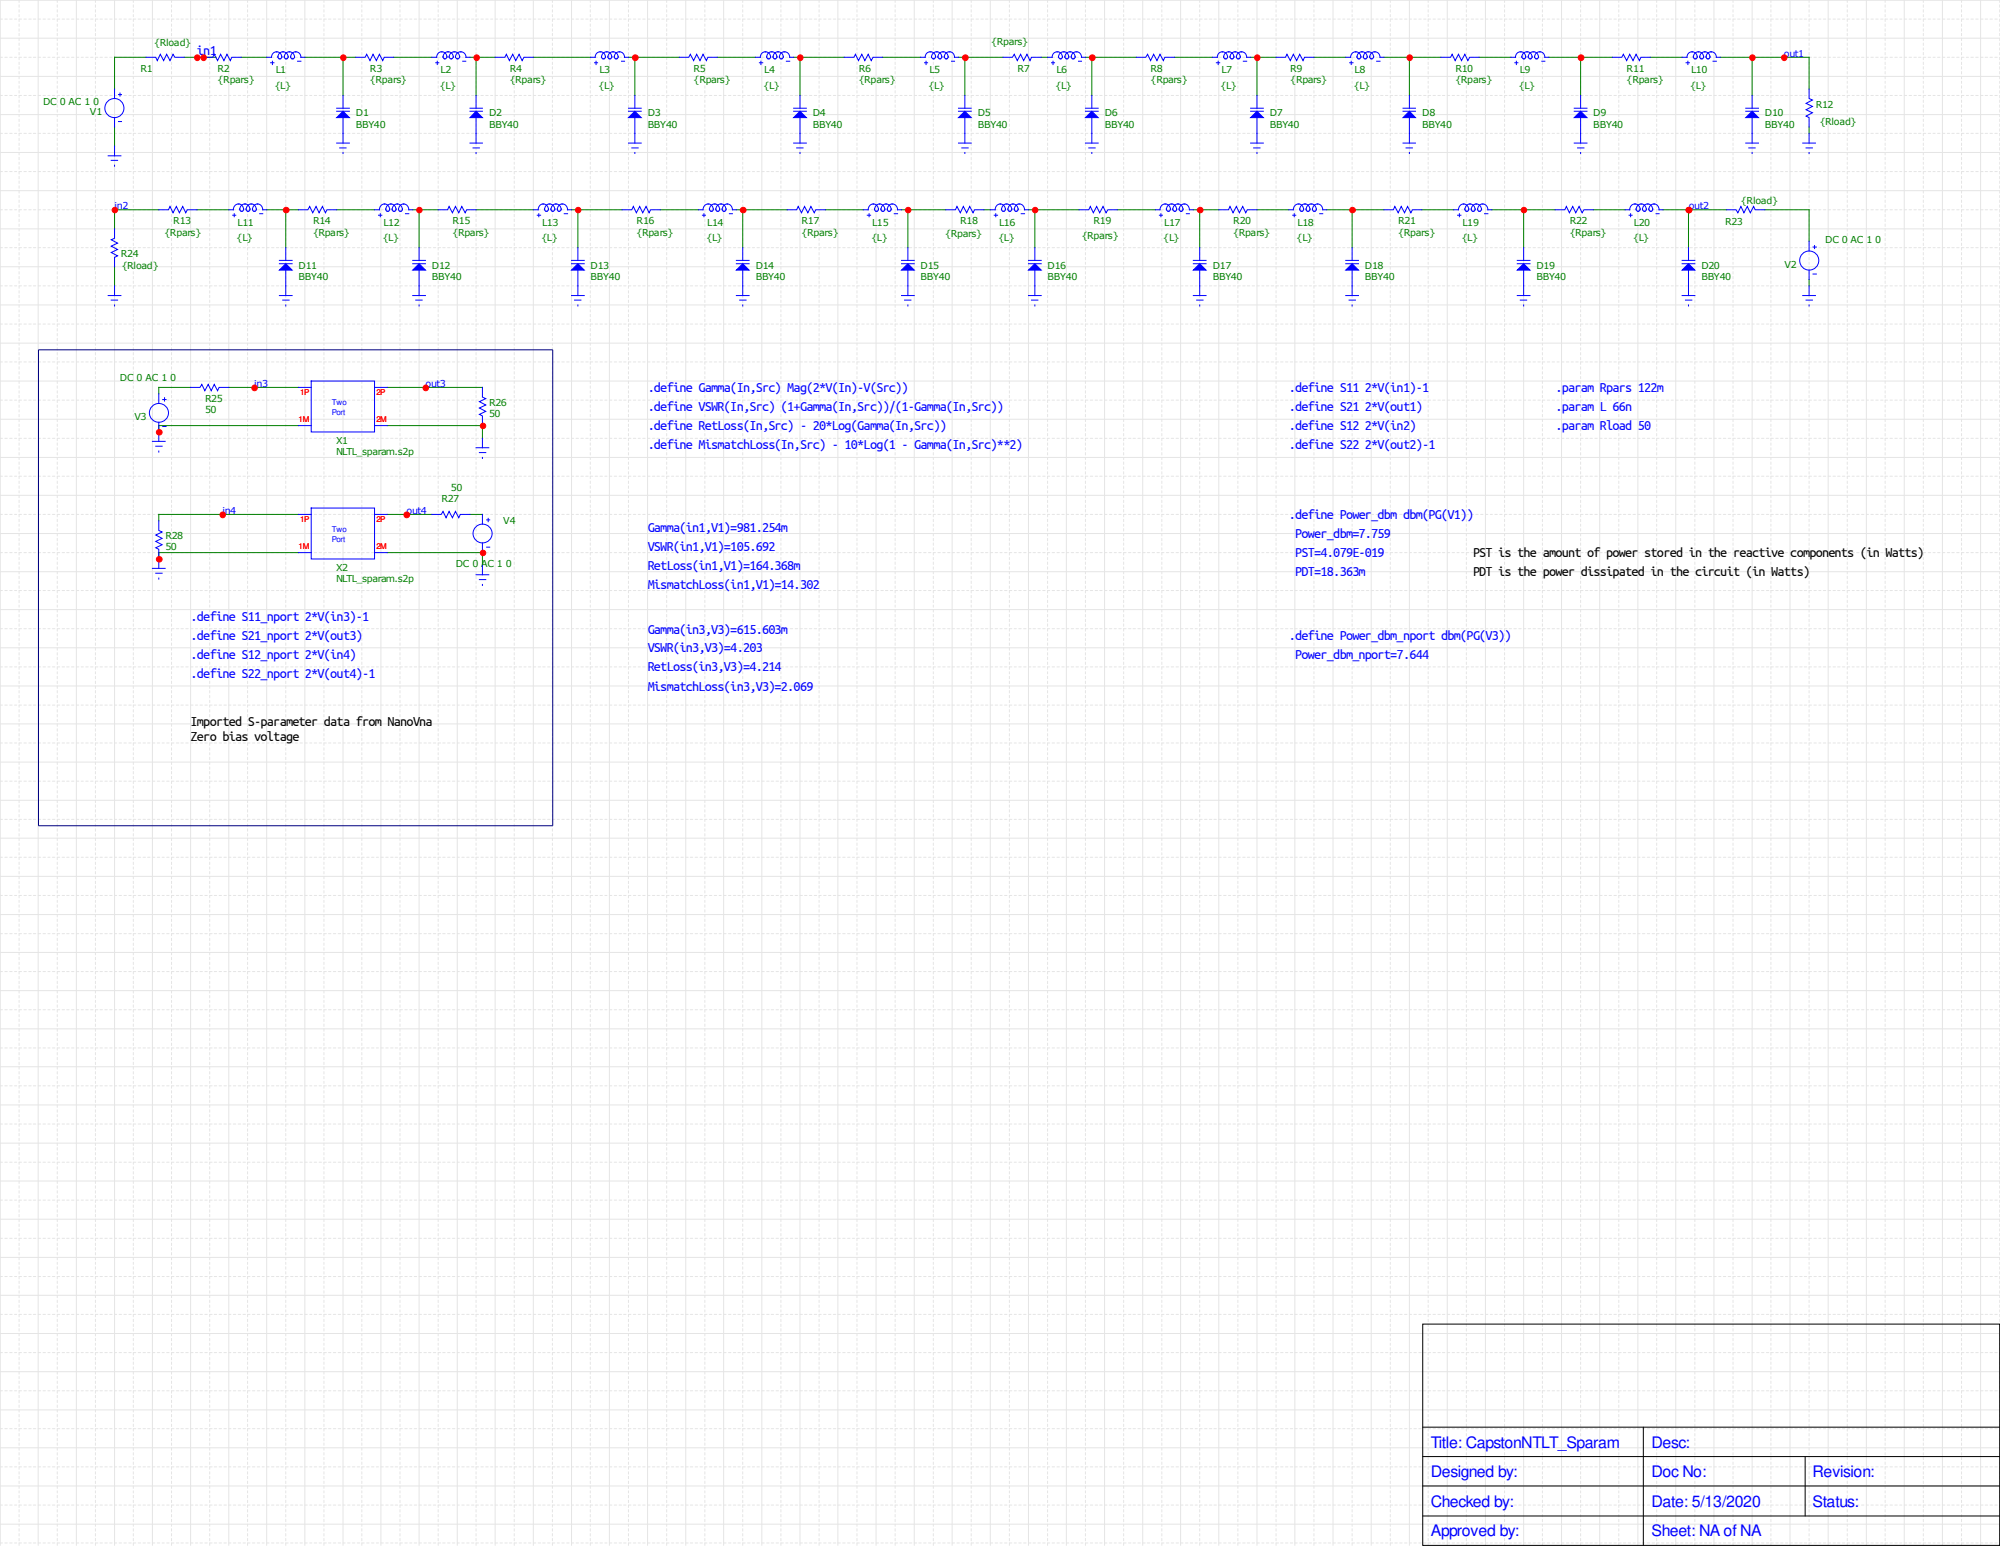
[picture p117: page 1]

.define Gamma(In,Src) Mag(2*V(In)-V(Src))
.define VSWR(In,Src) (1+Gamma(In,Src))/(1-Gamma(In,Src))

PDT is the power dissipated in the circuit (in Watts)

Sheet: NA of NA

-20.00

-10.00

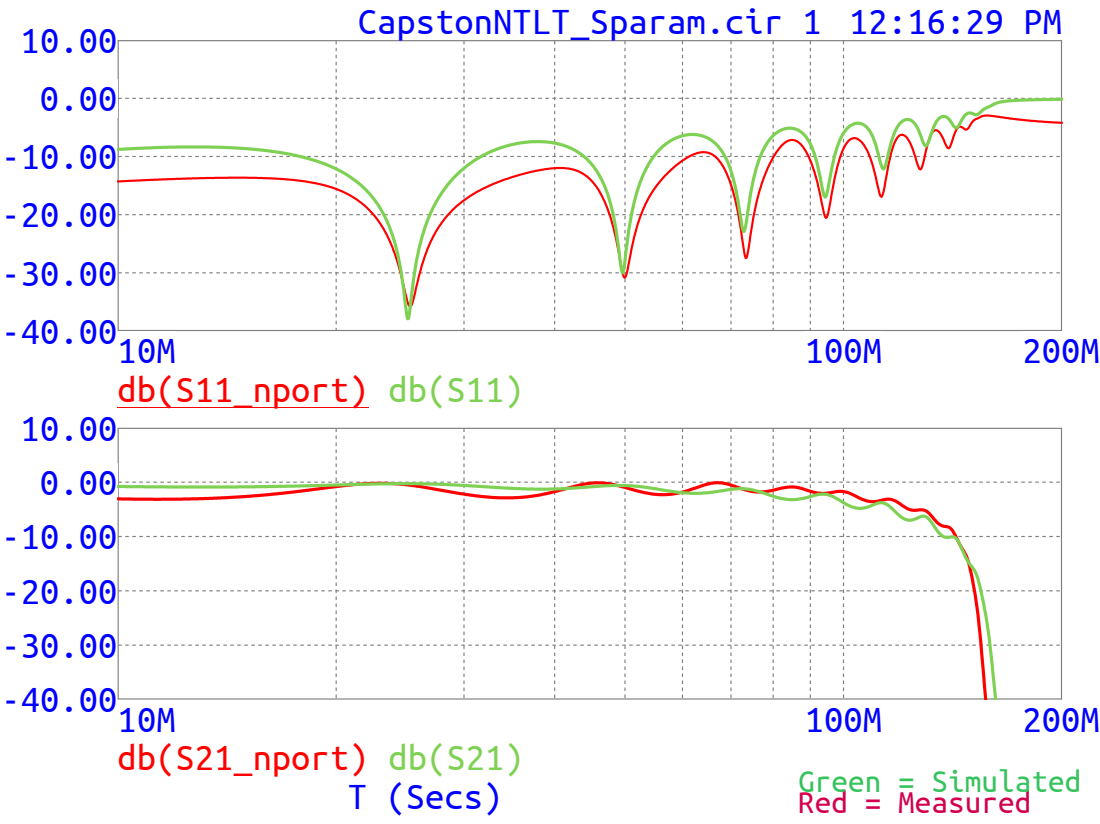
[picture p118: page 2]
db(S11_nport); db(S21_nport) T (Secs); CapstonNTLT_Sparam.cir 1 12:16:29 PM

Red = Measured Green = Simulated

0.40K

0.60K

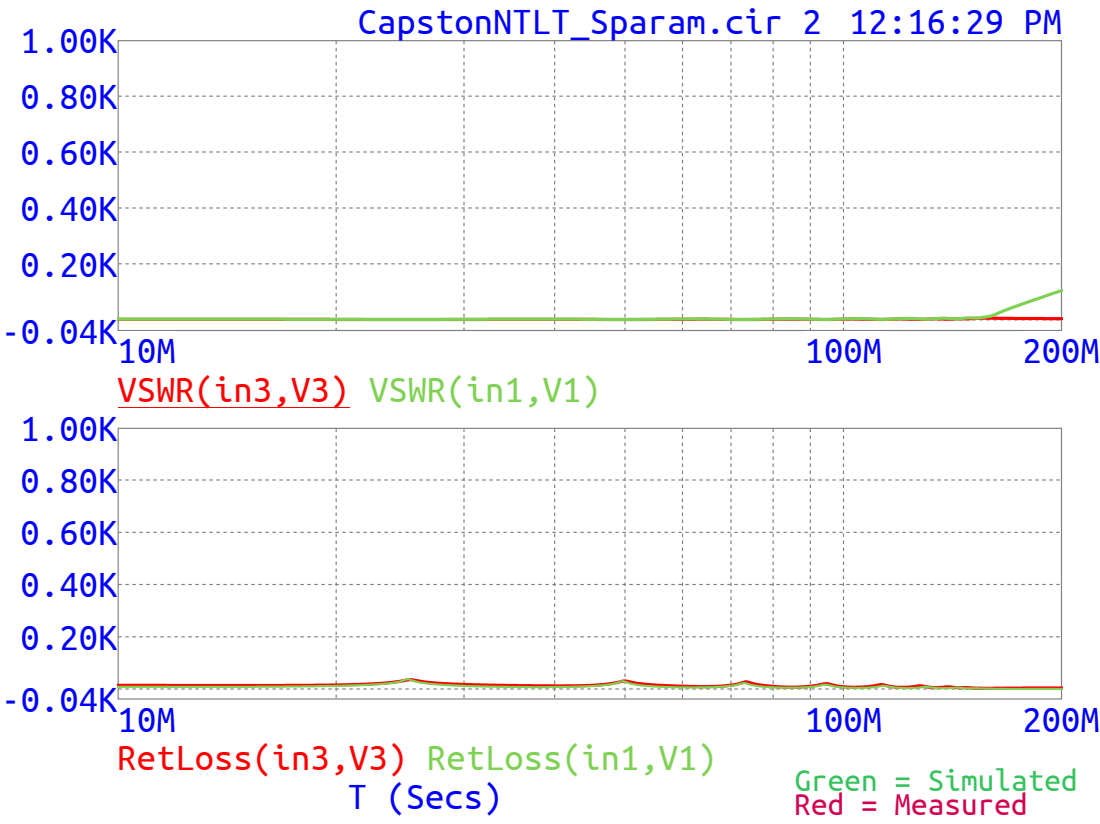
[picture p119: page 3]
VSWR(in3,V3); RetLoss(in3,V3); VSWR(in1,V1); RetLoss(in1,V1); CapstonNTLT_Sparam.cir 2 12:16:29 PM; Red = Measured; Green = Simulated

0.00

24.00

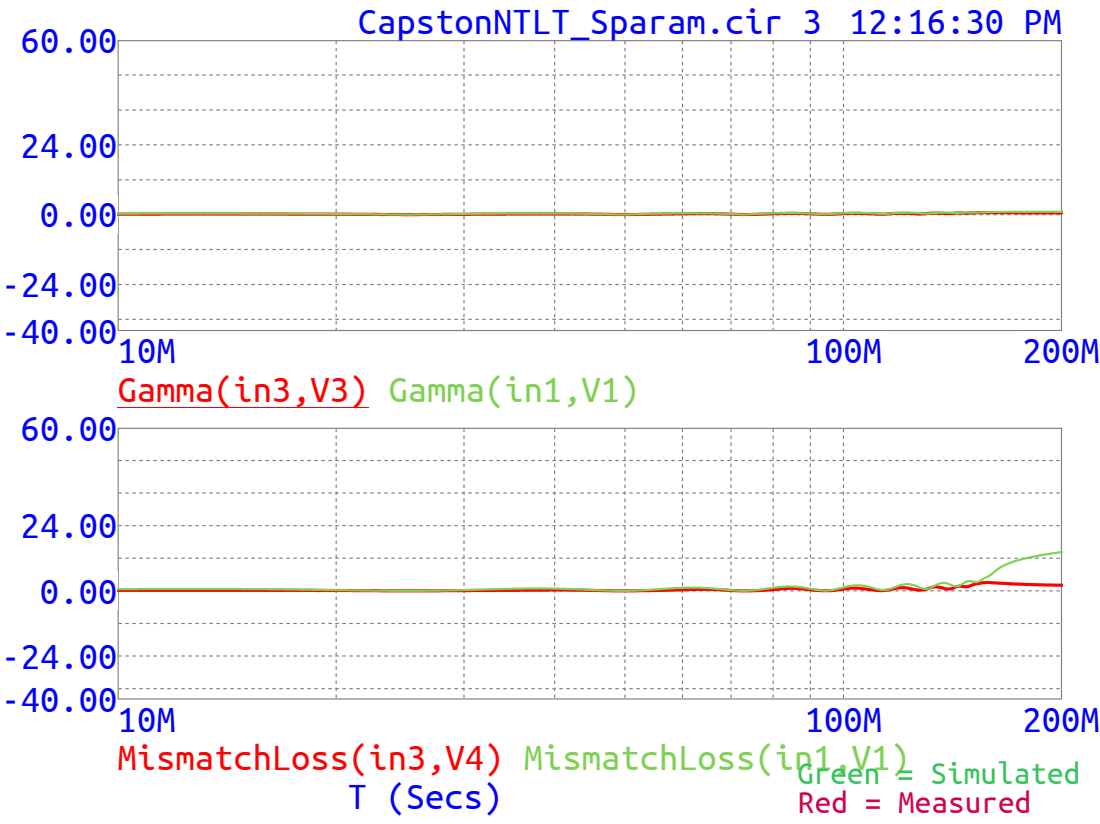
[picture p120: page 4]
Gamma(in3,V3); MismatchLoss(in3,V4); Gamma(in1,V1); MismatchLoss(in1,V1); CapstonNTLT_Sparam.cir 3 12:16:30 PM; Red = Measured; Green = Simulated
