akier900/Capstone_Rohde-Schwarz_Team13/RohdeAndSchwarzWhitePaper/images/Spectrum_noWindow.pdf

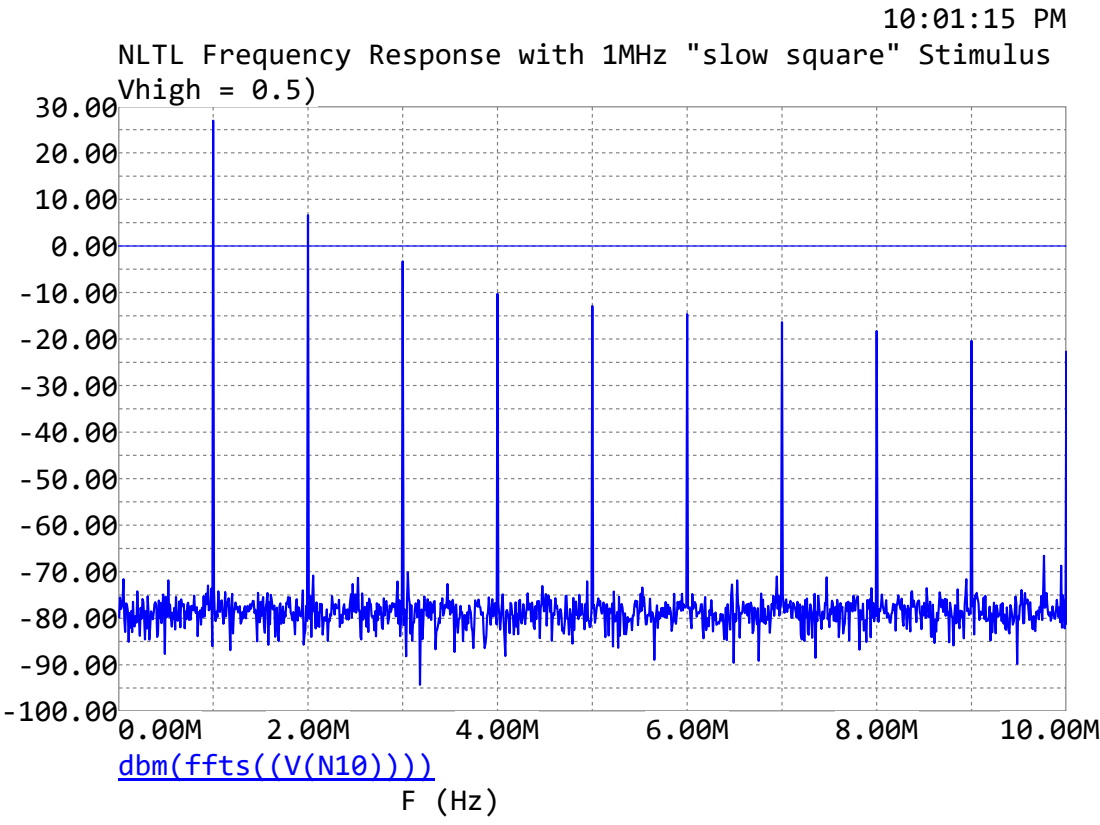
[picture p121: page 1]
dbm(ffts((V(N10)))) F (Hz)

NLTL Frequency Response with 1MHz "slow square" Stimulus (Vlow = -0.5,
Vhigh = 0.5)
