akier900/Capstone_Rohde-Schwarz_Team13/RohdeAndSchwarzWhitePaper/images/SpectrumHanning.pdf

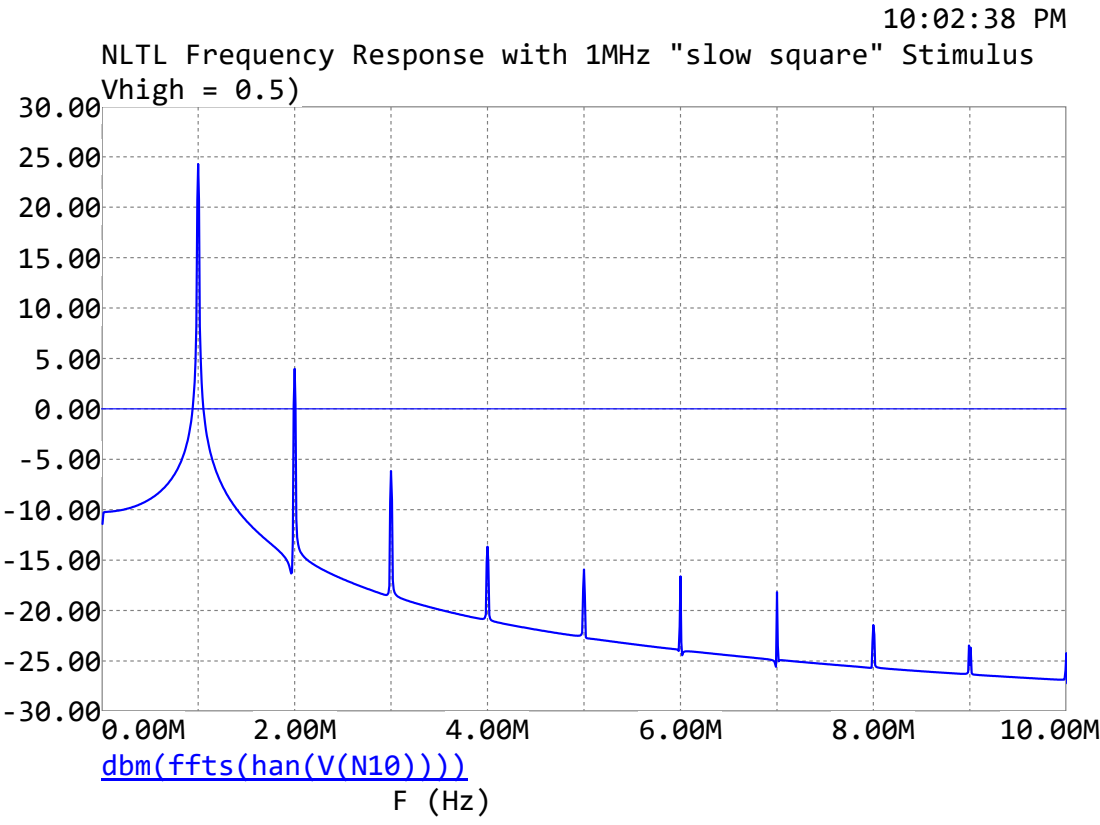
[picture p122: page 1]

NLTL Frequency Response with 1MHz "slow square" Stimulus (Vlow = -0.5,
Vhigh = 0.5)

dbm(ffts(han(V(N10))))
