akier900/Capstone_Rohde-Schwarz_Team13/RohdeAndSchwarzWhitePaper/images/FreqResponseB1.pdf

## 109.39MEG,-9.859

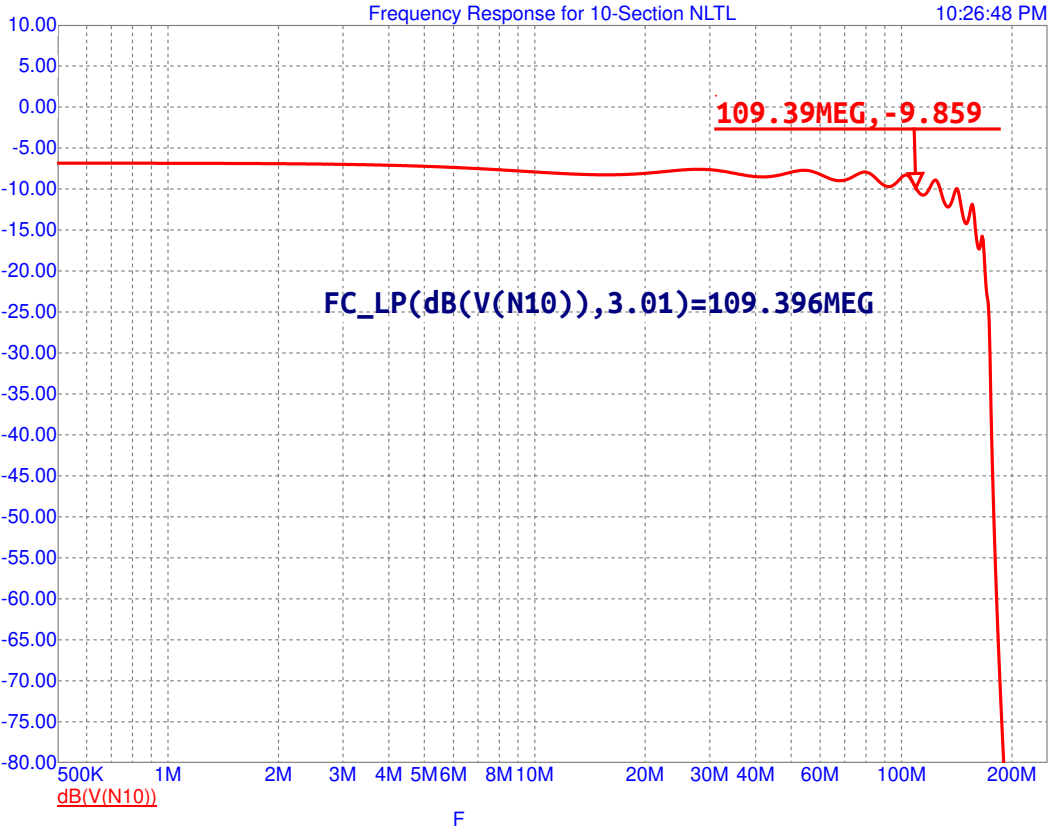
[picture p123: page 1]
Frequency Response for 10-Section NLTL; FC_LP(dB(V(N10)),3.01)=109.396MEG
