akier900/Capstone_Rohde-Schwarz_Team13/RohdeAndSchwarzWhitePaper/images/Probed_Input_N10_N120.pdf

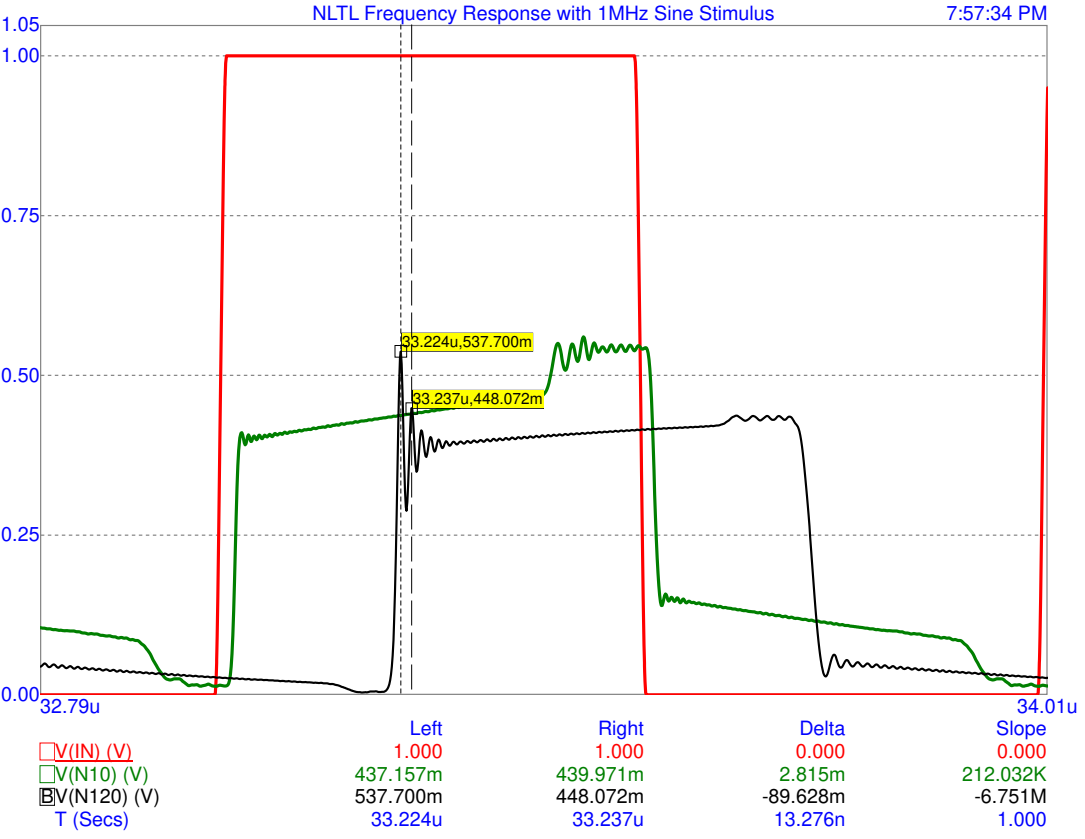
[picture p124: page 1]
T (Secs); NLTL Frequency Response with 1MHz Sine Stimulus; Left; Right; Delta; Slope
