akier900/Capstone_Rohde-Schwarz_Team13/RohdeAndSchwarzWhitePaper/images/Probed_Input_N10_N240.pdf

4.486n 6n

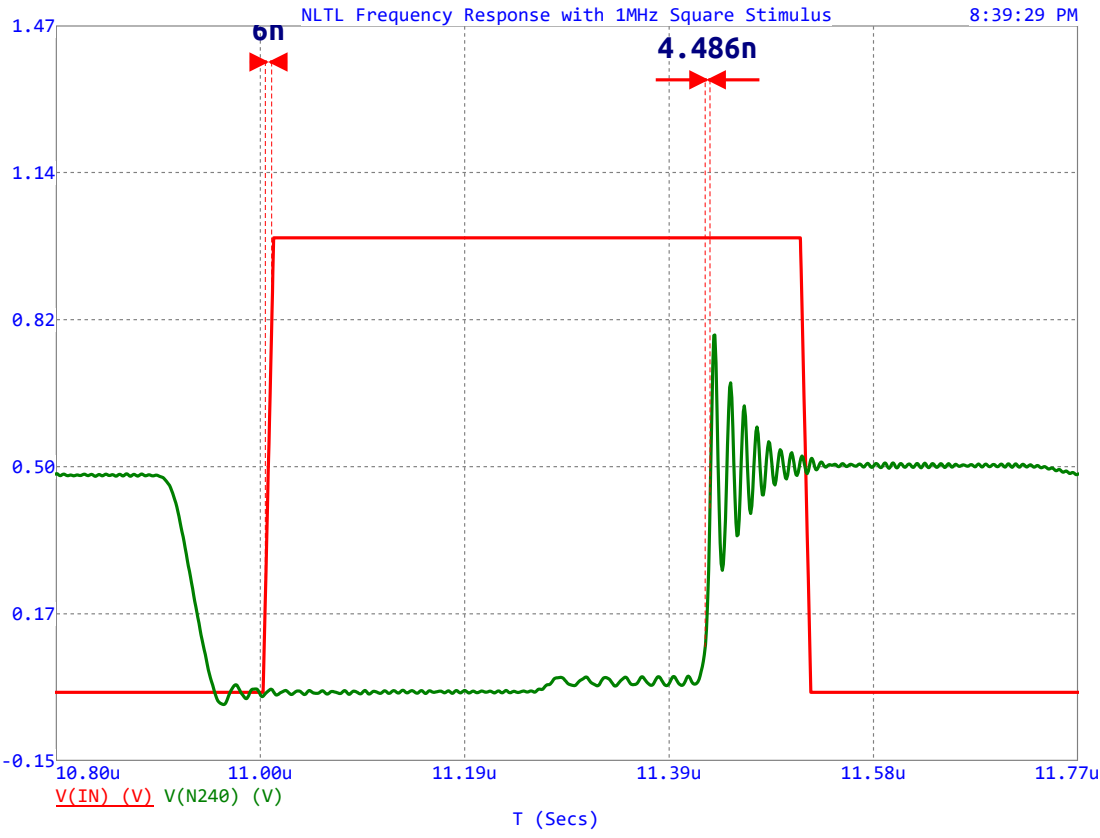
[picture p125: page 1]
T (Secs); NLTL Frequency Response with 1MHz Square Stimulus
