akier900/Capstone_Rohde-Schwarz_Team13/RohdeAndSchwarzWhitePaper/images/Probed_Input_N10_N240_NoSeriesResistance.pdf

## Risetime Vin

6n | 4.486n

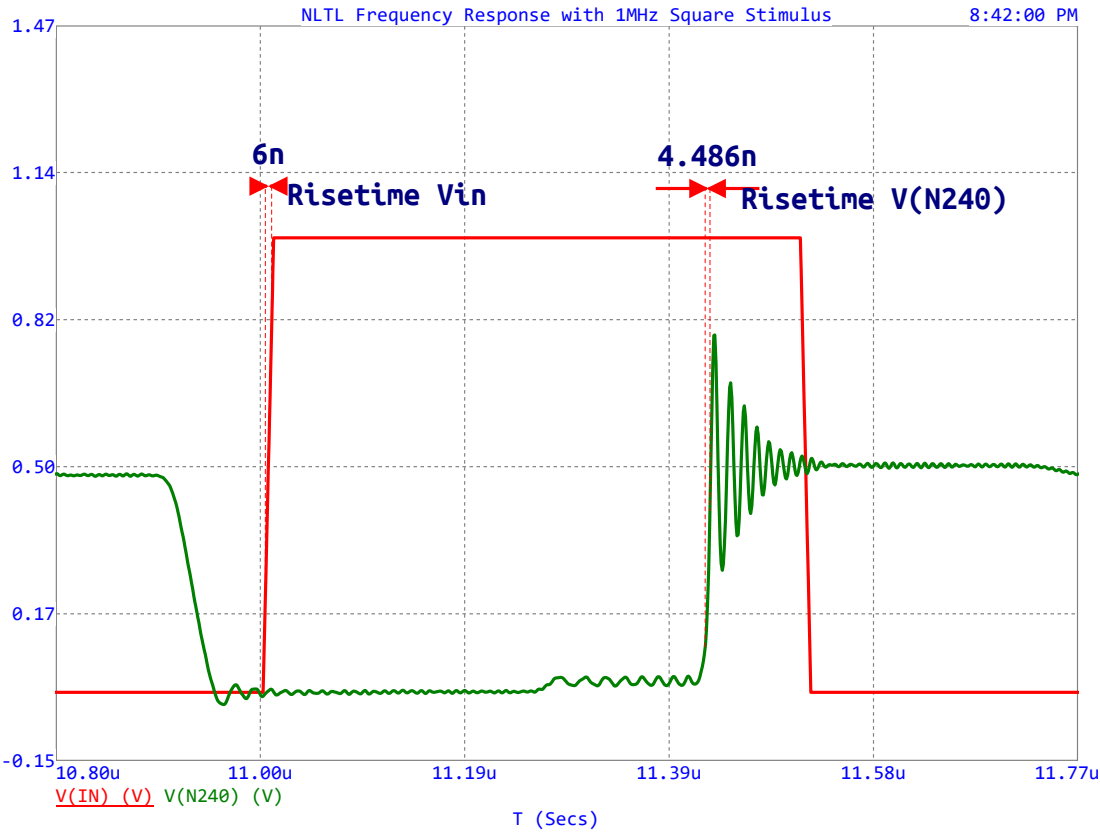
[picture p126: page 1]
T (Secs); NLTL Frequency Response with 1MHz Square Stimulus; Risetime
