akier900/Capstone_Rohde-Schwarz_Team13/RohdeAndSchwarzWhitePaper/images/Probed_Input_N10_N240_With_SeriesResistance.pdf

6n

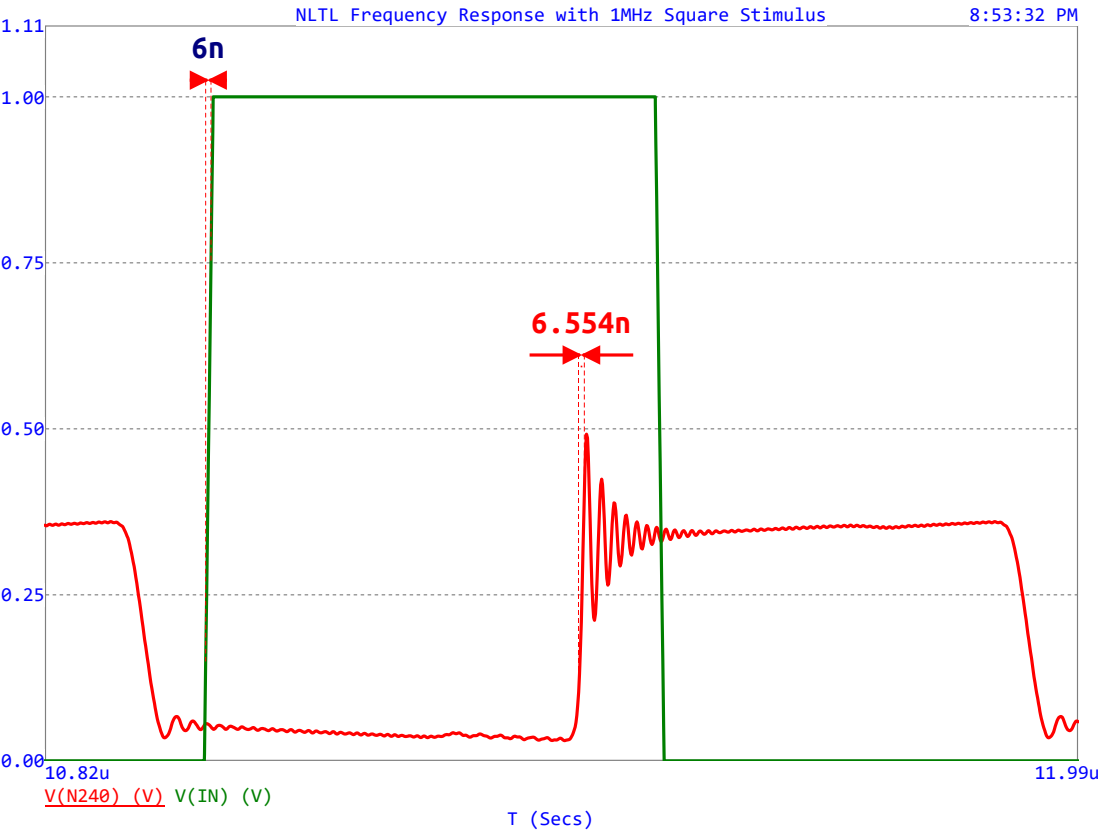
[picture p127: page 1]
T (Secs); NLTL Frequency Response with 1MHz Square Stimulus
