akier900/Capstone_Rohde-Schwarz_Team13/RohdeAndSchwarzWhitePaper/images/InitialZeroBias_Sparam_Sims.pdf

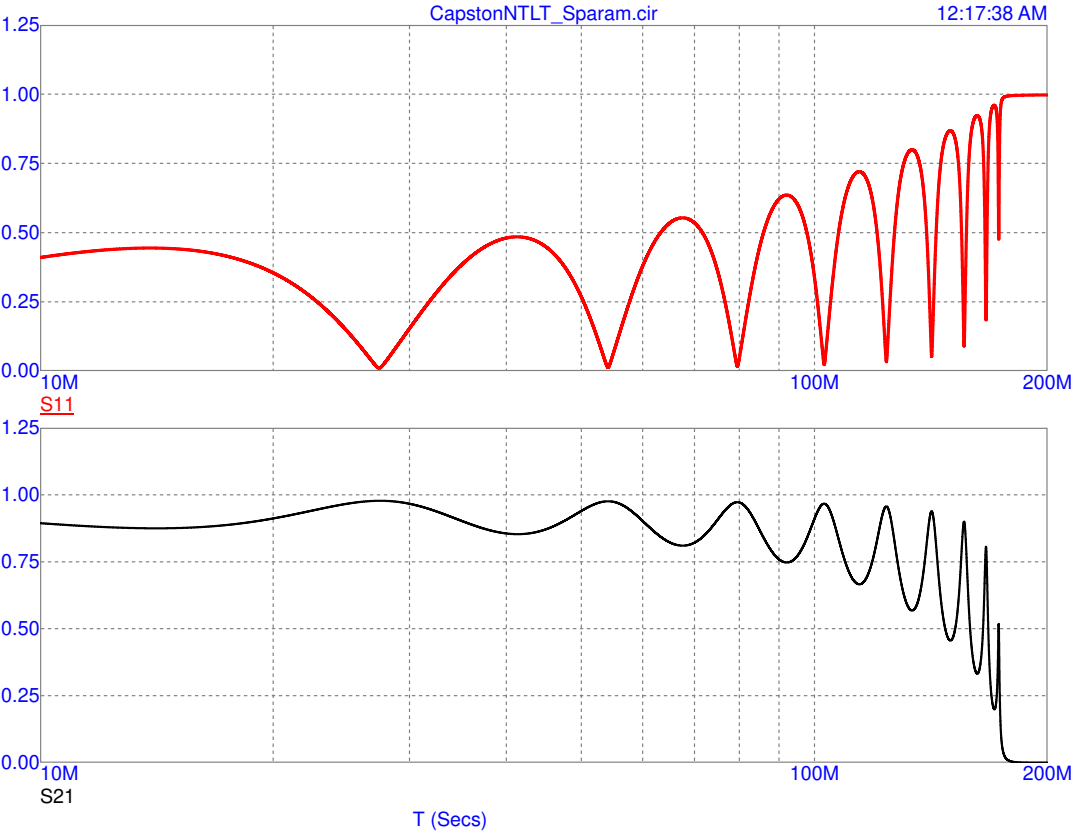
[picture p128: page 1]
T (Secs); CapstonNTLT_Sparam.cir
