akier900/Capstone_Rohde-Schwarz_Team13/RohdeAndSchwarzWhitePaper/images/Fixed_ZeroBias_Sparam_Sims.pdf

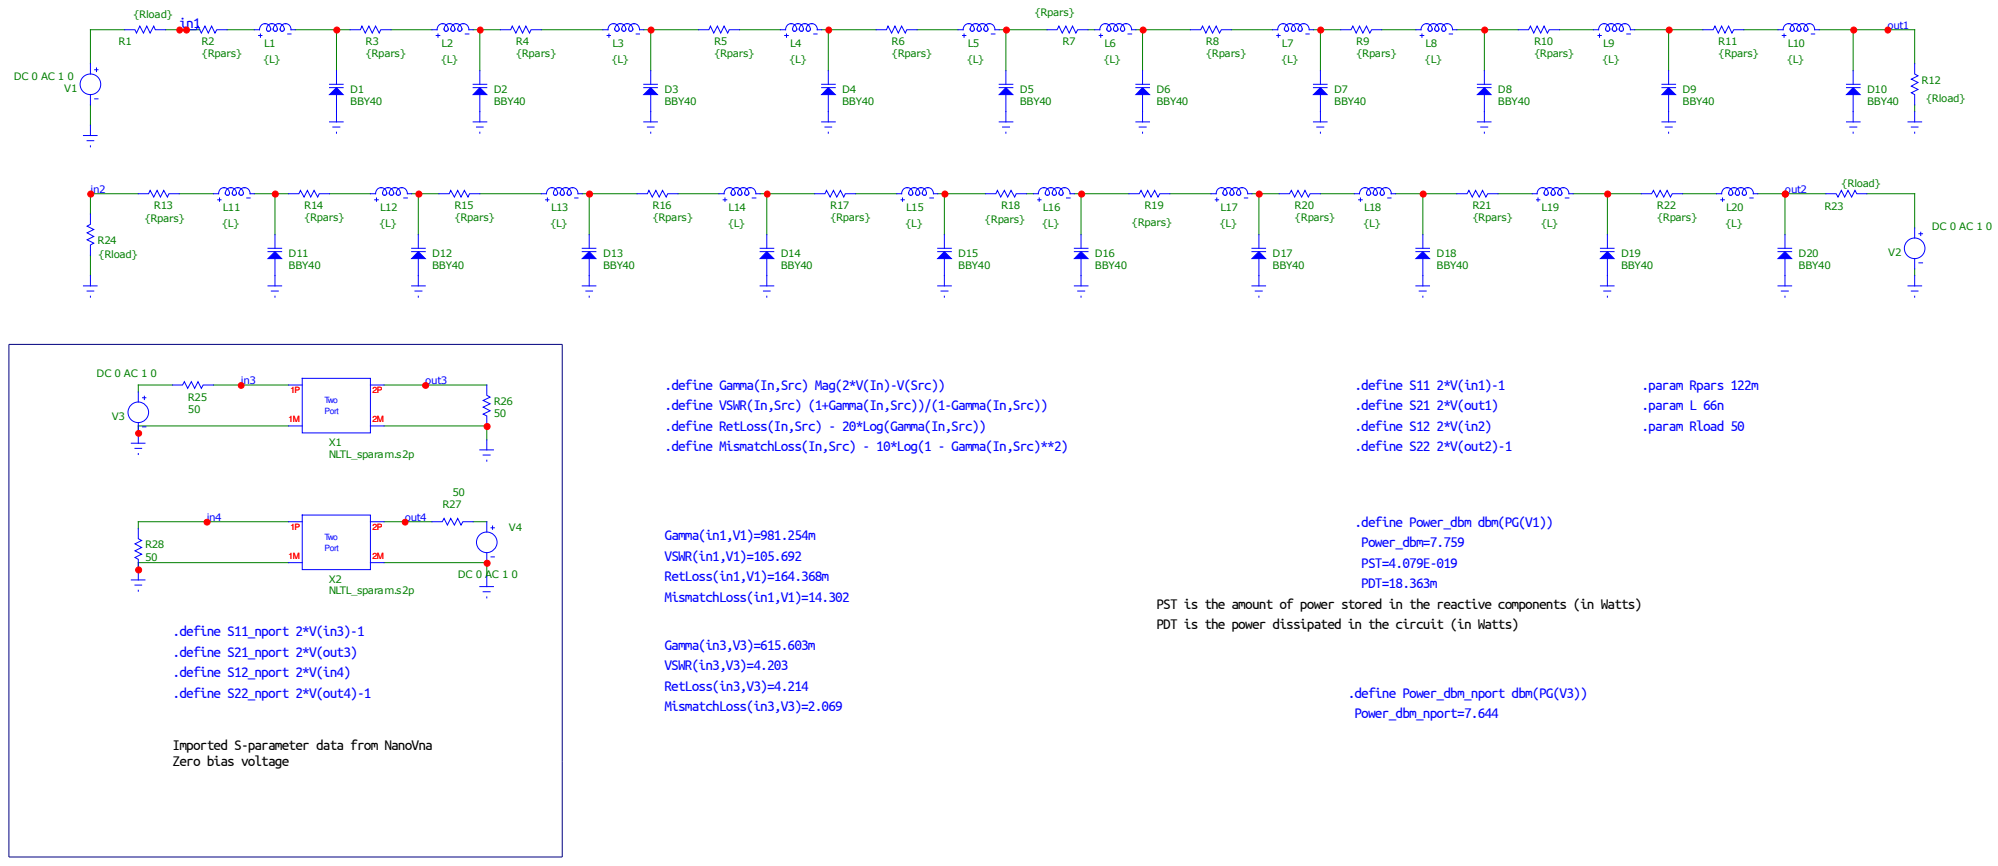
[picture p129: page 1]

.define Gamma(In,Src) Mag(2*V(In)-V(Src))
.define VSWR(In,Src) (1+Gamma(In,Src))/(1-Gamma(In,Src))
.define RetLoss(In,Src) - 20*Log(Gamma(In,Src))
.define MismatchLoss(In,Src) - 10*Log(1 - Gamma(In,Src)**2)

PST is the amount of power stored in the reactive components (in Watts)
PDT is the power dissipated in the circuit (in Watts)

Imported S-parameter data from NanoVna
Zero bias voltage

-18.57

-11.43

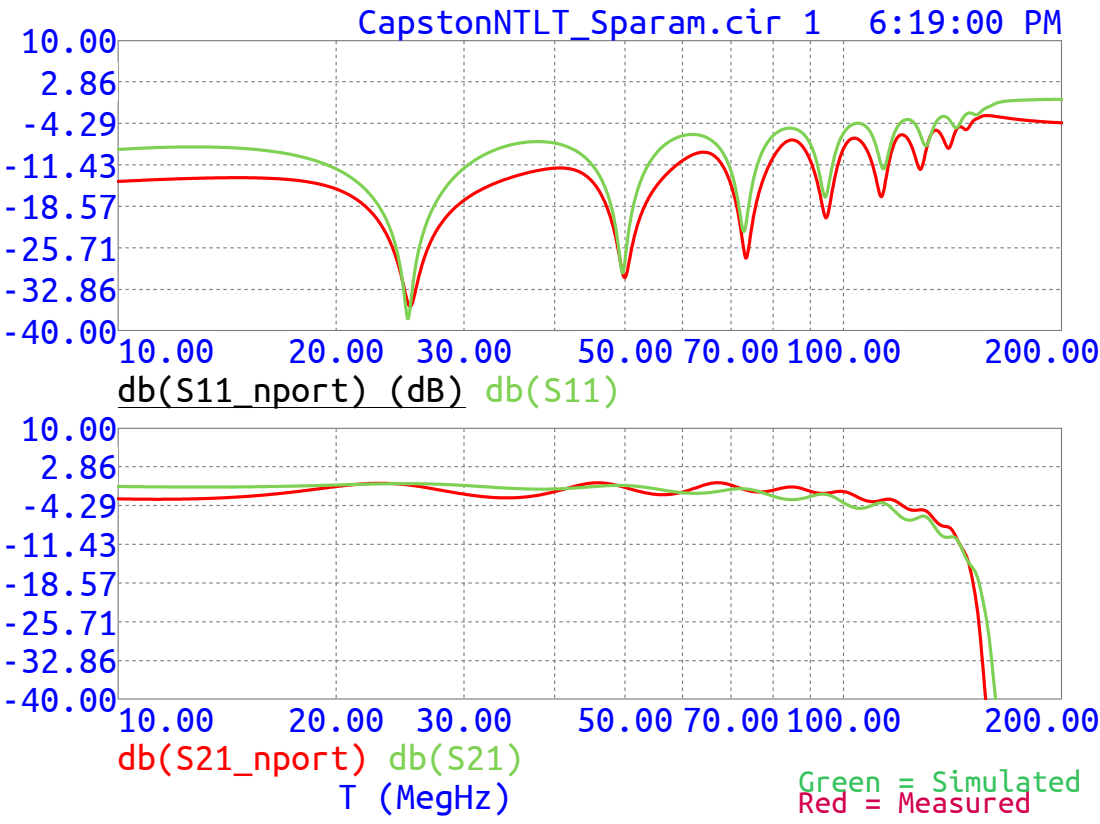
[picture p130: page 2]
db(S11_nport) (dB); db(S21_nport) T (MegHz); CapstonNTLT_Sparam.cir 1

Red = Measured Green = Simulated

54.29

85.71

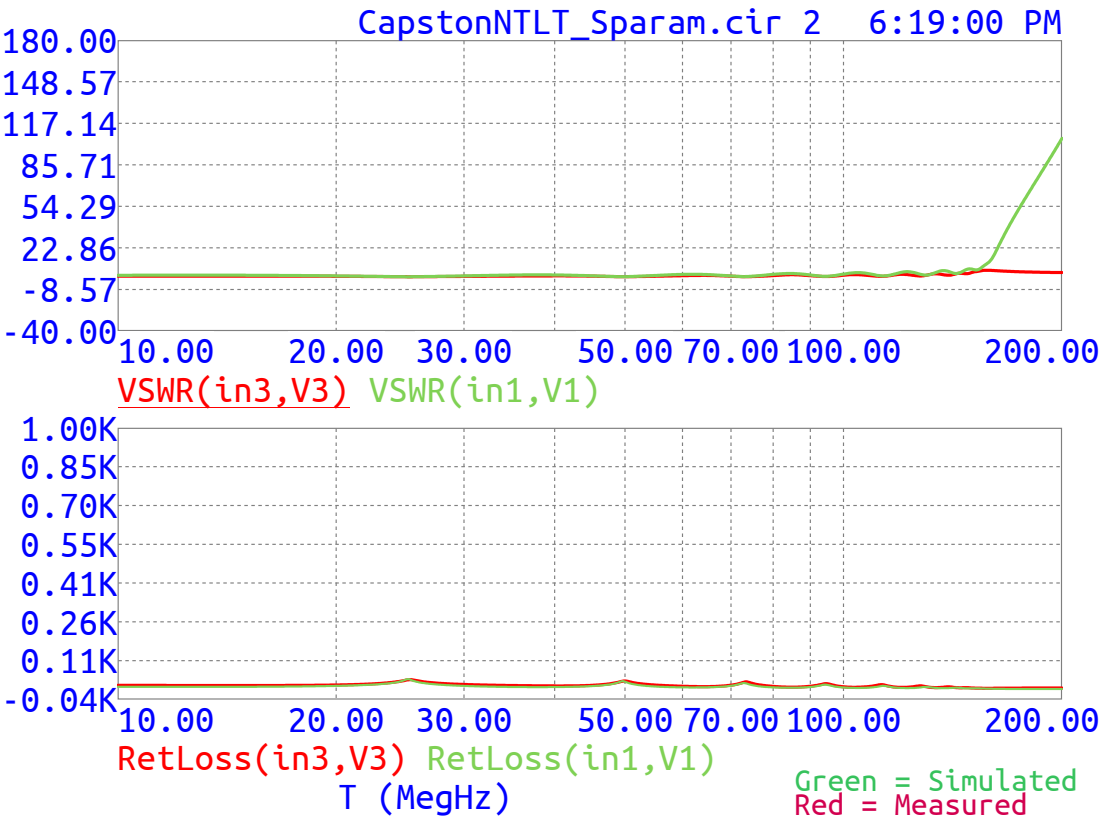
[picture p131: page 3]
VSWR(in3,V3); RetLoss(in3,V3); VSWR(in1,V1); RetLoss(in1,V1); CapstonNTLT_Sparam.cir 2; Red = Measured; Green = Simulated

-1.43

1.43

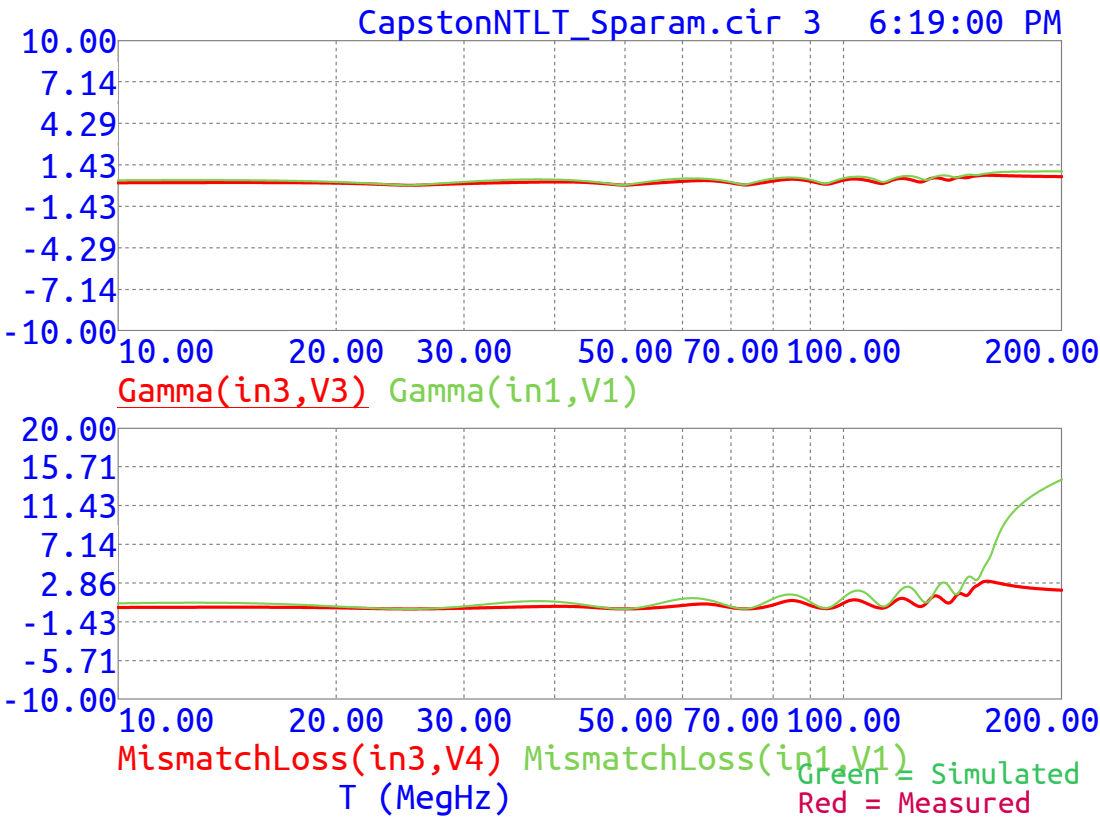
[picture p132: page 4]
Gamma(in3,V3); MismatchLoss(in3,V4); Gamma(in1,V1); MismatchLoss(in1,V1); CapstonNTLT_Sparam.cir 3; Red = Measured; Green = Simulated
