akier900/Capstone_Rohde-Schwarz_Team13/MeetingFiles/FilesForMeeting_5_6_2020/Simulation/Transient/NLTLRetry.cir

[Main]
FileType=CIR
Version=12.00
Program=Micro-Cap
Component Version=10.00
Shape Version=11.00
Screen=2560,1080
MCAPVersion=12.2.0.3
Key ID=Demo
NLCnt=887
TXCnt=112

[shapedef]
Name=Ground
Line=0,0,12,0
Line=12,-8,12,8
Line=18,-4,18,4
Line=24,0,24,0

[shapedef]
Name=Inductor
Line=42,0,48,0
Line=0,0,5,0
Arc=5,-7,17,7 , 11,-7,5,0
Arc=13,-7,25,7 , 19,-7,13,0
Arc=29,-7,41,7 , 35,-7,29,0
Arc=21,-7,33,7 , 27,-7,21,0
Arc=6,-7,18,7 , 18,0,12,-7
Arc=14,-7,26,7 , 26,0,20,-7
Arc=22,-7,34,7 , 34,0,28,-7
Arc=30,-7,42,7 , 42,0,36,-7
Line=11,-7,12,-7
Line=19,-7,20,-7
Line=27,-7,28,-7
Line=35,-7,36,-7
Arc=13,-4,17,2 , 13,-1,15,2
Arc=29,-4,33,2 , 29,-1,31,2
Arc=21,-4,25,2 , 21,-1,23,2
Arc=14,-4,18,2 , 16,2,18,-1
Arc=30,-4,34,2 , 32,2,34,-1
Arc=22,-4,26,2 , 24,2,26,-1
Line=15,2,16,2
Line=23,2,24,2
Line=31,2,32,2
Line=5,5,9,5
Line=41,5,41,9
Line=39,7,43,7
Current=32,8,16,8

[shapedef]
Name=Plus.root
Line=-2,0,2,0
Line=0,-2,0,2

[shapedef]
Name=Resistor
PolyOpen=12
PolyLine=0,0
PolyLine=0,0
PolyLine=12,0
PolyLine=14,-4
PolyLine=18,4
PolyLine=22,-4
PolyLine=26,4
PolyLine=30,-4
PolyLine=34,4
PolyLine=36,0
PolyLine=48,0
PolyLine=48,0
Current=32,8,16,8

[shapedef]
Name=SPICE_V
Root="Vsource.root",0,0,0

[shapedef]
Name=Varactor
Line=28,0,48,0
PolyClosed=3
PolyLine=20,0
PolyLine=28,-8
PolyLine=28,8
Line=16,0,0,0
Line=16,-8,16,8
Line=20,-8,20,8
Current=32,16,16,16

[shapedef]
Name=Vsource.root
Line=0,0,12,0
Line=36,0,48,0
Ellipse=12,-12,36,12
FColor=None
Line=7,5,7,9
Root="Plus.root",41,7,0
Current=32,16,16,16

[compdef]
Name=Resistor
Definition=Resistor
Shape=Resistor
Mask=6401
Used=394
memo=Resistor
Label Offset=18,6,8,11
PinCnt=2
Pin="Plus",6,0,-10,-4
Pin="Minus",0,0,-14,-4

[compdef]
Name=BBY40
Definition=Diode
Shape=Varactor
Mask=4480
Used=64
memo=Variable Capacitance Diode Ct3=29pF Vr=30V If=20mA
Label Offset=19,15,16,14
PinCnt=2
Pin="Anode",6,0,-12,-2
Pin="Cathode",0,0,-24,-2

[compdef]
Name=Ground
Definition=Ground
Shape=Ground
Mask=1793
Used=472
memo=Ground
Label Offset=0,0,0,0
PinCnt=1
Pin="PinA",0,0,-3,-7

[compdef]
Name=Voltage Source
Definition=VSpice
Shape=SPICE_V
Mask=4865
Used=73
memo=Voltage Source
Label Offset=19,13,15,13
PinCnt=2
Pin="Plus",6,0,-5,-6
Pin="Minus",0,0,-20,-6

[compdef]
Name=Inductor
Definition=Inductor
Shape=Inductor
Mask=7681
Used=164
memo=Inductor
Label Offset=18,9,11,12
PinCnt=2
Pin="Plus",6,0,-5,-9
Pin="Minus",0,0,-3,-9

[Circuit]
Window Placement=2,3, -1,-1, -8,-31, 0,0,136,39
Default Object=Color=#FFFFFF,Width=3
Default Object Font=Height=-34,FStyle=4,Color=#000000,Name=Ubuntu Mono
Default Object Apply Border To Text=No
Default Object Apply Fill To Text=No
Default Object GridSnap=No
NodeVoltageFormat=3
CurrentFormat=3
PowerFormat=3
PathDelayFormat=3
WarningFormat=3
GridTextFormulaFormat=3
Window Placement in Transient Analysis=2,3, -1,-1, -8,-31, 1219,0,2438,590
Window Placement in Transient Probe=0,1, -1,-1, -8,-31, 1219,0,2438,792
Window Placement in DC Analysis=2,3, -1,-1, -8,-31, 156,0,2312,594
SpiceType=AMBIGUOUS
Title_Block_Border=One
Title_Block=True
Show Nodes=False
Show Voltages=True
Show Current=False
Show Power=False
Show Condition=False
Show Pin Connections=False
Show Connection Warnings=True
Show Cross=True
Show Attribute Text=True
Show Grid Text=True

[Comp]
Name=Resistor
Px=784,344
Rot=4

[Attr]
ON=18,-20,PART
V=Rs
Style=8192

[Attr]
ON=18,-34,RESISTANCE
V=50
Style=8192

[Attr]
ON=0,0,PACKAGE
V

[Comp]
Name=BBY40
Px=976,392
Rot=1

[Attr]
ON=16,14,PART
V=D1
Style=8192

[Attr]
ON=16,28,MODEL
V=BBY40
Style=8192

[Attr]
ON=16,56,PACKAGE
V=SOT-23

[Comp]
Name=Ground
Px=976,440
Rot=1

[Wire]
Pxs=968,344,976,344

[Wire]
Pxs=976,344,976,392

[Wire]
Pxs=976,344,1032,344

[Comp]
Name=Voltage Source
Px=696,464
Rot=3

[Attr]
ON=-31,-27,PART
V=V1
Style=8192

[Attr]
ON=-109,24,VALUE
V=DC 400m AC 1 0 Pulse 1 6 200n 400n 0 10
Style=8192

[Attr]
ON=0,0,PACKAGE
V

[Attr]
ON=0,0,SMOOTHING
V=N
Style=256

[Attr]
ON=0,0,Saved_PulseS
V=N
Style=256

[Attr]
ON=0,0,FRACTION
V=.2
Style=256

[Attr]
ON=0,0,Saved_PulseF
V=.2
Style=256

[Attr]
ON=0,0,Saved_Pulse
V=DC 400m AC 1 0 Pulse 1 6 200n 400n 0 10
Style=256

[Attr]
ON=0,11,Saved_PWLS
V=Q
Style=256

[Attr]
ON=0,22,Saved_PWLF
V=.2
Style=256

[Attr]
ON=0,33,Saved_PWL
V=DC 6 AC 1 0 PWL 0 ,0 0.5u, 0 1u, 10
Style=256

[Comp]
Name=Ground
Px=696,464
Rot=1

[Wire]
Pxs=696,344,696,416

[Wire]
Pxs=696,344,784,344

[Comp]
Name=Inductor
Px=968,344
Rot=6

[Attr]
ON=-33,9,PART
V=L1
Style=8192

[Attr]
ON=-42,23,INDUCTANCE
V=56n
Style=8192

[Attr]
ON=-199,37,MODEL
V=0805HP_COILCRAFT_SIMPLE

[Attr]
ON=0,0,PACKAGE
V

[Comp]
Name=Resistor
Px=1032,344

[Attr]
ON=18,6,PART
V=R7
Style=8192

[Attr]
ON=18,20,RESISTANCE
V=0.122
Style=8192

[Attr]
ON=0,0,PACKAGE
V

[Comp]
Name=BBY40
Px=1184,392
Rot=1

[Attr]
ON=16,14,PART
V=D2
Style=8192

[Attr]
ON=16,28,MODEL
V=BBY40
Style=8192

[Attr]
ON=16,56,PACKAGE
V=SOT-23

[Comp]
Name=Ground
Px=1184,440
Rot=1

[Wire]
Pxs=1176,344,1184,344

[Wire]
Pxs=1184,344,1184,392

[Comp]
Name=Inductor
Px=1176,344
Rot=6

[Attr]
ON=-33,9,PART
V=L2
Style=8192

[Attr]
ON=-42,23,INDUCTANCE
V=56n
Style=8192

[Attr]
ON=-199,37,MODEL
V=0805HP_COILCRAFT_SIMPLE

[Attr]
ON=0,0,PACKAGE
V

[Comp]
Name=Resistor
Px=1208,344

[Attr]
ON=18,6,PART
V=R8
Style=8192

[Attr]
ON=18,20,RESISTANCE
V=0.122
Style=8192

[Attr]
ON=0,0,PACKAGE
V

[Wire]
Pxs=1256,344,1328,344

[Comp]
Name=BBY40
Px=1384,392
Rot=1

[Attr]
ON=16,14,PART
V=D3
Style=8192

[Attr]
ON=16,28,MODEL
V=BBY40
Style=8192

[Attr]
ON=16,56,PACKAGE
V=SOT-23

[Comp]
Name=Ground
Px=1384,440
Rot=1

[Wire]
Pxs=1376,344,1384,344

[Wire]
Pxs=1384,344,1384,392

[Comp]
Name=Inductor
Px=1376,344
Rot=6

[Attr]
ON=-33,9,PART
V=L3
Style=8192

[Attr]
ON=-42,23,INDUCTANCE
V=56n
Style=8192

[Attr]
ON=-199,37,MODEL
V=0805HP_COILCRAFT_SIMPLE

[Attr]
ON=0,0,PACKAGE
V

[Comp]
Name=Resistor
Px=1440,344

[Attr]
ON=18,6,PART
V=R9
Style=8192

[Attr]
ON=18,20,RESISTANCE
V=0.122
Style=8192

[Attr]
ON=0,0,PACKAGE
V

[Wire]
Pxs=1384,344,1392,344

[Comp]
Name=BBY40
Px=1592,392
Rot=1

[Attr]
ON=16,14,PART
V=D4
Style=8192

[Attr]
ON=16,28,MODEL
V=BBY40
Style=8192

[Attr]
ON=16,56,PACKAGE
V=SOT-23

[Comp]
Name=Ground
Px=1592,440
Rot=1

[Wire]
Pxs=1584,344,1592,344

[Wire]
Pxs=1592,344,1592,392

[Comp]
Name=Inductor
Px=1584,344
Rot=6

[Attr]
ON=-33,9,PART
V=L4
Style=8192

[Attr]
ON=-42,23,INDUCTANCE
V=56n
Style=8192

[Attr]
ON=-199,37,MODEL
V=0805HP_COILCRAFT_SIMPLE

[Attr]
ON=0,0,PACKAGE
V

[Comp]
Name=Resistor
Px=1648,344

[Attr]
ON=18,6,PART
V=R10
Style=8192

[Attr]
ON=18,20,RESISTANCE
V=0.122
Style=8192

[Attr]
ON=0,0,PACKAGE
V

[Wire]
Pxs=1592,344,1600,344

[Comp]
Name=BBY40
Px=1800,392
Rot=1

[Attr]
ON=16,14,PART
V=D5
Style=8192

[Attr]
ON=16,28,MODEL
V=BBY40
Style=8192

[Attr]
ON=16,56,PACKAGE
V=SOT-23

[Comp]
Name=Ground
Px=1800,440
Rot=1

[Wire]
Pxs=1792,344,1800,344

[Wire]
Pxs=1800,344,1800,392

[Comp]
Name=Inductor
Px=1792,344
Rot=6

[Attr]
ON=-33,9,PART
V=L5
Style=8192

[Attr]
ON=-42,23,INDUCTANCE
V=56n
Style=8192

[Attr]
ON=-199,37,MODEL
V=0805HP_COILCRAFT_SIMPLE

[Attr]
ON=0,0,PACKAGE
V

[Comp]
Name=Resistor
Px=1848,344

[Attr]
ON=18,6,PART
V=R11
Style=8192

[Attr]
ON=18,20,RESISTANCE
V=0.122
Style=8192

[Attr]
ON=0,0,PACKAGE
V

[Comp]
Name=Resistor
Px=2864,384
Rot=1

[Attr]
ON=8,11,PART
V=R12
Style=8192

[Attr]
ON=8,25,RESISTANCE
V=10Meg
Style=8192

[Attr]
ON=0,0,PACKAGE
V

[Comp]
Name=Ground
Px=2864,432
Rot=7

[Wire]
Pxs=2864,344,2864,384

[Wire]
Pxs=1080,344,1128,344

[Wire]
Pxs=1184,344,1208,344

[Wire]
Pxs=1488,344,1536,344

[Wire]
Pxs=1696,344,1744,344

[Wire]
Pxs=1800,344,1848,344

[Comp]
Name=Resistor
Px=856,344

[Attr]
ON=18,6,PART
V=R40
Style=8192

[Attr]
ON=18,20,RESISTANCE
V=0.122
Style=8192

[Attr]
ON=0,0,PACKAGE
V

[Wire]
Pxs=832,344,856,344

[Wire]
Pxs=904,344,920,344

[Wire]
Pxs=1392,344,1440,344

[Wire]
Pxs=1600,344,1648,344

[Comp]
Name=BBY40
Px=1960,392
Rot=1

[Attr]
ON=16,14,PART
V=D6
Style=8192

[Attr]
ON=16,28,MODEL
V=BBY40
Style=8192

[Attr]
ON=16,56,PACKAGE
V=SOT-23

[Comp]
Name=Ground
Px=1960,440
Rot=1
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
