akier900/Capstone_Rohde-Schwarz_Team13/(commit log)

2020-02-14 Added most current PDS and articles for modeling methods
2020-04-15 Added Altium Files, Revised PDS, and a few other selected files
    [RedesignVaractorTline144Mhz.GBL, RedesignVaractorTline144Mhz.GBO, RedesignVaractorTline144Mhz.GBP, RedesignVaractorTline144Mhz.GBS, RedesignVaractorTline144Mhz.GKO, RedesignVaractorTline144Mhz.GM1, RedesignVaractorTline144Mhz.GTL, RedesignVaractorTline144Mhz.GTO]
2020-04-17 Create RiseTimeVsDCBIASVsLength.pdf
    Added plots of transient sims.
    I used a performance plot to show how rise time is affected by DC bias and NTLT Length at the same time. The source waveform is stepped from (0 to 5V) through (5 to 10V) in 0.5V increments and NTLT consists of 100 ladder sections.
2020-04-22 Added some reference material for verilog A-modules and pictures of assmebled board
2020-04-22 drafting bby40 verilog-A model (using .v extension for syntax highlighting in editor to help catch errors. final form must be .va extension)
    [BBY40.v]
2020-04-22 Project Schedule Printout
2020-04-29 Added new VNA measurements and measurements for capacitance vs reverse voltage
    [bby40Measurement.xlsx]
2020-04-29 Added Capacitance vs Reverse Voltage Measurements for SMV1249
    Added formatting to both varactor measurement excel sheets as well. Measurements were taken by unsoldering BBY40 from build test fixture and soldering in SMV1249 in its place.
    [SMV1249_CapVsReverseVoltage.xlsx, bby40Measurement.xlsx]
2020-05-10 changed scale for model import. idea abandoned
    [bby40Measurement.csv, bby40Measurement.xlsx]
2020-05-10 Added updated microcap schematic
    Added Fixed scale of frequency response. Added measurements of VSWR, MismatchLoss, ReturnLoss, and ReflectionCoefficient by use of define statements. Added N-port circuit with imported .s2p data from nanoVNA measurement last month. This is all to create 1 schematic and to plot measured vs simulated data against each other.
2020-05-18 Added R and S measurement pictures
    [SMV1249_CapVsReverseVoltage.xlsx, bby40Measurement.xlsx]
2020-06-01 Added Macro File for easier NLTL Chaining and changed Plot and analysis settings to show proper spectrum
2020-06-03 added board characterization section and additional resources in bib.
2020-06-03 Fixed negative Resistance in doc and added a sim file for risetime
2020-06-14 Lots of changes and added graphics for final report including block diagrams, Excel Data, Test Plan information
    [Measurement_Processing_Data.xlsx, Measurement_Processing_Data_Sheet1.png.xlsx]
2020-06-15 Final Update.
    Added Capstone Final Report, Final White paper, updates to sim files, and added inkscape images to include in white paper and capstone final report. Also adding a compiled excel table of all transient measurement data and test equipment.
    [Measurements_table.csv, Sims_table.csv]
