akier900/Capstone_Rohde-Schwarz_Team13/(notices)

Notices in the files:
RohdeAndSchwarzWhitePaper/Draft_White_Paper.tex:
% This work is distributed under the LaTeX Project Public License (LPPL) % (
