akier900/Capstone_Rohde-Schwarz_Team13/Measurements/Capacitance/BBY40_capacitance_testfixture - Copy.jpg

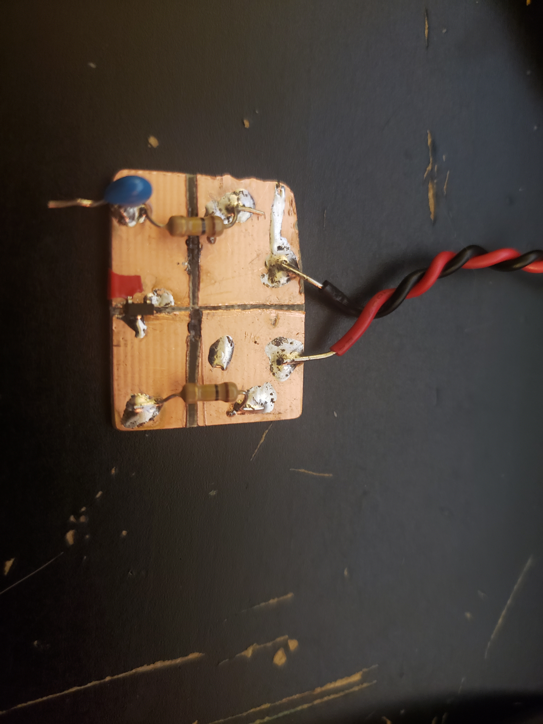
[picture p24: RohdeAndSchwarzWhitePaper/images/BBY40_capacitance_testfixture.jpg]
Measurements/Capacitance/BBY40_capacitance_testfixture - Copy.jpg
