akier900/Capstone_Rohde-Schwarz_Team13/RohdeAndSchwarzWhitePaper/images/BoardsWithPicoPulse.JPG

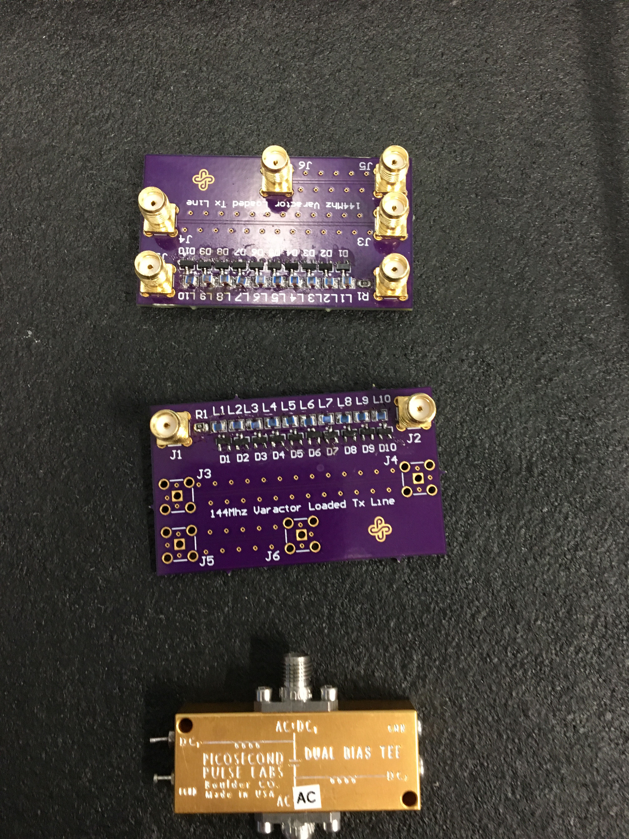
RohdeAndSchwarzWhitePaper/images/BoardsWithPicoPulse.JPG
