akier900/Capstone_Rohde-Schwarz_Team13/RohdeAndSchwarzWhitePaper/images/IMG_0131.JPG

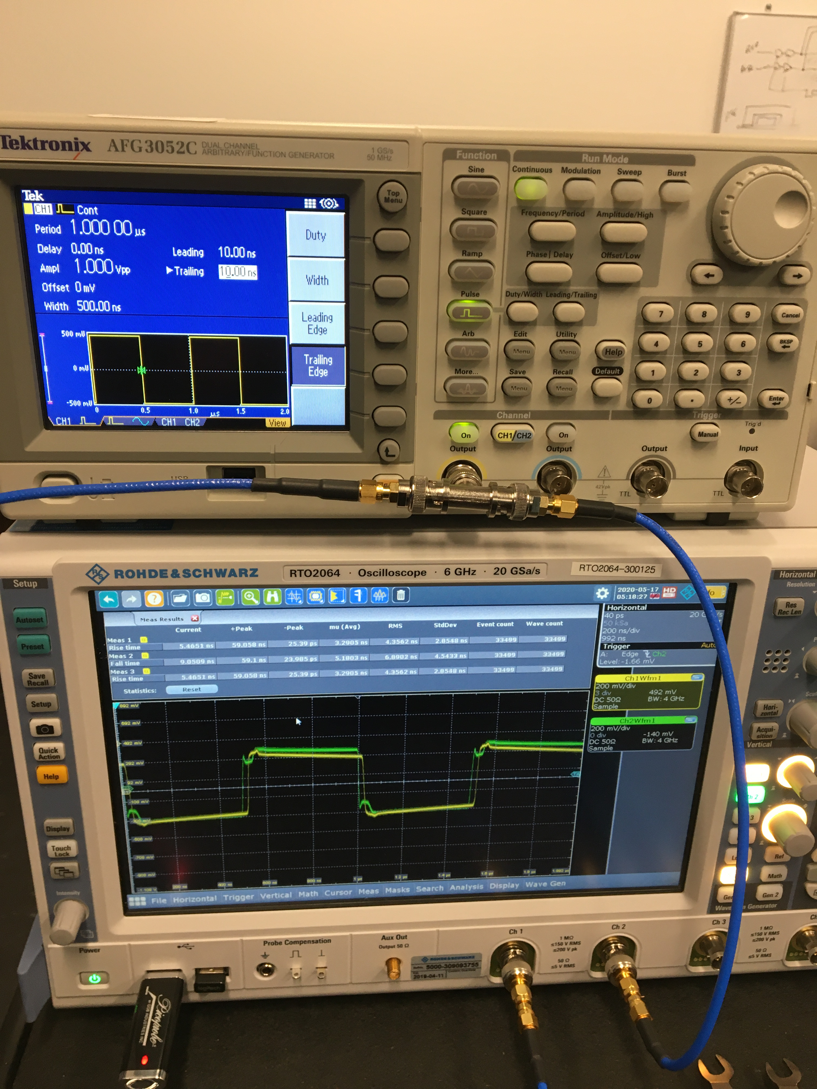
RohdeAndSchwarzWhitePaper/images/IMG_0131.JPG
