akier900/Capstone_Rohde-Schwarz_Team13/RohdeAndSchwarzWhitePaper/images/DUT_TestSetup.JPG

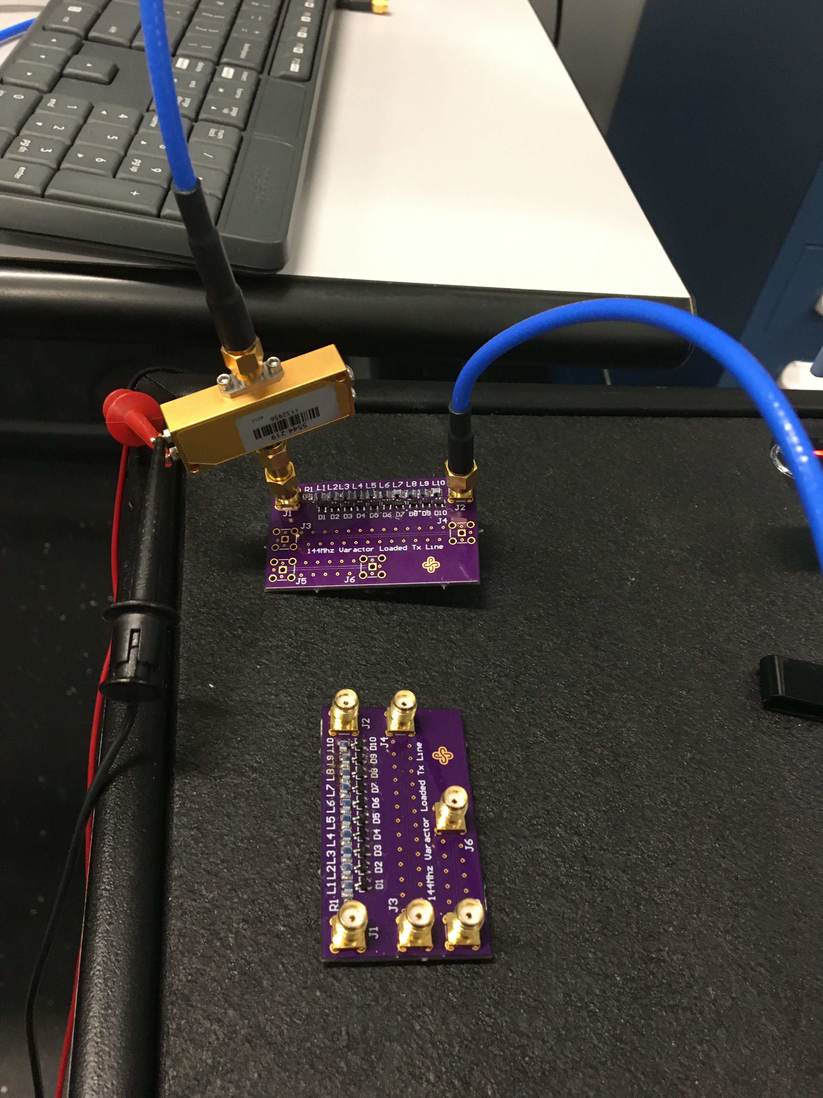
RohdeAndSchwarzWhitePaper/images/DUT_TestSetup.JPG
